tud-pses/ucboard/README.md

# ucboard
Firmware for the µController used in the pses robot.

For a more in depth documentation of the project,
please read the provided ucboard.pdf file in the repository.

You can also browse through the [wiki](https://github.com/tud-pses/ucboard/wiki) of this repository.
