tud-pses/ucboard/doc/latex/inc/kommunikation.tex

\chapter{Kommunikation}

\section{Prinzip}

Die Kommunikation mit dem ucboard ist textbasiert, so dass eine Bedienung über ein einfaches Terminalprogramm möglich ist. Dies ermöglicht ein einfaches Testen und Debuggen. Um dennoch ein einfaches Parsen der Nachrichten zu ermöglichen, besitzen diese ein definiertes Format.

In der Regel sind alle Nachrichten auch einfach lesbar. Um bezüglich der Messdatenerfassung etwas platzeffizienter zu sein, können diese jedoch optional als hex- oder base64-codierte Binärdaten versendet werden.

Ebenso wird in der Regel auf Prüfsummen verzichtet. Lediglich bei Messdaten, die als Binärdaten verschickt werden, kann optional eine CRC16-Prüfsumme angehängt werden. (Bei manchen Befehlen zum ucboard besteht die Möglichkeit, die wesentliche Zahl doppelt zu senden.)

Messdaten und Textnachrichten können vom ucboard ohne Auf"|forderung versendet werden. Ansonsten reagiert das ucboard auf Befehle, die an dieses geschickt werden. Dabei wird jeder Befehl durch eine Antwort quitiert.

\begin{itemize}
	\item Die Nachrichten zum ucboard sollen sich möglichst einfach Parsen lassen. Die Nachrichten bestehen aus einem oder mehreren, durch Leerzeichen getrennte Wörter. Der Typ eines Wortes ergibt sich aus dem ersten Zeichen:
		\begin{itemize}
			\item \texttt{A} - \texttt{Z} und \texttt{\_}: String
			\item \verb+~+: Optionsname
			\item \texttt{0} - \texttt{9} und \texttt{-}: Zahl
		\end{itemize}
	\item Besteht eine Nachricht aus mehreren Wörtern, so spielt die Anzahl der Leerzeichen zwischen den Wörtern keine Rolle. (Mindestens eines!)
\end{itemize}

Prinzipiell wird nicht zwischen Groß- und Kleinschreibung unterschieden.

Eine Nachricht beginnt mit einem Startzeichen und endet mit einem Endezeichen. Das Startzeichen kann variieren. Bei Nachrichten zum ucboard ist dieses \texttt{!} oder \texttt{?}. Nachrichten vom ucboard beginnen mit zwei Startzeichen. Das erste Zeichen ist immer \verb|\02| (STX), danach folgt \texttt{:}, \texttt{'} oder \texttt{\#}. Nach den Startzeichen kann, muss aber kein Leerzeichen folgen. Alle alphanumerischen Startzeichen (also nicht \verb|\02|) dürfen auch innerhalb der Nachrichten verwendet werden. Dort haben sie keine besondere Bedeutung.

Das Endezeichen ist \verb|\n| (newline) bei Nachrichten zum ucboard und \verb|\03| (ETX) bei Nachrichten vom ucboard.

Die Motivation hinter der unterschiedlichen Behandlung von Nachrichten zum und Nachrichten vom ucboard ist die, dass damit bei Nachrichten zum ucboard zu Debug-Zwecken ein einfaches Terminalprogramm verwendet werden kann, bei Nachrichten vom ucboard jedoch auch mehrzeiliger Text sinnvoll dargestellt werden kann und ein einfaches Identifizieren des Nachrichtenbeginns möglich ist.

Einzelne Zeilenumbrüche außerhalb von Nachrichten sind zu ignorieren. (Diese werden optional nach ETX vom ucboard verwendet, um die Darstellung im Terminalprogramm zu verbessern.)

\subsubsection{Zu ucboard}
\begin{itemize}
	\item Befehle beginnen mit \texttt{!}
	\item Abfragen beginnen mit \texttt{?}
	\item Antworten auf Fragen des ucboard (im interaktiven Modus) besitzen keinen speziellen Beginn. (Sie dürfen aber auch mit \texttt{!} oder \texttt{?} beginnen.
	\item Das Ende einer Nachricht wird ausschließlich durch \texttt{\textbackslash n} (newline) markiert
	\item Optionen beginnen mit \verb+~+. Wenn der Option ein Wert zugeordnet wird, dann wird dieser nach einem \texttt{=} angeschlossen. Dabei dürfen um das Gleichheitszeichen herum keine Leerzeichen stehen!
	\item Die Reihenfolge der Argumente spielt eine Rolle. Die Position der Optionen spielt keine Rolle. (Bei Verarbeiten im ucboard wird zunächst eine Liste der Argumente und eine Liste der Optionen erstellt. Die Information, ob eine Option am Anfang, zwischen zwei Argumenten oder am Ende stand geht dabei verloren.)
\end{itemize}

\subsubsection{Von ucboard}
\begin{itemize}
	\item Nachrichten beginnen immer mit \verb|\02| (STX).
	\item Direkte Antworten beginnen (nach STX) mit \texttt{:}
	\item Auch jeder Schreibbefehl sollte eine kurze Antwort zur Quittierung senden, \zB \verb+:ok\n+. Es wäre empfehlenswert, den gesetzten Wert zu wiederholen
	\item Fehler bei der Abarbeitung von Befehlen beginnen mit \texttt{:ERR(code)}, wobei \texttt{code} eine positive Ganzzahl als Fehlercode ist. Optional kann nach einem weiteren Doppelpunkt eine Beschreibung des Fehlers folgen: \texttt{:ERR(code):Beschreibung} 
	\item Textausgaben (Display-Funktion) beginnen (nach STX) mit \texttt{'}
	\item Fehlermeldungen sind Textausgaben. Diese beginnen mit \texttt{'ERR(code)}, wobei \texttt{code} eine positive Ganzzahl als Fehlercode ist. Optional kann nach einem weiteren Doppelpunkt eine Beschreibung des Fehlers folgen: \texttt{'ERR(code):Beschreibung} 
	\item Ohne Auf"|forderung versendete Messdaten beginnen (nach STX) mit \texttt{\#}.
	\item Wenn eine Nutzerinteraktion notwendig ist, dann sollte das letzte Zeichen vor dem Nachrichtendezeichen ein \texttt{?} oder \texttt{:} sein.
	\item Alle Nachrichten vom ucboard haben ETX (0x03) als Endzeichen. (Dadurch ist es möglich, eine mehrzeilige Ausgabe auf dem Terminalprogramm zu erzeugen.)
		\begin{itemize}
			\item Über eine -- aktuell noch fest eingestellte Option -- wird nach jedem ETX automatisch ein Zeilenumbruch geschickt. Dies dient der besseren Lesbarkeit. Es wäre jedoch besser, ein Terminalprogramm zu verwenden (\bzw zu schreiben), welches ETX durch einen Zeilenumbruch ersetzt. Damit wäre sowohl der Text besser lesbar als auch der Sparsamkeit Rechnung getragen.
			%\item Für die bessere Lesbarkeit ist es empfehlenswert, alle Textnachrichten mit einem Zeilenumbruch (vor ETX) abzuschließen. Lediglich bei hex- oder base64-basierten Messdatennachrichten wird dies nicht gemacht, da diese gerade für eine sparsame Kommunikation gedacht sind.
		\end{itemize}
\end{itemize}

\section{Hardware}

Das ucboard verfügt über zwei Schnittstellen für die Kommunikation mit dem PC. Zum einen kann über einen USB-Anschluss eine serielle Kommunikation aufgebaut werden und zum anderen kann eine RS232-Schnittstelle verwendet werden. Die RS232-Schnittstelle wird dabei nicht als Standard-D-SUB-Stecker (9-polig) angeboten, sondern als Wannensteckeranschluss. Dieser ist so belegt, dass eine direkte Verbindung zu den Anschlüssen des Onboard-PC über ein Flachbandkabel erfolgen kann.

Der dritte, "`reine"' UART-Anschluss ist für den Anschluss möglicher Erweiterungen und nicht die Kommunikation mit dem PC vorgesehen.\footnote{Man könnte auch noch darüber nachdenken, die dritte UART auch für die Kommunikation mit einem PC zu verwenden, da an dieser einfach ein Bluetooth-Adapter angeschlossen werden könnte. Damit wäre es möglich, auch ohne den Onboard-PC das Fahrzeug ferngesteuert zu betreiben.}

Die Parameter der Schnittstellen sind in \tabref{tab:Comm:UARTParam} zusammengefasst.

\begin{table}%
	\centering
	\caption{Einstellungen serielle Schnittstellen}
	\label{tab:Comm:UARTParam}
	\begin{tabular}{lcr}
			\mytoprule
			 & USB & RS232 \\
			\mymidrule
			Baudrate & 921\,600 & 115\,200 \\
			Datenbits & 8 & 8 \\
			Stopbits & 1 & 1 \\
			Parity & keine & keine \\
			Hardware-Flowcontrol & Nein & Nein \\
			\mybottomrule
	\end{tabular}\\
	\color[rgb]{1,0,0}{ToDo: Testen, welche Baudrate jeweils maximal möglich ist!} \textcolor[rgb]{0.75,0.75,0.75}{\footnotesize{Man könnte dies auch über einen Befehl einstellbar machen, und ein Rücksetzen darüber erreichen, dass beim Starten des ucboards \zB der Taster A betätigt wird. Aber das erscheint mir für diesen Zweck unnötig.}}
\end{table}

\section{Befehle}

\subsection{Übersicht}

\begin{table}[htbp]%
	\centering
	\caption{Übersicht über Hauptbefehle ucboard}
	\label{tab:Comm:Cmds}
	\begin{tabular}{ll}
		\mytoprule
		\verb|RESET| & Neustart ucboard \\
		\verb|VER| & Abfrage Softwareversion \\
		\verb|ID|	& Abfragen der Fahrzeug-ID \\
		\verb|SID| & Setzen und Abfragen der Session-ID \\
		\verb|TICS| & Abfrage ucboard-Zeit (Millisekunden nach (Neu)start) \\
		\verb|STEER| & Setzen und Abfragen des (Soll-)Lenkwinkels \\
		\verb|DRV| & Setzen und Abfragen der Fahrgeschwindigkeit \\
		\verb|DAQ| & Datenerfassung \\
		\verb|VOUT| & Ein- und Ausschalten \valunit{12}{V}-Ausgang (Kinect) \\
		\texttt{IMU} & Zum Parametrieren der IMU \\
		\texttt{MAG} & Zum Parametrieren des Magnetometers \\
		\texttt{US} & Zum Parametrieren der US-Sensoren \\
		\textcolor[rgb]{0.75,0.75,0.75}{\texttt{EEPROM}} & \textcolor[rgb]{0.75,0.75,0.75}{Zum Auslesen des EEPROM-Inhalts}\\
		\verb|LED| & Ansteuerung der LEDs A und B auf dem Board \\
		\mybottomrule
	\end{tabular}
\end{table}

\textbf{Wichtig:} Momentan werden numerische Eingaben noch nicht an allen Stellen daraufhin überprüft, ob es tatsächlich eine (Ganz)Zahl ist. Dies bedeutet, dass \zB Eingaben wie \verb|1000.|, \verb|1000.0| oder auch \verb|+1000| für Tausend eine unerwartete Zahl ergibt.

\subsection{Beschreibung}

\subsubsection{RESET}

Führt einen Neustart des ucboards durch.

\begin{verbatim}
	!RESET NOW
\end{verbatim}

\subsubsection{VER}

Fragt Versionsstring der ucboard-Software ab.

\begin{verbatim}
	?VER
	:0.1.x
\end{verbatim}

\subsubsection{ID}

Zur Abfrage der Fahrzeug-ID, also der Nummer, die über die Dipschalter auf der Platine eingestellt wird.

\begin{verbatim}
	?ID
	:4
\end{verbatim}

\subsubsection{SID}

Zum Abfragen und Setzen der Session-ID. Dies ist einfach eine Zahl, die nach einem Neustart des ucboards auf 0 gesetzt wird, und der beliebige \verb|uint32|-Werte gegeben werden können.

\begin{verbatim}
	?SID
	:0
\end{verbatim}

\begin{verbatim}
	!SID 25363
	:25363
\end{verbatim}

\begin{verbatim}
	?SID
	:25363
\end{verbatim}

\subsubsection{STEER}

Zum Setzen und Abfragen des Soll-Lenkwinkels (Servo-Vorgabe). Der Wert muss eine Ganzzahl zwischen $-1\,000$ und $1\,000$ sein.

Setzen:
\begin{verbatim}
	!STEER -200
	:-200
\end{verbatim}

Optionale Wiederholung des Arguments, um Fehlübertragungen zu detektieren:
\begin{verbatim}
	!STEER -200 -200
	:-200
\end{verbatim}

\begin{verbatim}
	!STEER -200 -201
	:ERR(269): Message corrupted! (The two values have to be equal!)
\end{verbatim}

Abfragen:
\begin{verbatim}
	?STEER
	:-200
\end{verbatim}

\subsubsection{DRV}

Zum Setzen und Abfragen der Fahrgeschwindigkeit. (\Bzw Motorspannung.)

Es gibt zwei Modi: Die "`gemanagte"' und die "`direkte"' Ansteuerung. Siehe dazu \secref{sec:hw:drivectrl}.

\paragraph{Gemanagte Ansteuerung}

Bei der gemanagten Ansteuerung erfolgt die Umschaltung von Vorwärts- und Rückwärtsfahrt automatisch. Zudem wird der gesetzte Wert in den Arbeitsbereich umgerechnet.

Vorwärtsfahrt:
\begin{verbatim}
	!DRV F 300
	:F 300
\end{verbatim}
Optionale Wiederholung des Arguments, um Fehlübertragungen zu detektieren:
\begin{verbatim}
	!DRV F 300 300
	:F 300
\end{verbatim}

\begin{verbatim}
	!drv f 300 301
	:ERR(269): Message corrupted! (The two values have to be equal!)
\end{verbatim}

Es sind Werte von -500 bis 1000 zulässig. Dabei entsprechen negative Werte Bremsen (aber nicht einer Rückwärtsfahrt!).

Die effektive Auf"|lösung ist geringer als der Stellbereich von 1000 es annehmen lässt. Tatsächlich können etwas weniger als 450 unterscheidbare Impulsbreiten, \dah Sollwerte, vorgegeben werden.

Bremsen
\begin{verbatim}
	!DRV F -500
	:F -500
\end{verbatim}
Gebremst wird vom Fahrtenregler automatisch nur bis zum Stillstand. Es erfolgt keine Rückwärtsfahrt.

Rückwärtsfahrt
\begin{verbatim}
	!DRV B 300
	:B 300
\end{verbatim}
Es sind Werte von 0 bis 500 zulässig. (Der Stellbereich des Fahrtenreglers ist rückwärts nur halb so groß wie vorwärts.)

Ausschalten des Fahrtenreglers:
\begin{verbatim}
	!DRV OFF
	:OFF
\end{verbatim}
Der Unterschied zwischen den Werten 0 und \verb|OFF| liegt darin, dass bei \verb|OFF| der Fahrtenregler vom Fahrakku getrennt wird, also tatsächlich ausgeschaltet ist. Der Fahrtenregler wird bei Übermittlung des nächsten Sollwertes ungleich \verb|OFF| automatisch wieder eingeschaltet, jedoch dauert dies einen Moment. (Das Einschalten wird auch mit einem Piepston des Fahrtenreglers begleitet.)

Abfragen:
\begin{verbatim}
	?DRV
	:F 300
\end{verbatim}

Abfragen der tatsächlichen Impulsbreite (vergleiche "`Direkte Ansteuerung"'):
\begin{verbatim}
	?DRV D
	:D -186
\end{verbatim}

\paragraph{Direkte Ansteuerung}
Bei der direkten Ansteuerung wird direkt die Impulsbreite vorgegeben, die an den Fahrtenregler übertragen wird. Dabei wird die Impulsbreite als die Abweichung in Mikrosekunden vom Neutralwert \valunit{1,5}{ms} angegeben. \Dah ein Wert von $-500$ entspricht der minimalen Impulsbreite (\dah Maximalwert \emph{vorwärts}) von \valunit{1}{ms} und ein Wert von 500 der maximalen Impulsbreite von \valunit{2}{ms}.

\begin{verbatim}
	!DRV D 200
	:D 200
\end{verbatim}

\paragraph{DMS}

Die Totmannschaltung (DMS -- Dead-man switch) soll insbesondere im Entwicklungsstatus der PC-Software und der Algorithmen verhindern, dass das Fahrzeug bei abgestürztem PC oder abgestürzten ROS-Nodes weiterfährt.

Dieser Parameter gibt die Zeit in Millisekunden an, innerhalb derer eine neue DRV-Nachricht erhalten sein muss. Wird diese Zeit ohne DRV-Nachricht überschritten, so wird der Motor gestoppt, \dah der Sollwert auf 0 (aber nicht \texttt{OFF}) gesetzt. Bei der nächsten \texttt{DRV}-Nachricht wird der Motor dann wieder angesteuert.

\begin{verbatim}
	!DRV ~DMS=1000
	:~DMS=1000
\end{verbatim}
Zum Abschalten der Sicherheitsschaltung dient der Wert \texttt{0}.

DRV kann auch ohne Parameter aufgerufen werden. Dann dient er nur dazu, die Zeitzählung der Totmannschaltung neu zu starten.

\begin{verbatim}
	!DRV
	:ok
\end{verbatim}

Abfrage der DMS-Abschaltzeit zusammen mit dem aktuellen DRV-Wert:
\begin{verbatim}
	?DRV ~DMS
	:OFF ~DMS=1000
\end{verbatim}

\subsubsection{DAQ}

Das Datenerfassungsmodul (DAQ -- Data Aquisition) dient als allgemeine Schnittstelle zur Übermittlung aller Sensorsignale. Dabei können Einzelabfragen vorgenommen werden (die angefragten Sensorwerte werden direkt als Antwort auf einen entsprechenden Befehl verschickt) als auch Gruppen von Sensorsignale eingerichtet werden, die dann automatisch vom ucboard an den PC geschickt werden.

Die Sensorsignale werden dabei hier als "`Kanäle"' bezeichnet. Die aktuell definierten Kanäle sind in \tabref{tab:Comm:DAQ:Signals} zusammengefasst.

\begin{table}[htbp]%
	\centering
	\caption{DAQ-Kanäle (Signale)}
	\label{tab:Comm:DAQ:Signals}
	\begin{tabular}{lp{8cm}lll}
		\mytoprule
		Kanal & Beschreibung & Einheit & Datentyp & Länge \\
		\mymidrule
		\verb|AX| & Beschleunigung $x$-Richtung & $\to$ \eqref{eq:hw:IMU:ACCScale} & \verb|int16_t| & 2 \\
		\verb|AY| & Beschleunigung $y$-Richtung & $\to$ \eqref{eq:hw:IMU:ACCScale} & \verb|int16_t| & 2 \\
		\verb|AZ| & Beschleunigung $z$-Richtung & $\to$ \eqref{eq:hw:IMU:ACCScale} & \verb|int16_t| & 2 \\
		\verb|GX| & Drehrate um $x$-Achse & $\to$ \eqref{eq:hw:IMU:GYROScale} & \verb|int16_t| & 2 \\
		\verb|GY| & Drehrate um $y$-Achse & $\to$ \eqref{eq:hw:IMU:GYROScale} & \verb|int16_t| & 2 \\
		\verb|GZ| & Drehrate um $z$-Achse & $\to$ \eqref{eq:hw:IMU:GYROScale} & \verb|int16_t| & 2 \\
		\verb|MX| & Magnetische Flussdichte in $x$-Achse & \valunit{0,15}{\upmu T} & \verb|int16_t| & 2\\
		\verb|MY| & Magnetische Flussdichte in $y$-Achse & \valunit{0,15}{\upmu T}  & \verb|int16_t| & 2\\
		\verb|MZ| & Magnetische Flussdichte in $z$-Achse & \valunit{0,15}{\upmu T}  & \verb|int16_t| & 2\\
		\verb|USF| & Abstand vorne & \valunit{0,1}{mm} & \verb|uint16_t| & 2 \\
		\verb|USL| & Abstand links & \valunit{0,1}{mm} & \verb|uint16_t| & 2 \\
		\verb|USR| & Abstand rechts & \valunit{0,1}{mm} & \verb|uint16_t| & 2 \\
		\verb|VSBAT| & Spannung Systemakku & mV & \verb|uint16_t| & 2\\
		\verb|VDBAT| & Spannung Fahrakku & mV & \verb|uint16_t| & 2\\
		\verb|HALL_DT| & Zeit zwischen den letzten beiden Impulsen des Hallsensors (eine Achtel Radumdrehung) & \valunit{0,1}{ms} & \verb|uint16_t| & 2\\
		\verb|HALL_DT8| & Zeit zwischen den letzten acht Impulsen des Hallsensors (eine Radumdrehung) & \valunit{1}{ms} & \verb|uint16_t| & 2\\
		\verb|HALL_CNT| & Anzahl der Sensorimpulse, Modulo 256 (Ein Sensorwert von "`1"' entspricht dabei immer eine ungeraden Zahl) & -- & \verb|uint8_t| & 1\\
		\verb|PBA| & Zähler Betätigung Taster A, Modulo 256 (Gerade Werte: Unbetätigt, Ungerade Werte: Betätigt)  & -- & \verb|uint8_t| & 1\\
		\verb|PBB| & wie \verb|PBA| für Taster B & -- & \verb|uint8_t| & 1\\
		\verb|PBC| & wie \verb|PBA| für Taster C & -- & \verb|uint8_t| & 1\\
		\mybottomrule
	\end{tabular}
\end{table}

Zur Übermittlung von Fehlerwerten sind bestimmte Zahlenwerte oder Textausgaben vorgesehen, die in \tabref{tab:Comm:DAQ:SpecialValues} aufgeführt sind. Dabei ist "`keine Daten vorhanden"' ein Wert, der vom DAQ-Modul selber gesetzt werden, wenn keine gültigen Daten vorliegen. Die einzelnen Sensormodule geben im Fehlerfall entweder "`Messfehler"' (bei einzelnen Messfehlern oder Messaussetzern) oder "`Sensorfehler"' (ein größeres Sensorproblem, \dah es ist in diesem Fall mit dem Ausfall aller (weiteren) Messwerten zu rechnen) zurück.

\begin{table}[htbp]%
	\centering
	\caption{Fehlerwerte}
	\label{tab:Comm:DAQ:SpecialValues}
	\subfloat[Binärcodierung]{%
		\begin{tabular}{lcccccc}
			\mytoprule
			Datentyp & \texttt{uint32\_t} & \texttt{int32\_t} & \texttt{uint16\_t} & \texttt{int16\_t} & \texttt{uint8\_t} & \texttt{int8\_t} \\
			\mymidrule
			Keine Daten vorhanden & \texttt{0xFFFFFFFF} & \texttt{0x7FFFFFFF} & \texttt{0xFFFF} & \texttt{0x7FFF} & \texttt{0xFF} & \texttt{0x7F} \\
			Messfehler & \texttt{0xFFFFFFFE} & \texttt{0x7FFFFFFE} & \texttt{0xFFFE} & \texttt{0x7FFE} & \texttt{0xFE} & \texttt{0x7E} \\
			Sensorfehler & \texttt{0xFFFFFFFD} & \texttt{0x7FFFFFFD} & \texttt{0xFFFD} & \texttt{0x7FFD} & \texttt{0xFD} & \texttt{0x7D} \\
			Wert zu groß oder zu klein  & \texttt{0xFFFFFFFC} & \texttt{0x7FFFFFFC} & \texttt{0xFFFC} & \texttt{0x7FFC} & \texttt{0xFC} & \texttt{0x7C} \\
			Wert zu groß  & \texttt{0xFFFFFFFC} & \texttt{0x7FFFFFFC} & \texttt{0xFFFC} & \texttt{0x7FFC} & \texttt{0xFC} & \texttt{0x7C} \\
			Wert zu klein & \texttt{0xFFFFFFFB} & \texttt{0x7FFFFFFB} & \texttt{0xFFFB} & \texttt{0x7FFB} & \texttt{0xFB} & \texttt{0x7B} \\
			\mybottomrule
		\end{tabular}}\\
	\subfloat[Textausgabe]{%
		\begin{tabular}{lc}
			\mytoprule
			 & \\
			\mymidrule
			Keine Daten vorhanden & \texttt{[-{}-{}-]}  \\
			Messfehler & \texttt{[mfault]}  \\
			Sensorfehler & \texttt{[fault]} \\
			Wert zu groß oder zu klein & \texttt{[range]} \\
			Wert zu groß  & \texttt{[over]}  \\
			Wert zu klein & \texttt{[under]} \\
			\mybottomrule
		\end{tabular}}
\end{table}

\paragraph{Allgemeines}

Alle aktuell definierten Kanäle können mit \verb|?DAQ CHS| abgefragt werden:
\begin{verbatim}
	?DAQ CHS
	:14
	AX         | acc. ahead                     | opt-dep.!       | 1     | I16 
	AY         | acc. left                      | opt-dep.!       | 1     | I16 
	[...]
	HALL_DT8   | delta time full rev.           | 1 ms            | undef | U16 
\end{verbatim}
Dabei beinhalten die Spalten die folgenden Informationen
\begin{itemize}
	\item Name
	\item Beschreibung
	\item Einheit (\verb|opt-dep.!| bedeutet, dass die Einheit von den jeweiligen Sensoreinstellungen abhängt.)
	\item Abtastzeit in Millisekunden (\verb|undef| bedeutet, dass das entsprechende Sensormodul keine feste Abtastzeit der Messwerte garantiert.)
	\item Datentyp
\end{itemize}

Die Informationen zu einem speziellen Kanal können über
\begin{verbatim}
	?DAQ CH name
\end{verbatim}
abgefragt werden:
\begin{verbatim}
	?DAQ CH USF
	:USF        | ultrasonic front distance      | 0.1 mm          | undef | U16
\end{verbatim}

\paragraph{Einzelabfrage von Werten}

Zur Abfrage von Einzelwerten dient der Subbefehl \verb|GET|:
\begin{verbatim}
	?DAQ GET chname1 [chname2 [chname3 [...]]] [~AGE] [~TICS]
\end{verbatim}
Diesem muss mindestens der Name eines Kanals übergeben werden. Es können aber auch mehrere Kanäle auf einmal abgefragt werden. Die Option \verb|~AGE| gibt zu \emph{jedem} Wert das Alter in Tics (\dah ms) zwischen dem Zeitpunkt der Datenerfassung und der Datenabfrage zurück. Die Option \verb|~TICS| gibt zu \emph{jedem} Wert den Erfassungszeitpunkt in Tics zurück. Sind beide Optionen gewählt, dann wird immer AGE vor TICS zurückgegeben, unabhängig von der Reihenfolge der Optionen.

Beispiele:

\begin{itemize}
	\item Einzelabfrage des Sensorwertes des vorderen Ultraschallsensors
		\begin{verbatim}
			?DAQ GET USF
			:1860
		\end{verbatim}
	\item Ausgabe des Alters des Messwertes
		\begin{verbatim}
			?DAQ GET ~AGE USF
			:1860 68
		\end{verbatim}
	\item Abfrage aller Ultraschallwerte, jeweils mit Alter
		\begin{verbatim}
			?DAQ GET ~AGE USL USF USR
			:487 72 | 1860 75 | 4293 85
		\end{verbatim}
	\item Ausgabe der ucboard-Zeit des Messwerts
		\begin{verbatim}
			?DAQ GET ~TICS USF
			:1860 3059246
		\end{verbatim}
\end{itemize}

\paragraph{Automatische Messgruppen}

Es stehen zwanzig parametrierbare Messgruppen zur Verfügung, die zum automatischen Verschicken von Messdaten verwendet werden. In diesen können bis zu zehn verschiedene Kanäle (Sensorwerte) zusammengefasst werden. Neben den normalen Kanälen stehen noch die in \tabref{tab:Comm:DAQ:SpecialChannels} aufgeführten "`Sonderkanäle"' zur Verfügung, die Metadaten zu den Datensätzen enthalten. (Diese stehen bei der Einzelabfrage über \verb|?DAQ GET chname| nicht zur Verfügung.)

Es wird je Gruppe immer nur ein Messdatensatz gepuffert. Kann dieser nicht verschickt werden, bis die nächste Abtastung der Gruppe erfolgt ist, so wird dieser verworfen. Dabei werden alle Gruppen gleichberechtigt behandelt, \dah es erfolgt keine Bevorzugung von Messgruppen mit kleiner Abtastzeit. Damit ist die Wahrscheinlichkeit gering, dass bei langsam abgetasteten Messgruppen Daten verlorengehen, auch wenn viel Bandbreite für Messgruppen mit kleiner Abtastzeit belegt wird.\footnote{An dieser Stelle muss noch angemerkt werden, dass das Management der zu versendenden Daten im Idle-Task des ucboards erfolgt. \Dah während der Datenerfassung im SysTick-Task werden keine neuen Daten zum Verschicken bereit gemacht, auch wenn der letzte Datensatz abgearbeitet ist. Damit ist der erreichbare Datendurchsatz kleiner als der sich theoretisch aus der Baudrate ergebenden Wert. Dies kann \bzw sollte in Zukunft noch geändert werden. Bisher benötigt der SysTick-Task weniger als \valunit{200}{\upmu s}. Damit würde im ungünstigsten Fall die Datenrate ein Fünftel "`verlieren"'.}

Eine Messgruppe wird über den Subbefehl \verb|GRP| definiert.
\begin{verbatim}
	!DAQ GRP grpnb chname1 [chname2 [chname3 [...]]] [~option1] [~option2] [...]
\end{verbatim}
Die Gruppennummer \verb|grpnb| muss eine Ganzzahl zwischen 0 und 19 sein.

Die Möglichkeiten der Gruppendefinition wird zunächst an Beispielen demonstriert. Danach werden die Optionen genauer beschrieben.
\begin{itemize}
	\item Gruppe 1 enthält die Werte des Ultraschalls. Es wird gesendet, wenn alle Ultraschallwerte vorliegen, wobei maximal \valunit{10}{ms} nach dem Erfassen des ersten Wertes gewartet wird. Die Daten werden base64-codiert und mit einer CRC16-Prüfsumme verschickt.
		\begin{verbatim}
			!DAQ GRP 1 ~ALL=10 ~ENC=B64 ~CRC _TIC USL USF USR 
		\end{verbatim}
		(Die Reihenfolge der Kanalnamen (\verb|_TIC|, \verb|USL|, \verb|USF|, \verb|USR|) spielt eine Rolle, da die Messwerte ohne Namen in dieser Reihenfolge ausgegeben werden. Die Reihenfolge der Optionen und ob diese am Anfang oder Ende oder auch zwischen den Kanalnamen stehen spielt keine Rolle.)
	\item Gruppe 2 enthält die Spannungen der beiden Akkus, wobei immer eine Nachricht verschickt wird, sobald eine neue Spannung gemessen ist.
		\begin{verbatim}
			!DAQ GRP 2 ~ANY VSBAT VDBAT 
		\end{verbatim}
	\item Gruppe 3 enthält die Beschleunigungswerte in der Ebene und die Gierrate. Die Daten werden alle \valunit{10}{ms} verschickt. Dabei werden alle innerhalb der \valunit{10}{ms} erfassten Daten gemittelt.
		\begin{verbatim}
			!DAQ GRP 3 ~TS=10 ~AVG ~ENC=B64 ~CRC AX AY GZ 
		\end{verbatim}
\end{itemize}

Optionen:
\begin{itemize}
	\item Modus Abtastung
		\begin{itemize}
			\item \verb+~ALL[=maxwait]+: Sendet, wenn zu allen Gruppenkanäle neue Daten vorhanden sind. Wenn \verb+maxwait+ gegeben ist, dann wird nach dem ersten neuen Wert maximal diese Zeit in Millisekunden gewartet, bis die Daten verschickt werden.\footnote{Dies ist \zB für die US-Sensoren gedacht, deren Daten meist an nacheinander liegenden Zeitschritten ankommen.}
			\item \verb+~ANY+: Sendet, wenn zu einem der Gruppenkanäle ein neues Datum vorhanden ist.
			\item \verb+~TS=Ts+: Abtastzeit in Millisekunden. (Muss ein ganzes Vielfaches der Abtastzeiten aller Kanäle des Paketes sein.)
			\begin{itemize}
				\item \verb+~AVG[=Ta]+: Mittelung über Zeitraum \verb|Ta|. (Nur im Abtastmodus \verb|TS| verfügbar.) Wenn die Option \verb|AVG| verwendet wird, dann müssen alle Gruppenkanäle die gleiche Abtastzeit besitzen. \verb|Ta| darf dabei maximal \verb|Ts| sein und muss ein ganzes Vielfaches der Abtastzeit der Gruppenkanäle sein. Wenn kein \verb|Ta| angegeben ist, dann wird \verb|Ta| = \verb|Ts| gesetzt.\\
				Diese Mittelung kann damit bezüglich der Sensorabtastzeit $T_\mrm{s,sig}$ über die Übertragungsfunktion
				\begin{align*}
					G_\mrm{avg}(z) = \frac{\frac{1}{n_\mrm{avg}} \cdot ( z^{n_\mrm{avg}-1} + z^{n_\mrm{avg}-2} + \cdots + 1)}{z^{n_\mrm{avg}-1}}
				\end{align*}
				mit $n_\mrm{avg} = \mathtt{Ta}/T_\mrm{s,sig}$ ausgedrückt werden. Über \verb+~TS=Ts+ wird dann eine Unterabtastung mit dem Faktor $\mathtt{Ts}/T_\mrm{s,sig}$ vorgenommen.
			\end{itemize}

		\end{itemize}
	\item \verb+~SKIP=n+: Überspringt \texttt{n} Werte. \Dah bei einem Wert von neun wird jeder zehnte Wert verwendet. Dieses Überspringen wird nach allen anderen Berechnungen und Abfragen durchgeführt. Diese Option dient primär zum Debuggen (um die Menge an ausgegebenem Text zu reduzieren), kann aber auch zur Unterabtastung für Kanäle ohne feste Abtastzeit verwendet werden. (Dabei ist dann aber keine Mittelung möglich.)
	\item \verb+~ENC=B64|HEX|ASCII+: Nachricht wird base64-codiert (ohne Padding), Hex-codiert oder Ascii-codiert. ASCII meint hierbei "`lesbaren Text"'. Standardwert ist ASCII.
	\item \verb+~CRC+: CRC16-Prüfsumme (Nur wenn ENC = B64 oder HEX)\\
		Berechnung mit:
		\begin{lstlisting}[style=C_colored_smallfont]
// from Antonio Pires, http://stackoverflow.com/questions/10564491/function-to-calculate-a-crc16-checksum

// CRC-16-CCITT (polynom 0x1021)

uint16_t crc16(uint8_t* data_p, uint16_t length)
{
	uint8_t x;
	uint16_t crc = 0xFFFF;

    while (length--)
    {
        x = (crc >> 8) ^ (*data_p++);
        x ^= (x >> 4);
        crc = (crc << 8) ^ ((uint16_t)(x << 12)) ^ ((uint16_t)(x <<5)) ^ ((uint16_t)x);
    }

    return crc;
}
		\end{lstlisting}
	\item \verb+~AGE+ und \verb+~TICS+: Wie bei Einzelwertabfrage. Damit wird \emph{jedem} Wert das Alter sowie der Erfassungszeitpunkt hinzugefügt. (Wenn beide Optionen gewählt sind, dann immer in der Reihenfolge "`Age -- Tics"'.) Die Werte werden bei der Ascii-Codierung immer innerhalb der senkrechten Striche des Kanals geschrieben. Bei Binärcodierungen werden diese Werte jeweils als \valunit{32}{bit}-Werte jeweils hinter den betreffenden Messwert eingefügt. Diese Optionen dienen lediglich zum Debuggen. Im "`Normalbetrieb"' sollten diese aufgrund des großen Platzbedarfs nicht verwendet werden!\footnote{Das Alter \texttt{AGE} bezieht sich auf den Abtastzeitpunkt des Datensatzes, nicht auf den Zeitpunkt des Versendens. Der Wert ist damit nur bei der Abtastart \texttt{ALL} relevant, da dort die Daten einer Gruppe zu unterschiedlichen Zeitpunkten abgetastet sein können. Die Zeitdifferenz zwischen Abtastzeitpunkt und Versenden kann durch den Sonderkanal \texttt{\_DLY} abgefragt werden. (Somit ist das tatsächliche Alter \texttt{AGE} + \texttt{\_DLY} plus die Zeit zur Datenübermittlung und Verzögerungen innerhalb des Betriebssystem des PCs.)}
\end{itemize}

\begin{table}[htbp]%
	\centering
	\caption{"`Sonderkanäle"' mit Metadaten}
	\label{tab:Comm:DAQ:SpecialChannels}
	\begin{tabular}{lp{10cm}lll}
		\mytoprule
		Signal & Beschreibung & & Datentyp & Länge \\
		\mymidrule
		\verb|_CNT| & Anzahl der verschickten Datensätze der Gruppe &  & \verb|uint32_t| & 4 \\
		\verb|_CNT16| & die niederwertigen \valunit{16}{bits} von \verb|_CNT| &  & \verb|uint16_t| & 2 \\
		\verb|_CNT8| & die niederwertigen \valunit{8}{bits} von \verb|_CNT| &  & \verb|uint8_t| & 1 \\[2mm]
		\verb|_TICS| & ucboard-Zeit (tics) der Erfassung des ersten Datums & ms & \verb|uint32_t| & 4 \\
		\verb|_TICS16| & die niederwertigen \valunit{16}{bits} von \verb|_TIC| & ms & \verb|uint16_t| & 2 \\
		\verb|_TICS8| & die niederwertigen \valunit{8}{bits} von \verb|_TIC| & ms & \verb|uint8_t| & 1 \\[2mm]
		\verb|_DTICS| & Delta der ucboard-Zeit zwischen ersten und letztem Datum & ms & \verb|uint32_t| & 4 \\
		\verb|_DTICS16| & min\{\verb|_DTICS|, 65\,535\} & ms & \verb|uint16_t| & 2 \\
		\verb|_DTICS8| & min\{\verb|_DTICS|, 255\} & ms & \verb|uint8_t| & 1 \\[2mm]
		\verb|_DLY| & Zeit zwischen Datensatzerstellung und Versenden, bei 255 gesättigt & ms & \verb|uint8_t| & 1 \\
		\mybottomrule
	\end{tabular}
\end{table}

Weitere Funktionen zu Messgruppen:
\begin{itemize}
	\item Anzeige aller Gruppeninformationen
		\begin{verbatim}
			?DAQ GRPS
			:[...]
		\end{verbatim}
	\item Anzeigen Informationen zur Gruppe 1
		\begin{verbatim}
			?DAQ GRP 1
			:[...]
		\end{verbatim}
	\item Löschen von Gruppe 1
		\begin{verbatim}
			!DAQ GRP 1 ~DELETE
			:ok
		\end{verbatim}
	\item Deaktivieren von Gruppe 1
		\begin{verbatim}
			!DAQ GRP 1 ~DEACTIVATE
			:ok
		\end{verbatim}
	\item Aktivieren von Gruppe 1
		\begin{verbatim}
			!DAQ GRP 1 ~ACTIVATE
			:ok
		\end{verbatim}
		(Standardmäßig ist eine Gruppe nach der (Neu-)Definition aktiviert. Dies kann unterbunden werden, indem die Option \verb|~DEACTIVATE| in die Definition mit aufgenommen wird.)
\end{itemize}

Starten und Anhalten der Erfassung und Übermittlung der Messdaten
\begin{itemize}
	\item Starten der Datenerfassung
		\begin{verbatim}
			!DAQ START
			:started
		\end{verbatim}
	\item Anhalten der Datenerfassung
		\begin{verbatim}
			!DAQ STOP
			:stopped
		\end{verbatim}
	\item Abfrage Status der Datenerfassung
		\begin{verbatim}
			?DAQ
			:stopped
		\end{verbatim}
\end{itemize}

Die Neudefinition einer Gruppe erfolgt durch einfaches Überschreiben der Gruppendefinition. Dabei ist zu beachten, dass \emph{aktive} Gruppen nur dann überschrieben werden können, wenn die Datenerfassung angehalten ist (\texttt{!DAQ STOP}).

\paragraph{Binärdaten}
Bei \verb|ENC| = \verb|B64| und \verb|HEX| werden die Daten als Binärdaten verschickt.

Die Kanalnummer und der folgende Doppelpunkt immer in ASCII-Codierung versendet. Darauf folgen ohne Leer- oder Trennzeichen die einzelnen Messdaten mit der jeweils für den Kanal gültigen Breite.

\begin{verbatim}
	!daq grp 1 usl usf usr ~all=20
	:ok
	!daq grp 2 usl usf usr ~all=20 ~enc=hex
	:ok
	!daq grp 3 usl usf usr ~all=20 ~enc=hex ~crc
	:ok
	!daq grp 4 usl usf usr ~all=20 ~enc=b64
	:ok
	!daq grp 5 usl usf usr ~all=20 ~enc=b64 ~crc
	:ok
	!daq start
	:started
\end{verbatim}

\begin{verbatim}
	#1:806 | 4561 | 4075
	#2:2603D111EB0F
	#3:2603D111EB0F68CF
	#4:JgPREesP
	#5:JgPREesPaM8
\end{verbatim}

\paragraph{Sonstiges}

Die Definition einer Messgruppe, die nur aus Sonderkanälen besteht, ist möglich. Dies ist jedoch -- wenn überhaupt -- nur mit der Abtastart \verb|TS| sinnvoll, da bei \verb|ANY| und \verb|ALL| nie ein Datensatz verschickt werden würde.

So kann mit
\begin{verbatim}
	!daq grp 1 _cnt8 _dly ~Ts=10 ~enc=b64
\end{verbatim}
ein "`Taktgeber"' erzeugt werden, der alle \valunit{10}{ms} einen Wert schickt. Über \verb|_CNT8| kann dabei festgestellt werden, ob Werte übersprungen wurden, und mit \verb|_DLY|, ob der aktuelle Wert verzögert wurde.

\subsubsection{VOUT}

Einschalten der Kinect-Spannung
\begin{verbatim}
	!VOUT ON
	:ON
\end{verbatim}

Abschalten der Kinect-Spannung
\begin{verbatim}
	!VOUT OFF
	:OFF
\end{verbatim}

Abfragen Zustand
\begin{verbatim}
	?VOUT
	:OFF
\end{verbatim}

\subsubsection{US}

\paragraph{Aktiveren und Deaktivieren der US-Sensoren}

(Nach einem Neustart des ucboards sind die US-Sensoren aktiv.)

Aktivieren der US-Sensoren
\begin{verbatim}
	!US ON
	:ON
\end{verbatim}

Deaktivieren der US-Sensoren
\begin{verbatim}
	!US OFF
	:OFF
\end{verbatim}

Abfragen Zustand der US-Sensoren
\begin{verbatim}
	?US
	:OFF
\end{verbatim}

\paragraph{Einstellungen US-Sensoren}

Es können die beiden Parameter "`Range"' und "`Gain"' eingestellt werden. (Es wird immer für alle drei US-Sensoren der selbe Wert genommen.) Für die Bedeutung der Parameter und deren Zahlenwerte siehe das Datenblatt des Sensors!

Setzen der Einstellungen:
\begin{verbatim}
	!US OPT ~RANGE=100 ~GAIN=10
	:~RANGE=100 ~GAIN=10   [4343 mm, 25 ms]
\end{verbatim}
(Es kann auch nur \verb|~RANGE| oder \verb|~GAIN| gesetzt werden.)

In eckigen Klammern wird die Entsprechung des Range-Parameters in Millimetern und Millisekunden ausgegeben. Die tatsächliche Abtastzeit wird ein paar Millisekunden über diesem Wert liegen, da ein gewisser Overhead vorhanden ist.

Abfragen der aktuellen Einstellungen:
\begin{verbatim}
	?US OPT
	:~RANGE=100 ~GAIN=10   [4343 mm, 25 ms]
\end{verbatim}

\paragraph{Pingen der US-Sensoren}

Mit 
\begin{verbatim}
	!US PING
	:ok
\end{verbatim}
wird ein Ping für jede der sechzehn möglichen I2C-Adressen des Ultraschallmoduls ausgeführt. Das Pingen funktioniert nur, wenn die US-Sensoren ausgeschaltet sind.

Das Ergebnis wird nicht direkt als Antwort auf den Befehl, sondern als Textausgabe über die Display-Funktion übertragen: 
\begin{verbatim}
	'ping:
	224 = ok
	226 = ok
	228 = ok
	230 = -
	232 = -
	[...]
	254 = -
\end{verbatim}

\paragraph{Änderung der I2C-Bus-Adresse}

Das Programm geht von der in \tabref{tab:usaddresses} aufgeführten Zuordnung der Sensoren (anhand der I2C-Bus-Adresse) zu deren Position aus. Wird ein Sensor ausgetauscht, muss dessen Adresse überprüft (\verb|!US PING|) und gegebenenfalls geändert werden.

\begin{table}[htb]%
	\centering
	\caption{Zuordnung der I2C-Bus-Adressen zur Position der US-Sensoren}
	\label{tab:usaddresses}
	\begin{tabular}{lc}
		\mytoprule
		Position & Adresse \\
		\mymidrule
		links & 224 \\
		vorne & 226 \\
		rechts & 228 \\
		\mybottomrule
	\end{tabular}
\end{table}

Um die Adresse zu ändern, muss der betreffende Sensor nach dem Datenblatt alleine am Bus hängen. (Dies wird im Programm auch überprüft.) Die Adressänderung erfolgt mit
\begin{verbatim}
	!US CHGADDR old new
\end{verbatim}
Dabei ist \verb|old| die aktuelle (alte) Adresse und \verb|new| die neue Adresse, die gesetzt werden soll.

Beispiel:
\begin{verbatim}
	!US CHGADDR 224 226
	:ok
\end{verbatim}

Die Erfolgsmeldung \bzw mögliche Fehlermeldungen werden nicht direkt als Antwort auf den Befehl gesendet, sondern als Textausgabe über die Display-Funktion übertragen.

\subsubsection{IMU}

Setzen der Einstellungen:
\begin{verbatim}
	!IMU OPT ~ARANGE=8 ~AFILT=3 ~GRANGE=1000 ~GFILT=0
	:~ARANGE=8 ~AFILT=3 ~GRANGE=1000 ~GFILT=0   [A: 45 Hz, G: 250 Hz]
\end{verbatim}
(Es brauchen nicht alle Optionen gesetzt zu werden.)

\verb|ARANGE| gibt den Messbereich des Beschleunigungssensors in $g$ an und kann auf 2, 4, 8 oder 16 gesetzt werden. \verb|GRANGE| gibt den Messbereich des Gyrometers in Grad pro Sekunde an und kann auf 250, 500, 1000 oder 2000 gesetzt werden. Die möglichen Werte für die Filter sind auf \pagerefh{tab:hw:imufilters} in \tabref{tab:hw:imufilters:acc} (\verb|AFILT|) \bzw \tabref{tab:hw:imufilters:gyro} (\verb|GFILT|) aufgeführt.

Abfragen der aktuellen Einstellungen:
\begin{verbatim}
	?IMU OPT
	:~ARANGE=8 ~AFILT=3 ~GRANGE=1000 ~GFILT=0   [A: 45 Hz, G: 250 Hz]
\end{verbatim}

\subsubsection{MAG}

Setzen der Einstellungen:
\begin{verbatim}
	!MAG OPT ~USEASA=1
	:~USEASA=1
\end{verbatim}

\verb|USEASA| gibt an, ob die im Magnetometer fest gespeicherten Korrekturwerte für die Sensitivität verwendet werden sollen. Dabei bedeutet der Wert \verb|1|, dass die Werte verwendet werden und der Wert \verb|0|, dass die Werte nicht verwendet werden. Der Wert nach einem Neustart ist \verb|1|.

Abfragen der aktuellen Einstellungen:
\begin{verbatim}
	?MAG OPT
	:~USEASA=1
\end{verbatim}

Abfrage der Korrekturwerte:
\begin{verbatim}
	?MAG ASA
	:176 176 165
\end{verbatim}
Diese Werte entsprechen der Reihenfolge nach den Korrekturwerten der $x$-, $y$- und $z$-Achse, gezählt in Fahrzeugkoordinaten. (Damit entsprechen diese Werte den Registern \verb|ASAY|, \verb|ASAX| und \verb|ASAZ| des Magnetometers.)

Da es sich bei den Korrekturwerten um fest gespeicherte Werte im Magnetometer handelt, können diese nicht verändert werden. {\color[rgb]{0.75,0.75,0.75} Eine Vorgabe von eigenen Kalibrierungswerten ist für die Zukunft vorgesehen. Momentan muss eine Kalibrierung des eingebauten Sensors, wenn gewünscht, aber noch auf dem PC erfolgen.}

\subsubsection{LED}

Setzen der LEDs:
\begin{verbatim}
!LED id seq [id2 seq]
\end{verbatim}
\verb|id| ist \verb|A| oder \verb|B| und bezeichnet die LED. Der gewünschte Modus der gewählten LED wird mit \verb|seq| angegeben. Dies kann entweder einfach \verb|ON|, \verb|OFF| oder \verb|TOG|, oder eine Sequenz von Ein- und Ausschaltdauern sein:
\begin{verbatim}
[0] ton toff [ton2 toff2 [ton3 toff3 [...]]]
\end{verbatim}
Die An- und Ausschaltzeiten sind dabei in \valunit{10}{ms} gegeben. Diese Sequenz muss aus einer geraden Anzahl von positiven Ganzzahlen bestehen. Es sind maximal zehn Paare an Ein- und Ausschaltdauer möglich, also maximal zwanzig Zahlen.\footnote{Es ist dabei zu beachten, dass in der aktuellen Implementierung ein Befehl maximal 22 Parameter/Optionen besitzen kann.} Die optionale führende \verb|0| invertiert An- und Ausschalten.

Anschalten der LED A:
\begin{verbatim}
	!LED A ON
	:ok
\end{verbatim}
Ausschalten der LED A und gleichzeitig Einschalten der LED B:
\begin{verbatim}
	!LED A OFF B ON
	:ok
\end{verbatim}
Toggeln der LED A:
\begin{verbatim}
	!LED TOG
	:ok
\end{verbatim}
(Wenn die LED A vorher im Sequenzmodus ist, wird diese ausgeschaltet.)

Blinken der LED A mit \valunit{0,5}{Hz}, 50\,\%/50\,\%: 
\begin{verbatim}
	!LED A 100 100
	:ok
\end{verbatim}

Verschiedene Befehle werden nicht synchronisiert. \Dah mit
\begin{verbatim}
	!LED A 100 100
	:ok
	
	!LED B 100 100
	:ok
\end{verbatim}
blinken A und B jeweils mit \valunit{0,5}{Hz}, 50\,\%/50\,\%, jedoch aller Wahrscheinlichkeit nach versetzt.

Um ein synchrones Blinken zu erhalten, können die Sequenzen im gleichen Befehl gesetzt werden:
\begin{verbatim}
	!LED A 100 100 B 100 100
	:ok
\end{verbatim}

Soll ein gegenphasiges Blinken erzeugt werden, kann die Sequenz der LED B invertiert werden:
\begin{verbatim}
	!LED A 50 50 B 0 50 50
	:ok
\end{verbatim}

Werden mit einem Befehl für die gleiche LED mehrere Modi angegeben (\zB \verb|!LED A ON A 10 90|), so zählt der zuletzt angegebene Modus.

Ist die Nachricht fehlerhaft, wird diese komplett verworfen. \Dah bei \verb|!LED A ON B 30| wird auch nicht die LED A eingeschaltet, obwohl dieser Teil der Nachricht noch korrekt wäre, da der zu B gehörende Teil fehlerhaft ist.
