tud-pses/ucboard/ucboard.pdf

# Beschreibung Fahrzeug und ucboard

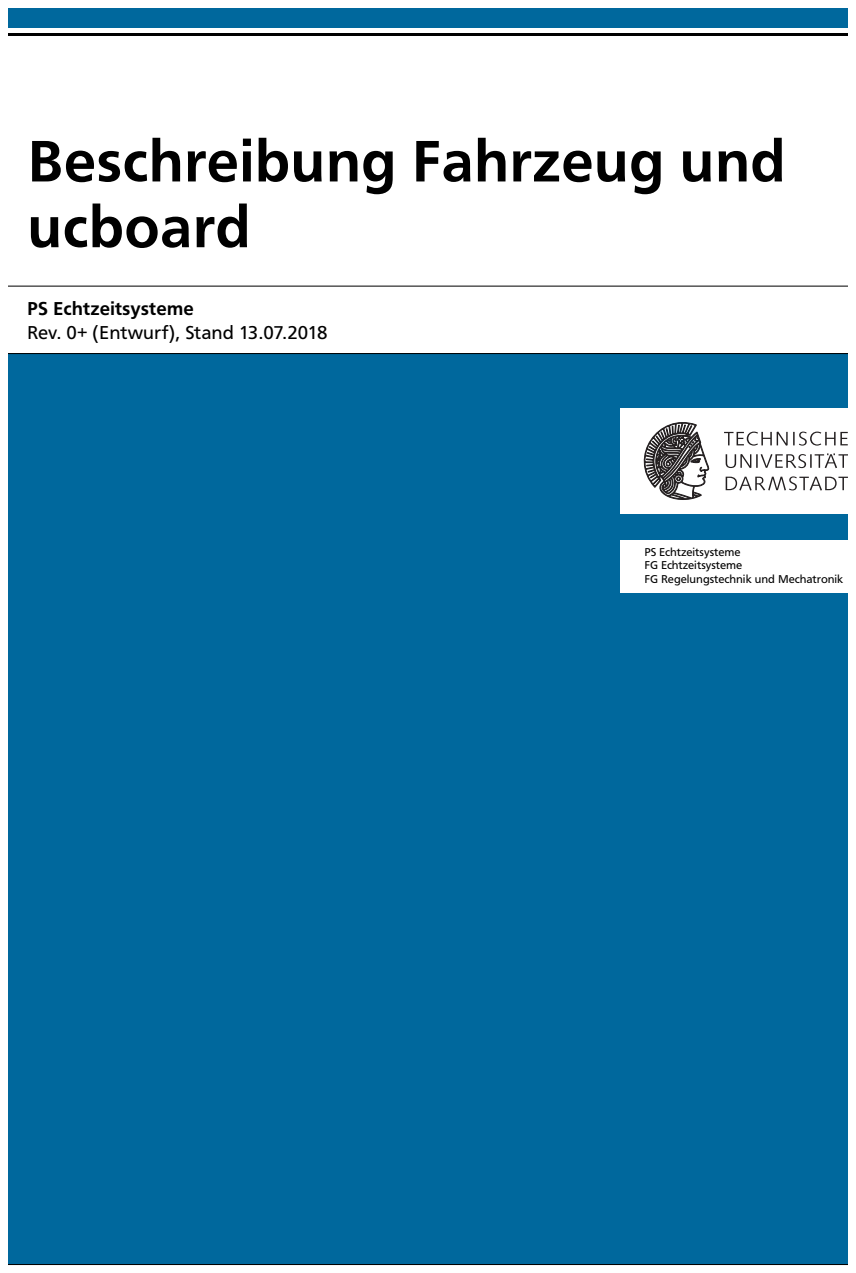
[picture p1: page 1]

PS Echtzeitsysteme
Rev. 0+ (Entwurf), Stand 13.07.2018

FG Echtzeitsysteme
FG Regelungstechnik und Mechatronik

# Inhaltsverzeichnis

I. Anwenden | 3
1. Fahrzeuge | 4
2. Kommunikation | 11
II. Entwickeln und Anpassen | 28
3. Git-Repository | 29
4. Flashen | 32
5. Programmierung | 34

6. Schaltungsentwurf | 37
7. Aufbau Fahrzeug | 38

Teil I.

# Anwenden

# 1 Fahrzeuge

1.1 Fahrgestelle

Tabelle 1.1.: Technische Daten
Radstand | 258mm
Spurweite | 155mm
Masse | kg

1.2 Aktorik

1.2.1 Lenkung

Die Lenkung ist als Achsschenkellenkung ausgeführt und wird über ein normales Modellbauservo angetrieben.

Das Servo stellt (über einen integrierten P-Regler) einen Sollwinkel, welcher sich über eine Mechanik auf einen Lenkwinkel der Räder überträgt.

Die Kennlinie „Servowinkel - Lenkwinkel“ ist nicht dokumentiert.

Die Ansteuerung des Servos, d. h. die Vorgabe eines Soll-Servowinkels, erfolgt über ein PWM-Signal. Dieses hat eine Frequenz von 50 Hz (wobei diese nicht sonderlich wesentlich ist) mit Impulsbreiten Tpuls zwischen 1ms und 2ms (die wesentlich sind).

Dabei bedeutet eine Impulsbreite von 1,5ms die Neutralstellung des Servos, welches (näherungsweise) einer Geradeausstellung der Räder entsprechen sollte. Ein Impulsbreite von 2ms bedeutet eine maximale Auslenkung des Servos gegen den Uhrzeigersinn (bei Blick auf die Servowelle) was hier einer Lenkbewegung nach rechts entspricht. Eine Impulsbreite von 1ms entspricht damit einer maximalen Lenkbewegung nach links.

In Abbildung 1.1 ist das Ansteuersignal für den Servo dargestellt.

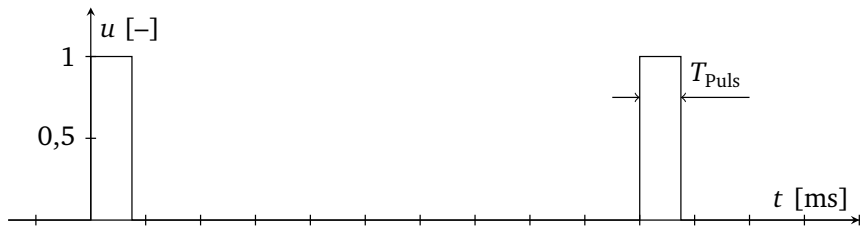
[picture p2: figure]
TPuls

−2 | 2 | 4 | 6 | 8 10 12 14 16 18 20 22 24 26 28

Abbildung 1.1.: Ansteuerung Servo

Das ucboard übernimmt die Ansteuerung des Servos. Dabei wird von außen ein Sollwert zwischen −1 000 und 1 000 vorgeben. Dieser Bereich wird auf eine Impulsbreite von 1 bis 2ms umgerechnet.

Die Auflösung der gestellten Impulsbreite beträgt dabei 1µs. (Damit ist die effektive Auflösung der Stellgröße 2.)

Es ist Folgendes zu beachten:

- Die Servos können aufgrund der Lenkmechanik nicht ihren vollen Stellbereich ausnutzen. Dies hört man, wenn ein Sollwert von 1 000 oder −1 000 vorgegeben wird. Es sollte auf Dauer vermieden werden, Servowinkel zu steuern, die nicht erreichbar sind.
- Lenken im Stillstand ist wie bei einem normalen Auto schwerer als in der Fahrt. Es kann je nach Achslast sein, dass das Servo einen gewünschten Lenkwinkel im Stillstand nicht erreicht.
- Die Lenkung besitzt ein gewisses Spiel. (Mit der IMU kann aber die Gierrate bestimmt werden, und damit kann bei bekannter Fahrgeschwindigkeit wiederum auf den Lenkwinkel geschlossen werden. Somit könnte der Lenkwinkel unterlagert geregelt werden.)

1.2.2 Fahrmotor (Fahrtenregler)

Die Fahrzeuge verfügen über Gleichstrommotoren, die über einen Tamiya Fahrtenregler angesteuert werden. Dabei ist bei den Chassis 1 bis 5 ein Tamiya TEU-101BK und bei den Chassis 6 und 7 ein Tamiya TEU-104BK verbaut. (Im Wesentlichen unterscheiden diese sich dadurch, dass bei den TEU-104BK ein Batterieschutz implementiert ist, der jedoch hier deaktiviert ist.)

Die Fahrtenregler werden wie die Lenkung durch ein „Servo-PWM-Signal“ angesteuert. D. h. eine Pulsbreite von 1,5ms entspricht „aus“, kürzere Pulsbreiten einer Vorwärtsfahrt und negative Impulsbreiten einer Rückwärtsfahrt bzw. Bremsen.

Die „Endanschläge“ (sowie die Neutralstellung) sind dabei kalibrierbar. Hier ist es so kalibiriert, dass die Impulsbreiten 1ms und 2ms die Grenzwerte und 1,5ms die Neutralstellung darstellen.

Da der Fahrtenregler intern gewisse Toleranzzonen berücksichtigt sowie in der Rückwärtsfahrt nur die halbe Stellgröße verwendet, ergibt sich die in Abbildung 1.2 gezeigte Kennlinie, wobei ∆tPuls die Abweichung der Pulsbreite von 1,5ms ist,

TPuls = 1,5ms + ∆TPuls .

−500 −250 | 250 | 500

−100

−50

50

100

∆TPuls [µs]

u [%]

Abbildung 1.2.: Kennlinie Fahrtenregler

Aufgrund des eigentlichen Einsatzzweckes der Fahrtenregler weisen diese folgendes Verhalten auf:

- Negative ∆TPuls, d. h. kleinere Pulsbreiten als die Neutralstellung (außerhalb der Toleranzzone), führen immer zur Vorwärtsfahrt.
- Wenn von aus einer Vorwärtsbewegung zu positiven ∆TPuls gewechselt wird, dann erfolgt eine Bremsung. Diese wird aber nicht über den Stillstand hinaus ausgeführt, d. h. der Fahrtenregler stellt sicher, dass keine Rückwärtsbewegung eintritt.

- Um ausgehend von einer Vorwärtsfahrt Rückwärts zu fahren, muss der Fahrtenregler einmal mit positivem ∆TPuls angesteuert werden (Bremsen), dann muss der Fahrtenregler mit einer Pulsbreite von 1,5ms angesteuert werden. Damit ist die Rückwärtsfahrt „freigeschaltet“. Wenn jetzt wieder ein positives ∆TPuls aufgebracht wird, dann erfolgt eine Rückwärtsfahrt. (Die Einzelschritte dieser Sequenz sind mindestens für 100ms zu halten. Damit hat sich bisher immer eine sichere Umschaltung ergeben.)

Das ucboard bietet zur Ansteuerung zwei Möglichkeiten. Zum einen kann der Fahrtenregler „direkt“ betrieben werden, d. h. man dann den Wert für ∆TPuls in Mikrosekunden direkt vorgeben. Die zweite Möglichkeit ist die der „gemanagten“ Ansteuerung. Hierbei wird dem ucboard mitgeteilt, welche Fahrtrichtung gewählt werden soll und welche Stellgröße dabei verwendet werden soll. Dabei meint ein positiver Wert immer die gewählte Bewegungsrichtung, bei Vorwärtsfahrt bedeutet ein negativer Wert eine Bremsung. Dabei bildet bei Vorwärtsfahrt der Wertebereich von 1 bis 1 000 den Stellgrößenbereich von 0 bis 100 % ab, bei Rückwärtsfahrt wird der Wertebereich von 1 bis 500 auf 0 bis −50% abgebildet. Ein Wert von 0 bedeutet Neutralstellung. Es ergeben sich damit die Kennlinien aus Abbildung 1.3.

−1 000 −500 | 500 | 1 000

−100

−50

50

100

u

∗
[–]

u [%]

(a) Vorwärts/Bremsen
−1 000 −500 | 500 | 1 000

−100

−50

50

100

u

∗
[–]

u [%]

(b) Rückwärts

Abbildung 1.3.: Kennlinien zur „gemanagten“ Ansteuerung über ucboard

Die für die Umschaltung von Vorwärts- auf Rückwärtsfahrt notwendige Bestimmung des Ist-Zustandes des Fahrtenreglers erfolgt dabei über einen Zustandsautomaten, der die Zustandswechsel des Fahrtenreglers nachbildet. Für den normalen Betrieb sollte dies sicher funktionieren. Fehler können nur dann auftreten, wenn

- sehr schnell zwischen Vor- und Rückwärtsfahrt gewechselt wird (weniger als 200ms zwischen aufeinanderfolgenden Wechsel) oder
- im Direktmodus Werte gestellt werden, die an den Rändern des Toleranzbereichs für die Neutralstellung liegen.

Erfolgt eine Vorwärtsfahrt (länger als 100ms) stimmen die Zustände wieder überein.

Die Fahrtenregler sind hier so angeschlossen, dass keine der 5 V-Spannungsversorgungsleitungen angeschlossen ist, sondern die Spannung direkt aus dem Fahrakku nimmt. Die Verbindung zum Fahrakku kann über das ucboard und den drvbatswitch geschaltet werden.

Die notwendige Massenverbindung als Bezug für das PWM-Signal wird über die Verbindung des ucboards mit dem drvbatswitch hergestellt. Dieses muss daher immer angeschlossen sein. (Ansonsten muss (nur!) die Masseleitung des nicht angeschlossenen Spannungsversorgungskabel des Fahrtenreglers an einen Massepin des ucboards angeschlossen werden.)

Problemlösung

- Schalter des Fahrtenreglers am Chassis auf „ON“?

1.3 Sensorik

1.3.1 Ultraschall

Es sind drei Ultraschallsensoren des Typs SRF08 verbaut, jeweils einer nach vorne, nach links und nach rechts.

Es wird die Zeit Techo vom Aussenden des Ultraschallimpulses bis zum Empfang des ersten Echos gemessen.¹

Der gemessene Abstand d entspricht der halben Signallaufstrecke c· Techo, wobei für die Schallgeschwindigkeit c = 343,2m/s angenommmen wird. Es ergibt sich damit

d =

1
2
- c · Techo = 171,6 m
s
- Techo .

Der Sensor gibt die Zeiten Techo in Mikrosekunden zurück, wobei die Auflösung 4µs ist. Damit ergibt sich eine Distanzauflösung von ca. 0,7mm. Die Messwerte werden vom ucboard in 0,1mm zurückgegeben.

Optionen: Messbereich und Verstärkung

Siehe Datenblatt des Sensors.

1.3.2 Hall-Sensor

Mit dem Hall-Sensor (Typ HAL 503) kann die Drehzahl des hinteren linken Rades gemessen werden. Dazu sind auf der Felge des Rades über den Umfang acht Magnete verteilt, die von der Polarität her immer wechselweise angeordnet sind.

Der genannte Sensor besitzt zwei stabile Zustände. Wird ein positiver magnetischer Pol in die Nähe gebracht, so wechselt er in den Zustand 1, bei einem negativen magnetischen Pol in den Zustand 0. Liegt kein Feld vor, dann wird der alte Zustand gehalten.

Somit kann durch Messen der Zeit zwischen zwei Zustandswechseln die Zeitdauer für eine achtel Umdrehung bestimmt werden.

Auf dem ucboard wird die Zeit zwischen den Impulsen auf eine Mikrosekunde genau bestimmt. Die Ausgabe der Messwerte erfolgt dann in 0,1ms. Daneben wird auch die Summe dieser Zeiten über acht Zustandswechsel, also einer Radumdrehung, bestimmt und in einer Genauigkeit von 1ms ausgegeben. Zuletzt erfolgt auch die Ausgabe der Anzahl an gezählten Zustandswechseln in Modulo 256, wenn extern selber mitgezählt werden soll. (Letzteres erlaubt auch die Überprüfung, ob ggf. Messdaten verloren gegangen sind.)

Im Gegensatz zu einem „klassischen“ Encoder kann die Drehrichtung nicht festgestellt werden!

- Der Abstand zwischen Rad und Aufbau darf nicht zu groß sein. Ist das Fahrzeug beispielsweise aufgebockt, so werden in der Regel keine Impulse mehr gezählt.²
1 | Genau genommen werden auch noch möglicherweise auftretende weitere Echos gemessen. Die dazugehörigen Zeiten
| stellt der Sensor in weiteren Registern zur Verfügung. Aktuell werden diese jedoch nicht ausgelesen. Möglicherweise
| könnte man mit einer Auswertung dieser Daten Fehlmessungen reduzieren.
2 | Vom Hersteller gibt es noch einen Hall-Sensor aus der gleichen Baureihe (HAL 502), der jedoch etwas empfindlicher (die
| notwendige Flussdichte beträgt ca. ein Drittel im Vergleich zum HAL 503) ist. Sollten häufig Probleme mit übersprunge-
| nen Impulsen auftreten, wäre dies eine mögliche Lösung.

1.3.3 IMU

Auf der hinteren rechten Ecke des ucboards befindet sich ein Beschleunigungs- und Drehratensensor (IMU – Inertial Measurement Unit) des Typs MPU-9250A.

Die x-Achse zeigt nach vorne, die y-Achse nach links und die z-Achse nach oben.

Der Sensor gibt die Messwerte als int16_t-Werte aus. Die Umrechnung eines Sensorwertes val in eine physikalische Einheit hängt von dem gewählten Messbereich ab. Für Beschleunigungswerte gilt

## a(val) =

val
16 384 g wenn Messbereich ± 2 g

val
8 192 g wenn Messbereich ± 4 g

val
4 096 g wenn Messbereich ± 8 g

val
2 048 g wenn Messbereich ± 16 g

(1.1)

und für Drehratenwerte gilt

## ω(val) =

val
131

◦

/s wenn Messbereich ± 250 ◦ /s

val
65,5

◦

/s wenn Messbereich ± 500 ◦ /s

val
32,8

◦

/s wenn Messbereich ± 1000 ◦ /s

val
16,4

◦

/s wenn Messbereich ± 2000 ◦ /s .

(1.2)

Standardmäßig sind die Messbereiche ±4 g und ±500 ◦ /s eingestellt. Diese können jedoch über entsprechende Befehle geändert werden.

Filterung

Die IMU verfügt über digitale Filter, die vor der sensorinternen Unterabtastung angewendet werden. (Der genaue Aufbau der Filter ist nicht dokumentiert. Die Angabe über Bandbreite und Verzögerung („delay“) lassen aber darauf schließen, dass es sich im Wesentlichen um eine Mittelwertbildung handelt.) Die möglichen Einstellungen, die über die ucboard-Befehle vorgenommen werden können, sind in Tabelle 1.2 aufgeführt. Diese Werte sind den Einträgen in der „Register Map“-Dokumentation des MPU-9250 entnommen.

Hinweis: Es ist zu beachten, dass die Abtastung (das Abfragen des Sensorwerte) seitens des ucboard unabhängig von der in Tabelle 1.2 bzw. im Sensordatenblatt genannten Abtastszeit immer mit 1 kHz erfolgt! Auch deshalb sollten die in Tabelle 1.2 grau geschriebenen Einstellungen nur zu Informationszwecken verwendet und nicht für den Normalbetrieb vorgesehen werden.

Die Standardeinstellung der Filter ist jeweils 0.

1.3.4 Magnetometer

Das Magnetometer vom Typ AK8963C ist im Gehäuse der IMU integriert. (Prinzipiell empfiehlt es sich, direkt das Datenblatt des AK8963 zu verwenden, und nicht in die entsprechenden Passagen des Datenblattes der IMU zu schauen.)

Die Achsenanordnung des Magnetometers unterscheidet sich von der der IMU bzw. damit auch der Achsenanordnung des Fahrzeugs. So zeigt die x-Achse zeigt nach links, die y-Achse nach vorne und die z-Achse nach unten. Alle ausgegebenen Werte werden jedoch in Fahrzeug- oder IMU-Koordinaten angegeben!

Es liegt ca. alle 10ms neue Messwerte vor. (Ungefähr, da die Taktrate des Mikrocontrollers und die des Sensors leicht abweichen können.)

Tabelle 1.2.: Filtereinstellungen IMU

(a) Gyroskop
GFILT | Bandbreite [Hz] Verzögerung [ms] | Interne Sensor-
abtastzeit [kHz]
-2 | 8 800 | 0,064 | 32
-1 | 3 600 | 0,11 | 32
0 | 250 | 0,97 | 8
1 | 184 | 2,9 | 1
2 | 92 | 3,9 | 1
3 | 41 | 5,9 | 1
4 | 20 | 9,9 | 1
5 | 10 | 17,85 | 1
6 | 5 | 33,38 | 1
7 | 3 600 | 0,17 | 8
(b) Beschleunigungssensor
AFILT | Bandbreite [Hz] | Verzögerung [ms] | Interne Sensor-
| | | abtastzeit [kHz]
-1 | 1 046 | 0,503 | 4
0 | 218,1 | 1,88 | 1
1 | 218,1 | 1,88 | 1
2 | 99 | 2,88 | 1
3 | 44,8 | 4,88 | 1
4 | 21,2 | 8,87 | 1
5 | 10,2 | 16,83 | 1
6 | 5,05 | 32,48 | 1
7 | 420 | 1,38 | 1

Die Einstellungen 0 und 1 sind in der Dokumentation tatsächlich identisch angegeben. Das könnte man mal überprüfen.

Korrektur der Sensorempfindlichkeit

Im Magnetometer ist intern für jede Achse ein Korrekturwert für die Sensitivität gespeichert (ASAX, ASAY und ASAZ). Dieser wird beim Starten ausgelesen und zur Korrektur der Messwerte verwendet. Diese Korrektur kann auch abgeschaltet werden (!MAG OPT ~USEASA=0).

Der korrigierte Wert H

0
{x,y,z}

ergibt sich aus dem Sensorwert H{x,y,z} und dem jeweiligen Korrekturfaktor ASA{X,Y,Z} über

H

0
{x,y,z} = H{x,y,z}

·

(ASA{X,Y,Z} − 128)· 0,5
128

+ 1

Kalibrierung des eingebauten Sensors

Eine weitere Kalibrierung des Magnetometers ist für die Zukunft vorgesehen. Aktuell muss dies aber, wenn gewünscht bzw. notwendig, selber auf dem PC realisiert werden.

Berechnung des Kurswinkels

Unter der Annahme, dass das Fahrzeug eben steht, kann aus dem Messwert der magnetischen Feldstärke in x- und y-Richtung der im(!) Uhrzeigersinn gezählte Kurswinkel ψh über

ψh = atan2(MY, MX)

in Radiant bestimmt werden. Die Funktion atan2 gibt einen Wert zwischen −π und π zurück. Einen typischen „Kompasswert“ in Grad erhält man daher nach dem Pseudocode

heading = atan2(MY, MX) * 180 / pi

if heading < 0
heading = 360 + heading
end

1.4 Taster und LEDs

Auf dem Board sind drei Taster (A, B und C) und zwei LEDs (A und B) vorhanden, die über die serielle Schnittstelle abgefragt bzw. gesetzt werden können. Für die LEDs SYS, DRVBAT und 12V ON ist keine externe Steuerung vorgesehen.

Abfrage Taster

Die Abfrage der Tasterzustände erfolgt über die DAQ-Kanäle PBA, PBB und PBC. Jeder dieser Kanäle gibt einen Zählerwert der Tasterbetätigungen zurück. Dieser Zähler wird für jedes Herunterdrücken und jedes Loslassen des Tasters inkrementiert. Ein betätigter Taster ist dabei durch eine gerade, und ein unbetätigter Taster durch eine ungerade Zahl repräsentiert. Auf diese Weise lassen sich auch sehr kurze Betätigungen erfassen, ohne dass die Abtastzeit des Kanals sehr klein eingestellt werden muss. Die Zähler sind Modulo 256.

LEDs

Die LEDs können über einen entsprechenden Befehl ein- und ausgeschaltet werden. Auch können Blinksequenzen vorgegeben werden. Siehe dazu die Befehlsbeschreibung des Befehls LED.

# 2 Kommunikation

2.1 Prinzip

Die Kommunikation mit dem ucboard ist textbasiert, so dass eine Bedienung über ein einfaches Terminalprogramm möglich ist. Dies ermöglicht ein einfaches Testen und Debuggen. Um dennoch ein einfaches Parsen der Nachrichten zu ermöglichen, besitzen diese ein definiertes Format.

In der Regel sind alle Nachrichten auch einfach lesbar. Um bezüglich der Messdatenerfassung etwas platzeffizienter zu sein, können diese jedoch optional als hex- oder base64-codierte Binärdaten versendet werden.

Ebenso wird in der Regel auf Prüfsummen verzichtet. Lediglich bei Messdaten, die als Binärdaten verschickt werden, kann optional eine CRC16-Prüfsumme angehängt werden. (Bei manchen Befehlen zum ucboard besteht die Möglichkeit, die wesentliche Zahl doppelt zu senden.)

Messdaten und Textnachrichten können vom ucboard ohne Aufforderung versendet werden. Ansonsten reagiert das ucboard auf Befehle, die an dieses geschickt werden. Dabei wird jeder Befehl durch eine Antwort quitiert.

- Die Nachrichten zum ucboard sollen sich möglichst einfach Parsen lassen. Die Nachrichten bestehen aus einem oder mehreren, durch Leerzeichen getrennte Wörter. Der Typ eines Wortes ergibt sich aus dem ersten Zeichen:

– A - Z und _: String

– ~: Optionsname

– 0 - 9 und -: Zahl

- Besteht eine Nachricht aus mehreren Wörtern, so spielt die Anzahl der Leerzeichen zwischen den Wörtern keine Rolle. (Mindestens eines!)

Prinzipiell wird nicht zwischen Groß- und Kleinschreibung unterschieden.

Eine Nachricht beginnt mit einem Startzeichen und endet mit einem Endezeichen. Das Startzeichen kann variieren. Bei Nachrichten zum ucboard ist dieses ! oder ?. Nachrichten vom ucboard beginnen mit zwei Startzeichen. Das erste Zeichen ist immer \02 (STX), danach folgt :, ’ oder #. Nach den Startzeichen kann, muss aber kein Leerzeichen folgen. Alle alphanumerischen Startzeichen (also nicht \02) dürfen auch innerhalb der Nachrichten verwendet werden. Dort haben sie keine besondere Bedeutung.

Das Endezeichen ist \n (newline) bei Nachrichten zum ucboard und \03 (ETX) bei Nachrichten vom ucboard.

Die Motivation hinter der unterschiedlichen Behandlung von Nachrichten zum und Nachrichten vom ucboard ist die, dass damit bei Nachrichten zum ucboard zu Debug-Zwecken ein einfaches Terminalprogramm verwendet werden kann, bei Nachrichten vom ucboard jedoch auch mehrzeiliger Text sinnvoll dargestellt werden kann und ein einfaches Identifizieren des Nachrichtenbeginns möglich ist.

Einzelne Zeilenumbrüche außerhalb von Nachrichten sind zu ignorieren. (Diese werden optional nach ETX vom ucboard verwendet, um die Darstellung im Terminalprogramm zu verbessern.)

Zu ucboard

- Befehle beginnen mit !
- Abfragen beginnen mit ?
- Antworten auf Fragen des ucboard (im interaktiven Modus) besitzen keinen speziellen Beginn. (Sie dürfen aber auch mit ! oder ? beginnen.
- Das Ende einer Nachricht wird ausschließlich durch \n (newline) markiert
- Optionen beginnen mit ~. Wenn der Option ein Wert zugeordnet wird, dann wird dieser nach einem = angeschlossen. Dabei dürfen um das Gleichheitszeichen herum keine Leerzeichen stehen!
- Die Reihenfolge der Argumente spielt eine Rolle. Die Position der Optionen spielt keine Rolle. (Bei Verarbeiten im ucboard wird zunächst eine Liste der Argumente und eine Liste der Optionen erstellt. Die Information, ob eine Option am Anfang, zwischen zwei Argumenten oder am Ende stand geht dabei verloren.)

Von ucboard

- Nachrichten beginnen immer mit \02 (STX).
- Direkte Antworten beginnen (nach STX) mit :
- Auch jeder Schreibbefehl sollte eine kurze Antwort zur Quittierung senden, z. B. :ok\n. Es wäre empfehlenswert, den gesetzten Wert zu wiederholen
- Fehler bei der Abarbeitung von Befehlen beginnen mit :ERR(code), wobei code eine positive Ganzzahl als Fehlercode ist. Optional kann nach einem weiteren Doppelpunkt eine Beschreibung des
Fehlers folgen: :ERR(code):Beschreibung
- Textausgaben (Display-Funktion) beginnen (nach STX) mit ’
- Fehlermeldungen sind Textausgaben. Diese beginnen mit ’ERR(code), wobei code eine positive Ganzzahl als Fehlercode ist. Optional kann nach einem weiteren Doppelpunkt eine Beschreibung
des Fehlers folgen: ’ERR(code):Beschreibung
- Ohne Aufforderung versendete Messdaten beginnen (nach STX) mit #.
- Wenn eine Nutzerinteraktion notwendig ist, dann sollte das letzte Zeichen vor dem Nachrichtendezeichen ein ? oder : sein.
- Alle Nachrichten vom ucboard haben ETX (0x03) als Endzeichen. (Dadurch ist es möglich, eine mehrzeilige Ausgabe auf dem Terminalprogramm zu erzeugen.)
– Über eine – aktuell noch fest eingestellte Option – wird nach jedem ETX automatisch ein Zeilenumbruch geschickt. Dies dient der besseren Lesbarkeit. Es wäre jedoch besser, ein Terminalprogramm zu verwenden (bzw. zu schreiben), welches ETX durch einen Zeilenumbruch ersetzt. Damit wäre sowohl der Text besser lesbar als auch der Sparsamkeit Rechnung getragen.

2.2 Hardware

Das ucboard verfügt über zwei Schnittstellen für die Kommunikation mit dem PC. Zum einen kann über einen USB-Anschluss eine serielle Kommunikation aufgebaut werden und zum anderen kann eine RS232-Schnittstelle verwendet werden. Die RS232-Schnittstelle wird dabei nicht als Standard-D-SUB-

Tabelle 2.1.: Einstellungen serielle Schnittstellen
| USB | RS232
Baudrate | 921 600 115 200
Datenbits | 8 | 8
Stopbits | 1 | 1
Parity | keine | keine
Hardware-Flowcontrol | Nein | Nein
ToDo: Testen, welche Baudrate jeweils maximal möglich ist! Man könnte dies auch über einen Befehl einstellbar
machen, und ein Rücksetzen darüber erreichen, dass beim Starten des ucboards z. B. der Taster A betätigt wird. Aber das erscheint mir für diesen Zweck unnötig.

Stecker (9-polig) angeboten, sondern als Wannensteckeranschluss. Dieser ist so belegt, dass eine direkte Verbindung zu den Anschlüssen des Onboard-PC über ein Flachbandkabel erfolgen kann.

Der dritte, „reine“ UART-Anschluss ist für den Anschluss möglicher Erweiterungen und nicht die Kommunikation mit dem PC vorgesehen.¹

Die Parameter der Schnittstellen sind in Tabelle 2.1 zusammengefasst.

2.3 Befehle

2.3.1 Übersicht

Tabelle 2.2.: Übersicht über Hauptbefehle ucboard

RESET | Neustart ucboard
VER | Abfrage Softwareversion
ID | Abfragen der Fahrzeug-ID
SID | Setzen und Abfragen der Session-ID
TICS | Abfrage ucboard-Zeit (Millisekunden nach (Neu)start)
STEER | Setzen und Abfragen des (Soll-)Lenkwinkels
DRV | Setzen und Abfragen der Fahrgeschwindigkeit
DAQ | Datenerfassung
VOUT | Ein- und Ausschalten 12 V-Ausgang (Kinect)
IMU | Zum Parametrieren der IMU
MAG | Zum Parametrieren des Magnetometers
US | Zum Parametrieren der US-Sensoren
EEPROM | Zum Auslesen des EEPROM-Inhalts
LED | Ansteuerung der LEDs A und B auf dem Board

Wichtig: Momentan werden numerische Eingaben noch nicht an allen Stellen daraufhin überprüft, ob es tatsächlich eine (Ganz)Zahl ist. Dies bedeutet, dass z. B. Eingaben wie 1000., 1000.0 oder auch +1000 für Tausend eine unerwartete Zahl ergibt.

1 Man könnte auch noch darüber nachdenken, die dritte UART auch für die Kommunikation mit einem PC zu verwenden, da an dieser einfach ein Bluetooth-Adapter angeschlossen werden könnte. Damit wäre es möglich, auch ohne den Onboard-PC das Fahrzeug ferngesteuert zu betreiben.

2.3.2 Beschreibung

RESET

Führt einen Neustart des ucboards durch.

!RESET NOW

VER

Fragt Versionsstring der ucboard-Software ab.

?VER
:0.1.x

ID

Zur Abfrage der Fahrzeug-ID, also der Nummer, die über die Dipschalter auf der Platine eingestellt wird.

?ID
:4

SID

Zum Abfragen und Setzen der Session-ID. Dies ist einfach eine Zahl, die nach einem Neustart des ucboards auf 0 gesetzt wird, und der beliebige uint32-Werte gegeben werden können.

?SID
:0

!SID 25363
:25363

?SID
:25363

STEER

Zum Setzen und Abfragen des Soll-Lenkwinkels (Servo-Vorgabe). Der Wert muss eine Ganzzahl zwischen −1 000 und 1 000 sein.

Setzen:

!STEER -200
:-200

Optionale Wiederholung des Arguments, um Fehlübertragungen zu detektieren:

!STEER -200 -200
:-200

!STEER -200 -201
:ERR(269): Message corrupted! (The two values have to be equal!)

Abfragen:

?STEER
:-200

DRV

Zum Setzen und Abfragen der Fahrgeschwindigkeit. (Bzw. Motorspannung.)

Es gibt zwei Modi: Die „gemanagte“ und die „direkte“ Ansteuerung. Siehe dazu Abschnitt 1.2.2.

Gemanagte Ansteuerung

Bei der gemanagten Ansteuerung erfolgt die Umschaltung von Vorwärts- und Rückwärtsfahrt automatisch. Zudem wird der gesetzte Wert in den Arbeitsbereich umgerechnet.

Vorwärtsfahrt:

!DRV F 300
:F 300

Optionale Wiederholung des Arguments, um Fehlübertragungen zu detektieren:

!DRV F 300 300
:F 300

!drv f 300 301
:ERR(269): Message corrupted! (The two values have to be equal!)

Es sind Werte von -500 bis 1000 zulässig. Dabei entsprechen negative Werte Bremsen (aber nicht einer Rückwärtsfahrt!).

Die effektive Auflösung ist geringer als der Stellbereich von 1000 es annehmen lässt. Tatsächlich können etwas weniger als 450 unterscheidbare Impulsbreiten, d. h. Sollwerte, vorgegeben werden.

Bremsen

!DRV F -500
:F -500

Gebremst wird vom Fahrtenregler automatisch nur bis zum Stillstand. Es erfolgt keine Rückwärtsfahrt.

Rückwärtsfahrt

!DRV B 300
:B 300

Es sind Werte von 0 bis 500 zulässig. (Der Stellbereich des Fahrtenreglers ist rückwärts nur halb so groß wie vorwärts.)

Ausschalten des Fahrtenreglers:

!DRV OFF
:OFF

Der Unterschied zwischen den Werten 0 und OFF liegt darin, dass bei OFF der Fahrtenregler vom Fahrakku getrennt wird, also tatsächlich ausgeschaltet ist. Der Fahrtenregler wird bei Übermittlung des nächsten Sollwertes ungleich OFF automatisch wieder eingeschaltet, jedoch dauert dies einen Moment. (Das Einschalten wird auch mit einem Piepston des Fahrtenreglers begleitet.)

Abfragen:

?DRV
:F 300

Abfragen der tatsächlichen Impulsbreite (vergleiche „Direkte Ansteuerung“):

?DRV D
:D -186

Direkte Ansteuerung

Bei der direkten Ansteuerung wird direkt die Impulsbreite vorgegeben, die an den Fahrtenregler übertragen wird. Dabei wird die Impulsbreite als die Abweichung in Mikrosekunden vom Neutralwert 1,5ms angegeben. D. h. ein Wert von −500 entspricht der minimalen Impulsbreite (d. h. Maximalwert vorwärts) von 1ms und ein Wert von 500 der maximalen Impulsbreite von 2ms.

!DRV D 200
:D 200

DMS

Die Totmannschaltung (DMS – Dead-man switch) soll insbesondere im Entwicklungsstatus der PC-Software und der Algorithmen verhindern, dass das Fahrzeug bei abgestürztem PC oder abgestürzten ROS-Nodes weiterfährt.

Dieser Parameter gibt die Zeit in Millisekunden an, innerhalb derer eine neue DRV-Nachricht erhalten sein muss. Wird diese Zeit ohne DRV-Nachricht überschritten, so wird der Motor gestoppt, d. h. der Sollwert auf 0 (aber nicht OFF) gesetzt. Bei der nächsten DRV-Nachricht wird der Motor dann wieder angesteuert.

!DRV ~DMS=1000
:~DMS=1000

Zum Abschalten der Sicherheitsschaltung dient der Wert 0.

DRV kann auch ohne Parameter aufgerufen werden. Dann dient er nur dazu, die Zeitzählung der Totmannschaltung neu zu starten.

!DRV
:ok

Abfrage der DMS-Abschaltzeit zusammen mit dem aktuellen DRV-Wert:

?DRV ~DMS
:OFF ~DMS=1000

DAQ

Das Datenerfassungsmodul (DAQ – Data Aquisition) dient als allgemeine Schnittstelle zur Übermittlung aller Sensorsignale. Dabei können Einzelabfragen vorgenommen werden (die angefragten Sensorwerte werden direkt als Antwort auf einen entsprechenden Befehl verschickt) als auch Gruppen von Sensorsignale eingerichtet werden, die dann automatisch vom ucboard an den PC geschickt werden.

Die Sensorsignale werden dabei hier als „Kanäle“ bezeichnet. Die aktuell definierten Kanäle sind in Tabelle 2.3 zusammengefasst.

Tabelle 2.3.: DAQ-Kanäle (Signale)
Kanal | Beschreibung | Einheit | Datentyp | Länge
AX | Beschleunigung x-Richtung | → (1.1) int16_t | 2
AY | Beschleunigung y-Richtung | → (1.1) int16_t | 2
AZ | Beschleunigung z-Richtung | → (1.1) int16_t | 2
GX | Drehrate um x-Achse | → (1.2) int16_t | 2
GY | Drehrate um y-Achse | → (1.2) int16_t | 2
GZ | Drehrate um z-Achse | → (1.2) int16_t | 2
MX | Magnetische Flussdichte in x-Achse | 0,15µT | int16_t | 2
MY | Magnetische Flussdichte in y-Achse | 0,15µT | int16_t | 2
MZ | Magnetische Flussdichte in z-Achse | 0,15µT | int16_t | 2
USF | Abstand vorne | 0,1mm | uint16_t | 2
USL | Abstand links | 0,1mm | uint16_t | 2
USR | Abstand rechts | 0,1mm | uint16_t | 2
VSBAT | Spannung Systemakku | mV | uint16_t | 2
VDBAT | Spannung Fahrakku | mV | uint16_t | 2
HALL_DT | Zeit zwischen den letzten beiden Impulsen des
| Hallsensors (eine Achtel Radumdrehung) | 0,1ms | uint16_t | 2
HALL_DT8 | Zeit zwischen den letzten acht Impulsen des
| Hallsensors (eine Radumdrehung) | 1ms | uint16_t | 2
HALL_CNT | Anzahl der Sensorimpulse, Modulo 256 (Ein
| Sensorwert von „1“ entspricht dabei immer eine
| ungeraden Zahl) | – | uint8_t | 1
PBA | Zähler Betätigung Taster A, Modulo 256 (Ge-
rade Werte: Unbetätigt, Ungerade Werte: Betätigt)
– | uint8_t | 1
PBB | wie PBA für Taster B | – | uint8_t | 1
PBC | wie PBA für Taster C | – | uint8_t | 1

Zur Übermittlung von Fehlerwerten sind bestimmte Zahlenwerte oder Textausgaben vorgesehen, die in Tabelle 2.4 aufgeführt sind. Dabei ist „keine Daten vorhanden“ ein Wert, der vom DAQ-Modul selber gesetzt werden, wenn keine gültigen Daten vorliegen. Die einzelnen Sensormodule geben im Fehlerfall entweder „Messfehler“ (bei einzelnen Messfehlern oder Messaussetzern) oder „Sensorfehler“ (ein größeres Sensorproblem, d. h. es ist in diesem Fall mit dem Ausfall aller (weiteren) Messwerten zu rechnen) zurück.

Tabelle 2.4.: Fehlerwerte

(a) Binärcodierung
Datentyp | uint32_t | int32_t | uint16_t | int16_t | uint8_t | int8_t
Keine Daten vorhanden | 0xFFFFFFFF | 0x7FFFFFFF | 0xFFFF | 0x7FFF | 0xFF | 0x7F
Messfehler | 0xFFFFFFFE | 0x7FFFFFFE | 0xFFFE | 0x7FFE | 0xFE | 0x7E
Sensorfehler | 0xFFFFFFFD | 0x7FFFFFFD | 0xFFFD | 0x7FFD | 0xFD | 0x7D
Wert zu groß oder zu klein 0xFFFFFFFC | 0x7FFFFFFC | 0xFFFC | 0x7FFC | 0xFC | 0x7C
Wert zu groß | 0xFFFFFFFC | 0x7FFFFFFC | 0xFFFC | 0x7FFC | 0xFC | 0x7C
Wert zu klein | 0xFFFFFFFB | 0x7FFFFFFB | 0xFFFB | 0x7FFB | 0xFB | 0x7B
(b) Textausgabe
Keine Daten vorhanden | [---]
Messfehler | [mfault]
Sensorfehler | [fault]
Wert zu groß oder zu klein | [range]
Wert zu groß | [over]
Wert zu klein | [under]

Allgemeines

Alle aktuell definierten Kanäle können mit ?DAQ CHS abgefragt werden:

?DAQ CHS
:14
AX | | acc. ahead | | opt-dep.! | | 1 | | I16
AY | | acc. left | | opt-dep.! | | 1 | | I16
[...]
HALL_DT8 | | delta time full rev. | | 1 ms | | undef | U16

Dabei beinhalten die Spalten die folgenden Informationen

- Name
- Beschreibung
- Einheit (opt-dep.! bedeutet, dass die Einheit von den jeweiligen Sensoreinstellungen abhängt.)
- Abtastzeit in Millisekunden (undef bedeutet, dass das entsprechende Sensormodul keine feste Abtastzeit der Messwerte garantiert.)
- Datentyp

Die Informationen zu einem speziellen Kanal können über

?DAQ CH name

abgefragt werden:

?DAQ CH USF
:USF | | ultrasonic front distance | | 0.1 mm | | undef | U16

Einzelabfrage von Werten

Zur Abfrage von Einzelwerten dient der Subbefehl GET:

?DAQ GET chname1 [chname2 [chname3 [...]]] [~AGE] [~TICS]

Diesem muss mindestens der Name eines Kanals übergeben werden. Es können aber auch mehrere Kanäle auf einmal abgefragt werden. Die Option ~AGE gibt zu jedem Wert das Alter in Tics (d. h. ms) zwischen dem Zeitpunkt der Datenerfassung und der Datenabfrage zurück. Die Option ~TICS gibt zu jedem Wert den Erfassungszeitpunkt in Tics zurück. Sind beide Optionen gewählt, dann wird immer AGE vor TICS zurückgegeben, unabhängig von der Reihenfolge der Optionen.

Beispiele:

- Einzelabfrage des Sensorwertes des vorderen Ultraschallsensors

?DAQ GET USF
:1860
- Ausgabe des Alters des Messwertes

?DAQ GET ~AGE USF
:1860 68
- Abfrage aller Ultraschallwerte, jeweils mit Alter

?DAQ GET ~AGE USL USF USR
:487 72 | 1860 75 | 4293 85
- Ausgabe der ucboard-Zeit des Messwerts

?DAQ GET ~TICS USF
:1860 3059246

Automatische Messgruppen

Es stehen zwanzig parametrierbare Messgruppen zur Verfügung, die zum automatischen Verschicken von Messdaten verwendet werden. In diesen können bis zu zehn verschiedene Kanäle (Sensorwerte) zusammengefasst werden. Neben den normalen Kanälen stehen noch die in Tabelle 2.5 aufgeführten „Sonderkanäle“ zur Verfügung, die Metadaten zu den Datensätzen enthalten. (Diese stehen bei der Einzelabfrage über ?DAQ GET chname nicht zur Verfügung.)

Es wird je Gruppe immer nur ein Messdatensatz gepuffert. Kann dieser nicht verschickt werden, bis die nächste Abtastung der Gruppe erfolgt ist, so wird dieser verworfen. Dabei werden alle Gruppen gleichberechtigt behandelt, d. h. es erfolgt keine Bevorzugung von Messgruppen mit kleiner Abtastzeit. Damit ist die Wahrscheinlichkeit gering, dass bei langsam abgetasteten Messgruppen Daten verlorengehen, auch wenn viel Bandbreite für Messgruppen mit kleiner Abtastzeit belegt wird.²

Eine Messgruppe wird über den Subbefehl GRP definiert.

!DAQ GRP grpnb chname1 [chname2 [chname3 [...]]] [~option1] [~option2] [...]

Die Gruppennummer grpnb muss eine Ganzzahl zwischen 0 und 19 sein.

2 An dieser Stelle muss noch angemerkt werden, dass das Management der zu versendenden Daten im Idle-Task des ucboards erfolgt. D. h. während der Datenerfassung im SysTick-Task werden keine neuen Daten zum Verschicken bereit gemacht, auch wenn der letzte Datensatz abgearbeitet ist. Damit ist der erreichbare Datendurchsatz kleiner als der sich theoretisch aus der Baudrate ergebenden Wert. Dies kann bzw. sollte in Zukunft noch geändert werden. Bisher benötigt der SysTick-Task weniger als 200µs. Damit würde im ungünstigsten Fall die Datenrate ein Fünftel „verlieren“.

Die Möglichkeiten der Gruppendefinition wird zunächst an Beispielen demonstriert. Danach werden die Optionen genauer beschrieben.

- Gruppe 1 enthält die Werte des Ultraschalls. Es wird gesendet, wenn alle Ultraschallwerte vorliegen, wobei maximal 10ms nach dem Erfassen des ersten Wertes gewartet wird. Die Daten werden base64-codiert und mit einer CRC16-Prüfsumme verschickt.

!DAQ GRP 1 ~ALL=10 ~ENC=B64 ~CRC _TIC USL USF USR
(Die Reihenfolge der Kanalnamen (_TIC, USL, USF, USR) spielt eine Rolle, da die Messwerte ohne Namen in dieser Reihenfolge ausgegeben werden. Die Reihenfolge der Optionen und ob diese am Anfang oder Ende oder auch zwischen den Kanalnamen stehen spielt keine Rolle.)
- Gruppe 2 enthält die Spannungen der beiden Akkus, wobei immer eine Nachricht verschickt wird, sobald eine neue Spannung gemessen ist.

!DAQ GRP 2 ~ANY VSBAT VDBAT
- Gruppe 3 enthält die Beschleunigungswerte in der Ebene und die Gierrate. Die Daten werden alle 10ms verschickt. Dabei werden alle innerhalb der 10ms erfassten Daten gemittelt.

!DAQ GRP 3 ~TS=10 ~AVG ~ENC=B64 ~CRC AX AY GZ
Optionen:
- Modus Abtastung

– ~ALL[=maxwait]: Sendet, wenn zu allen Gruppenkanäle neue Daten vorhanden sind. Wenn maxwait gegeben ist, dann wird nach dem ersten neuen Wert maximal diese Zeit in Millisekunden gewartet, bis die Daten verschickt werden.³

– ~ANY: Sendet, wenn zu einem der Gruppenkanäle ein neues Datum vorhanden ist.

– ~TS=Ts: Abtastzeit in Millisekunden. (Muss ein ganzes Vielfaches der Abtastzeiten aller Kanäle des Paketes sein.)

* ~AVG[=Ta]: Mittelung über Zeitraum Ta. (Nur im Abtastmodus TS verfügbar.) Wenn die Option AVG verwendet wird, dann müssen alle Gruppenkanäle die gleiche Abtastzeit besitzen. Ta darf dabei maximal Ts sein und muss ein ganzes Vielfaches der Abtastzeit der Gruppenkanäle sein. Wenn kein Ta angegeben ist, dann wird Ta = Ts gesetzt.
Diese Mittelung kann damit bezüglich der Sensorabtastzeit Ts,sig über die Übertragungsfunktion

Gavg(z) =

1
navg

·(z

navg−1 + z

navg−2 + ··· + 1)

z

navg−1

mit navg = Ta/Ts,sig ausgedrückt werden. Über ~TS=Ts wird dann eine Unterabtastung mit dem Faktor Ts/Ts,sig vorgenommen.

- ~SKIP=n: Überspringt n Werte. D. h. bei einem Wert von neun wird jeder zehnte Wert verwendet. Dieses Überspringen wird nach allen anderen Berechnungen und Abfragen durchgeführt. Diese Option dient primär zum Debuggen (um die Menge an ausgegebenem Text zu reduzieren), kann aber auch zur Unterabtastung für Kanäle ohne feste Abtastzeit verwendet werden. (Dabei ist dann aber keine Mittelung möglich.)
- ~ENC=B64|HEX|ASCII: Nachricht wird base64-codiert (ohne Padding), Hex-codiert oder Asciicodiert. ASCII meint hierbei „lesbaren Text“. Standardwert ist ASCII.
- ~CRC: CRC16-Prüfsumme (Nur wenn ENC = B64 oder HEX)
Berechnung mit:

3 Dies ist z. B. für die US-Sensoren gedacht, deren Daten meist an nacheinander liegenden Zeitschritten ankommen.

1 | // from Antonio Pires , http://stackoverflow.com/questions /10564491/function -to-→ ←calculate -a-crc16 -checksum
| // CRC -16-CCITT (polynom 0x1021)
6 | uint16_t crc16(uint8_t* data_p , uint16_t length) { uint8_t x; uint16_t crc = 0xFFFF;
11 | while (length --) { x = (crc >> 8) ^ (* data_p ++); x ^= (x >> 4); crc = (crc << 8) ^ (( uint16_t)(x << 12)) ^ (( uint16_t )(x <<5)) ^ (( uint16_t)→ ←x);
16 | }
| return crc; }
- ~AGE und ~TICS: Wie bei Einzelwertabfrage. Damit wird jedem Wert das Alter sowie der Erfassungszeitpunkt hinzugefügt. (Wenn beide Optionen gewählt sind, dann immer in der Reihenfolge „Age – Tics“.) Die Werte werden bei der Ascii-Codierung immer innerhalb der senkrechten Striche des Kanals geschrieben. Bei Binärcodierungen werden diese Werte jeweils als 32 bit-Werte jeweils hinter den betreffenden Messwert eingefügt. Diese Optionen dienen lediglich zum Debuggen. Im „Normalbetrieb“ sollten diese aufgrund des großen Platzbedarfs nicht verwendet werden!⁴

Tabelle 2.5.: „Sonderkanäle“ mit Metadaten
Signal | Beschreibung | Datentyp | Länge
_CNT | Anzahl der verschickten Datensätze der Gruppe | uint32_t | 4
_CNT16 | die niederwertigen 16 bits von _CNT | uint16_t | 2
_CNT8 | die niederwertigen 8 bits von _CNT | uint8_t | 1
_TICS | ucboard-Zeit (tics) der Erfassung des ersten Datums | ms uint32_t | 4
_TICS16 | die niederwertigen 16 bits von _TIC | ms uint16_t | 2
_TICS8 | die niederwertigen 8 bits von _TIC | ms uint8_t | 1
_DTICS | Delta der ucboard-Zeit zwischen ersten und letztem Datum ms uint32_t | 4
_DTICS16 | min{_DTICS, 65 535} | ms uint16_t | 2
_DTICS8 | min{_DTICS, 255} | ms uint8_t | 1
_DLY | Zeit zwischen Datensatzerstellung und Versenden, bei 255
| gesättigt | ms uint8_t | 1

Weitere Funktionen zu Messgruppen:

- Anzeige aller Gruppeninformationen

4 Das Alter AGE bezieht sich auf den Abtastzeitpunkt des Datensatzes, nicht auf den Zeitpunkt des Versendens. Der Wert ist damit nur bei der Abtastart ALL relevant, da dort die Daten einer Gruppe zu unterschiedlichen Zeitpunkten abgetastet sein können. Die Zeitdifferenz zwischen Abtastzeitpunkt und Versenden kann durch den Sonderkanal _DLY abgefragt werden. (Somit ist das tatsächliche Alter AGE + _DLY plus die Zeit zur Datenübermittlung und Verzögerungen innerhalb des Betriebssystem des PCs.)

?DAQ GRPS
:[...]
- Anzeigen Informationen zur Gruppe 1

?DAQ GRP 1
:[...]
- Löschen von Gruppe 1

!DAQ GRP 1 ~DELETE
:ok
- Deaktivieren von Gruppe 1

!DAQ GRP 1 ~DEACTIVATE
:ok
- Aktivieren von Gruppe 1

!DAQ GRP 1 ~ACTIVATE
:ok
(Standardmäßig ist eine Gruppe nach der (Neu-)Definition aktiviert. Dies kann unterbunden werden, indem die Option ~DEACTIVATE in die Definition mit aufgenommen wird.)
Starten und Anhalten der Erfassung und Übermittlung der Messdaten
- Starten der Datenerfassung

!DAQ START
:started
- Anhalten der Datenerfassung

!DAQ STOP
:stopped
- Abfrage Status der Datenerfassung

?DAQ
:stopped
Die Neudefinition einer Gruppe erfolgt durch einfaches Überschreiben der Gruppendefinition. Dabei ist zu beachten, dass aktive Gruppen nur dann überschrieben werden können, wenn die Datenerfassung angehalten ist (!DAQ STOP).

Binärdaten

Bei ENC = B64 und HEX werden die Daten als Binärdaten verschickt.

Die Kanalnummer und der folgende Doppelpunkt immer in ASCII-Codierung versendet. Darauf folgen ohne Leer- oder Trennzeichen die einzelnen Messdaten mit der jeweils für den Kanal gültigen Breite.

!daq grp 1 usl usf usr ~all=20
:ok
!daq grp 2 usl usf usr ~all=20 ~enc=hex :ok
!daq grp 3 usl usf usr ~all=20 ~enc=hex ~crc :ok
!daq grp 4 usl usf usr ~all=20 ~enc=b64 :ok

!daq grp 5 usl usf usr ~all=20 ~enc=b64 ~crc :ok
!daq start
:started
#1:806 | 4561 | 4075

#2:2603D111EB0F

#3:2603D111EB0F68CF

#4:JgPREesP

#5:JgPREesPaM8

Sonstiges

Die Definition einer Messgruppe, die nur aus Sonderkanälen besteht, ist möglich. Dies ist jedoch – wenn überhaupt – nur mit der Abtastart TS sinnvoll, da bei ANY und ALL nie ein Datensatz verschickt werden würde.

So kann mit

!daq grp 1 _cnt8 _dly ~Ts=10 ~enc=b64

ein „Taktgeber“ erzeugt werden, der alle 10ms einen Wert schickt. Über _CNT8 kann dabei festgestellt werden, ob Werte übersprungen wurden, und mit _DLY, ob der aktuelle Wert verzögert wurde.

VOUT

Einschalten der Kinect-Spannung

!VOUT ON
:ON

Abschalten der Kinect-Spannung

!VOUT OFF
:OFF

Abfragen Zustand

?VOUT
:OFF

US

Aktiveren und Deaktivieren der US-Sensoren

(Nach einem Neustart des ucboards sind die US-Sensoren aktiv.)

Aktivieren der US-Sensoren

!US ON
:ON

Deaktivieren der US-Sensoren

!US OFF
:OFF

Abfragen Zustand der US-Sensoren

?US
:OFF

Einstellungen US-Sensoren

Es können die beiden Parameter „Range“ und „Gain“ eingestellt werden. (Es wird immer für alle drei US-Sensoren der selbe Wert genommen.) Für die Bedeutung der Parameter und deren Zahlenwerte siehe das Datenblatt des Sensors!

Setzen der Einstellungen:

!US OPT ~RANGE=100 ~GAIN=10
:~RANGE=100 ~GAIN=10 [4343 mm, 25 ms]

(Es kann auch nur ~RANGE oder ~GAIN gesetzt werden.)

In eckigen Klammern wird die Entsprechung des Range-Parameters in Millimetern und Millisekunden ausgegeben. Die tatsächliche Abtastzeit wird ein paar Millisekunden über diesem Wert liegen, da ein gewisser Overhead vorhanden ist.

Abfragen der aktuellen Einstellungen:

?US OPT
:~RANGE=100 ~GAIN=10 [4343 mm, 25 ms]

Pingen der US-Sensoren

Mit

!US PING
:ok

wird ein Ping für jede der sechzehn möglichen I2C-Adressen des Ultraschallmoduls ausgeführt. Das Pingen funktioniert nur, wenn die US-Sensoren ausgeschaltet sind.

Das Ergebnis wird nicht direkt als Antwort auf den Befehl, sondern als Textausgabe über die Display-Funktion übertragen:

’ping:
224 = ok
226 = ok
228 = ok
230 = -
232 = -
[...]
254 = -

Änderung der I2C-Bus-Adresse

Das Programm geht von der in Tabelle 2.6 aufgeführten Zuordnung der Sensoren (anhand der I2C-Bus-Adresse) zu deren Position aus. Wird ein Sensor ausgetauscht, muss dessen Adresse überprüft (!US PING) und gegebenenfalls geändert werden.

Tabelle 2.6.: Zuordnung der I2C-Bus-Adressen zur Position der US-Sensoren Position Adresse

links | 224
vorne | 226
rechts | 228

Um die Adresse zu ändern, muss der betreffende Sensor nach dem Datenblatt alleine am Bus hängen. (Dies wird im Programm auch überprüft.) Die Adressänderung erfolgt mit

!US CHGADDR old new

Dabei ist old die aktuelle (alte) Adresse und new die neue Adresse, die gesetzt werden soll.

Beispiel:

!US CHGADDR 224 226
:ok

Die Erfolgsmeldung bzw. mögliche Fehlermeldungen werden nicht direkt als Antwort auf den Befehl gesendet, sondern als Textausgabe über die Display-Funktion übertragen.

IMU

Setzen der Einstellungen:

!IMU OPT ~ARANGE=8 ~AFILT=3 ~GRANGE=1000 ~GFILT=0
:~ARANGE=8 ~AFILT=3 ~GRANGE=1000 ~GFILT=0 [A: 45 Hz, G: 250 Hz]

(Es brauchen nicht alle Optionen gesetzt zu werden.)

ARANGE gibt den Messbereich des Beschleunigungssensors in g an und kann auf 2, 4, 8 oder 16 gesetzt werden. GRANGE gibt den Messbereich des Gyrometers in Grad pro Sekunde an und kann auf 250, 500, 1000 oder 2000 gesetzt werden. Die möglichen Werte für die Filter sind auf Seite 9 in Tabelle 1.3b (AFILT) bzw. Tabelle 1.3a (GFILT) aufgeführt.

Abfragen der aktuellen Einstellungen:

?IMU OPT
:~ARANGE=8 ~AFILT=3 ~GRANGE=1000 ~GFILT=0 [A: 45 Hz, G: 250 Hz]

MAG

Setzen der Einstellungen:

!MAG OPT ~USEASA=1
:~USEASA=1

USEASA gibt an, ob die im Magnetometer fest gespeicherten Korrekturwerte für die Sensitivität verwendet werden sollen. Dabei bedeutet der Wert 1, dass die Werte verwendet werden und der Wert 0, dass die Werte nicht verwendet werden. Der Wert nach einem Neustart ist 1.

Abfragen der aktuellen Einstellungen:

?MAG OPT
:~USEASA=1

Abfrage der Korrekturwerte:

?MAG ASA
:176 176 165

Diese Werte entsprechen der Reihenfolge nach den Korrekturwerten der x-, y- und z-Achse, gezählt in Fahrzeugkoordinaten. (Damit entsprechen diese Werte den Registern ASAY, ASAX und ASAZ des Magnetometers.)

Da es sich bei den Korrekturwerten um fest gespeicherte Werte im Magnetometer handelt, können diese nicht verändert werden. Eine Vorgabe von eigenen Kalibrierungswerten ist für die Zukunft vorgesehen. Momentan muss eine Kalibrierung des eingebauten Sensors, wenn gewünscht, aber noch auf dem PC erfolgen.

LED

Setzen der LEDs:

!LED id seq [id2 seq]

id ist A oder B und bezeichnet die LED. Der gewünschte Modus der gewählten LED wird mit seq angegeben. Dies kann entweder einfach ON, OFF oder TOG, oder eine Sequenz von Ein- und Ausschaltdauern sein:

[0] ton toff [ton2 toff2 [ton3 toff3 [...]]]

Die An- und Ausschaltzeiten sind dabei in 10ms gegeben. Diese Sequenz muss aus einer geraden Anzahl von positiven Ganzzahlen bestehen. Es sind maximal zehn Paare an Ein- und Ausschaltdauer möglich, also maximal zwanzig Zahlen.⁵ Die optionale führende 0 invertiert An- und Ausschalten.

Anschalten der LED A:

!LED A ON
:ok

Ausschalten der LED A und gleichzeitig Einschalten der LED B:

5 Es ist dabei zu beachten, dass in der aktuellen Implementierung ein Befehl maximal 22 Parameter/Optionen besitzen kann.

!LED A OFF B ON
:ok

Toggeln der LED A:

!LED TOG
:ok

(Wenn die LED A vorher im Sequenzmodus ist, wird diese ausgeschaltet.)

Blinken der LED A mit 0,5 Hz, 50 %/50 %:

!LED A 100 100
:ok

Verschiedene Befehle werden nicht synchronisiert. D. h. mit

!LED A 100 100
:ok

!LED B 100 100
:ok

blinken A und B jeweils mit 0,5 Hz, 50 %/50 %, jedoch aller Wahrscheinlichkeit nach versetzt.

Um ein synchrones Blinken zu erhalten, können die Sequenzen im gleichen Befehl gesetzt werden:

!LED A 100 100 B 100 100
:ok

Soll ein gegenphasiges Blinken erzeugt werden, kann die Sequenz der LED B invertiert werden:

!LED A 50 50 B 0 50 50
:ok

Werden mit einem Befehl für die gleiche LED mehrere Modi angegeben (z. B. !LED A ON A 10 90), so zählt der zuletzt angegebene Modus.

Ist die Nachricht fehlerhaft, wird diese komplett verworfen. D. h. bei !LED A ON B 30 wird auch nicht die LED A eingeschaltet, obwohl dieser Teil der Nachricht noch korrekt wäre, da der zu B gehörende Teil fehlerhaft ist.

Teil II.

# Entwickeln und Anpassen

# 3 Git-Repository

3.1 Ort

https://github.com/tud-pses/ucboard

3.2 Inhalt

datasheets\ | Datenblätter der Sensoren sowie Datenblätter der Bauteile der Schal-
| tungen
doc\ | Latex-Dateien um dieses Dokument zu erstellen
fw_releases\ | (firmware_releases) bin-Dateien der wesentlichen Firmwareversionen
fw_workspace\ | (firmware_workspace) Workspace der Entwicklungsumgebung, Source-
| code des auf dem Mikrocontroller laufenden Programms
kicad_drvbatswitch\ | KiCad-Dateien (Schaltplan und Layout) der kleinen Schaltplatine für
| den den Fahrakku
kicad_ucboard\ | KiCad-Dateien (Schaltplan und Layout) der ucboard-Platine
kicadlibs\ | KiCad-Bibliotheken mit Bauteilen für drvbatswitch und ucboard
matlab\ | Matlab-Klasse zur direkten Kommunikation mit ucboard, Skripte zur Be-
| trachtung von Sensorwerten
mfg\ | Fertigungsdaten (Gerber-Format) für Platinen
stm32cubemx\ | Projekt für STM32CubeMX (Programm zur Konfiguration des Mikrocon-
| tollers)
ucterm\ | Einfaches in C# geschriebenes Terminalprogramm für Entwicklung am
| ucboard

3.3 Firmware-Releases

Im Verzeichnis fw_releases\ befinden sich die Firmware-Versionen (Programme für den Mikrocontroller) zu bestimmten Versionständen. Die bin-Dateien sind dabei nach dem Schema

| pses_ucboard_verVERSIONSNUMMER_BUILDCONF.bin

benannt, so z. B.

| pses_ucboard_ver0.9.0_Debug.bin

Zu jeder Version, die in diesem Verzeichnis liegt, sollte im Git-Repository ein Tag der Form

| fwver_VERSIONSNUMMER

vorhanden sein. Zu dem Beispiel oben gehört also der Tag

| fwver_0.9.0

Während der Weiterentwicklung bis zu einem Stand, der eine neue Versionsnummer erhält, sollte der Versionsnummer in version.h ein „+“ angehängt werden, also z. B. 0.9.0+. (Idealerweise wird das + direkt nach dem Erzeugen der Release-Version angehängt, um zu vermeiden dies zu vergessen.)

Für Weiterentwicklungen innerhalb der Gruppen sollte dem Versionsstring noch der Gruppenname oder eine ähnliche Kennzeichnung hinzugefügt werden.
Tabelle 3.1 gibt eine Übersicht über die Firmware-Versionen.

Tabelle 3.1.: Übersicht über Firmware-Versionen

Version Datum | Kommentar
0.12.0 | 13.07.2018 Version nicht vollständig abwärtskompatibel!
– Alle Nachrichten vom ucboard beginnen mit STX (\02) – Alle DAQ-Daten-Nachrichten starten unabhängig vom Encoding mit #ch:
– Ansteuerung der LEDs (!LED)
– Abfrage Taster A, B und C über DAQ-Kanäle PBx
0.11.4 16.02.2018 – Ping-Funktion für Ultraschallsensoren (!US PING)
– Änderung der Bus-Adresse für Ultraschallsensoren
(!US CHGADDR)
0.11.3 14.02.2018 – Beseitigung von Bugs bei Peripherieansteuerung (i2cmgr) – Deaktivieren der UART3-Schnittstelle (RS232)
0.11.2 | 13.12.2017 – Beseitigung von Bugs bei Peripherieansteuerung (i2cmgr)
0.11.1 | 09.11.2017 – Beseitigung von Bugs bei Peripherieansteuerung
0.11.0 | 26.11.2016 – Magnetometer in Betrieb genommen
0.10.1 | 07.11.2016 – Standardeinstellungen geändert: US ist nach Neustart aus,
Kinect ist nach Neustart ein
0.10.0 03.11.2016 – Befehl IMU hinzugefügt (Parametrierung IMU)
– Interne Änderung im Kommunikationsstack 0.9.1 01.11.2016 – Befehl US hinzugefügt (Ein- und Ausschalten und Parametrierung US-Sensoren)
– Beseitigung von Bugs im Kommunikationsstack
0.9.0 25.10.2016 Grundfunktionalität weitgehend vorhanden. (Es fehlen noch die Befehle zum Parametrieren und Kalibrieren der Sensoren und der Treiber für das Magnetometer.)

Roadmap

Tabelle 3.2.: Roadmap Firmware Version Kommentar

0.13.0 | Verwenden der in IMU abgelegten Offsetwerte für Drehra-
| tensensor
x | – [intern] Aufteilen Kommunikationsstack in Befehlsbear-
| beitung und UART-Treiber
x | – [intern] Umstellen der UART-Kommunikation auf DMA
1.0.0 | – Befehlsbasierte (= textbasierte) benutzerdefinierte Initia-
| lisierung über EEPROM
1.1.0 | – Kalibrierungsroutinen
x | – [intern] Code-Review, Gleiche/Ähnliche Funktionen zu-
| sammenfassen, . . .

# 4 Flashen

4.1 Linux

4.1.1 Vorbereitung

STM stellt für den ST-Link/V2-Programmer keine Software für Linux zur Verfügung. Dieser Adapter kann aber dennoch zum Flashen über Linux benutzt werden, wenn das auf GitHub verfügbare Programm stlink verwendet wird. Dieses kann wie folgt installiert werden.¹

1. Für Installation benötigte Pakete installieren

sudo apt-get install libusb-1.0-0-dev git unzip libgtk-3-dev
2. stlink herunterladen (hier Version 1.2.0, ggf. neuere Version nehmen)

wget https://github.com/texane/stlink/archive/1.2.0.zip
3. Datei entpacken und in das Verzeichnis wechseln

# Unzip the file

unzip 1.2.0.zip
cd stlink-1.2.0
4. Programm kompilieren

mkdir build && cd build
cmake -DCMAKE_BUILD_TYPE=Debug .. make
5. stlink installieren

sudo make install
6. udev-Regeln so einstellen, dass st-flash ohne „sudo“ verwendet werden kann

cd ..
sudo cp *.rules /etc/udev/rules.d
sudo restart udev
7. Prorgamm sollte sich jetzt öffnen lassen

stlink-gui

4.1.2 Flashen

1. ST-Link/V2 an Platine anschließen. Fahrzeug einschalten.
2. Öffnen der grafischen Oberfläche von stlink

stlink-gui

1 Vorgehen nach Nicolas Acero.

3. Auf „Connect“-Icon klicken. Es sollten die Daten des Mikrocontrollers angezeigt werden.
4. Auf „Open File“-Icon klicken und bin-Datei auswählen.
- Im Repository unter fw_releases\ liegen die „offiziellen“ Versionen.
5. Auf „Program“-Icon klicken.
- Start-Adresse ist ist 0x08000000. (Sollte voreingestellt sein.)

4.2 Windows

4.2.1 Vorbereitung

„STM32 ST-Link Utility“ von der STM-Homepage herunterladen und installieren (beinhaltet auch die Treiber).

Hinweis: Die könnte schon problematisch sein, wenn man den ST-Link/V2 zum Debuggen verwendet will, da damit auch ein spezieller Treiber installiert wird, für gbd aber ein generischer Treiber benötigt wird. (Quelle: Forum, quergelesen. Müsste noch geklärt werden.)

4.2.2 Flashen

1. ST-Link/V2 an Platine anschließen. Fahrzeug einschalten.
2. „STM32 ST-Link/V2 Utility“ öffnen.
3. Auf „Connect“-Icon (drittes von links) klicken. Es sollten die Daten des Mikrocontrollers angezeigt werden.
4. Auf „Open File“-Icon (erstes von links) klicken und bin-Datei auswählen.
- Im Repository unter fw_releases\ liegen die „offiziellen“ Versionen.
5. Auf „Program Verify“-Icon (sechstes von links) klicken.
- Start-Adresse ist ist 0x08000000. (Sollte voreingestellt sein.)

# 5 Programmierung

5.1 Einrichtung Entwicklungsumgebung

System Workbench for STM32

Die verwendete Entwicklungsumgebung „System Workbench for STM32“ basiert auf Eclipse. Die Entwicklungsumgebung kann über www.openstm32.org geladen werden. Die Entwicklungsumgebung beinhaltet einen Compiler.

Projekt importieren

Wenn das git-Repostory lokal geclont wurde, muss das Projekt einmalig in die Entwicklungsumgebung importiert werden. Dazu wird wie folgt vorgegangen:

1. Starten von „System Workbench for STM32“
2. „File“ → „Switch Workspace“ → „Other. . . “: Verzeichnis fw_workspace\ des Repositories auswählen
3. „File“ → „Import“. . . :
- „General“ → „Existing Projects into Workspace“
- „Select root directory“: Verzeichnis fw_workspace\ des Repositories über „Browse. . . “ auswählen
- „Projects“: pses_ucboard auswählen
- „Options“: „Copy projects into workspace“ darf NICHT ausgewählt sein. (Die Daten sind ja schon da, wo sie hingehören.)
- „Finish“
4. STRG+B sollte Projekt erstellen
5. Falls im „Problems“-Reiter ein Fehler angezeigt wird, dass ein Symbol nicht aufgelöst werden kann:
- Rechte Maustaste auf Projekt (ersten Eintrag) im „Project Explorer“, → „Properties“
- „C/C++ General“ → „Indexer“
(Falls es den Punkt „C/C++ General“ nicht gibt, dann hat man vorher nicht auf das Projekt geklickt.)
- „Enable project specific settings“ auswählen
- „Index source files not included in the build“ abwählen

(Die Ursache liegt darin, dass die Headerdateien für viele Mikrocontrollervarianten vorhanden sind, die alle die gleichen Symbole definieren. Letztlich wird nur ein Header eingebunden, aber mit der genannten Option schaut sich Eclipse dennoch alles an und weiß dann nicht, welches Symbol das richtige ist.)

Einrichten des Programmieradapters ST-Link/V2

Hinweis: Es müsste möglich sein, den ST-Link/V2 auch zum Debuggen einzurichten. Dies wurde bisher jedoch noch nicht gemacht, sondern er wird lediglich zum Flashen verwendet.

Hinweis: Hier wird die Einrichtung unter Windows beschrieben.

1. „STM32 ST-Link Utility“ von der STM-Homepage herunterladen und installieren (beinhaltet auch die Treiber).
Hinweis: Dieser Schritt könnte schon problematisch sein, wenn man den ST-Link/V2 zum Debuggen verwendet will, da damit auch ein spezieller Treiber installiert wird, für gbd aber ein generischer Treiber benötigt wird. (Quelle: Forum, quergelesen. Müsste noch geklärt werden.)
2. Im Verzeichnis fw_workspace\pses_ucboard die Datei stlinkflash_template.bat in stlinkflash.bat kopieren. (Letztere sollte von Git ignoriert werden.)
3. In der Datei stlinkflash.bat die Pfade zum ST-Link-Utility anpassen.
4. In der Entwicklungsumgebung:
a) „Run“ → „External Tools“ → „External Tools Configurations. . . “
b) Links auf „Program“ klicken, dann oben auf das linke Icon zum Erstellen einer neuen Konfiguration
- „Name“: „STM flashen“
- „Location“: Über „Browse Workspace. . . “ die Datei stlinkflash.bat auswählen
- „Arguments“:

"${workspace_loc}\${project_name}\${config_name:${project_name}}\${project_name}.bin"
Die doppelten Anführungszeichen müssen miteingegeben werden!
c) „Apply“
d) „Close“
5. Beim ersten Klicken auf das „External-Tools“-Icon (Play-Symbol mit Werkzeugkoffer) kann dann die Konfiguration „STM flashen“ ausgewählt werden. Danach ist diese automatisch voreingestellt. (Die Batch-Datei verwendet das Kommandozeilenprogramm des „ST-Link-Utilities, um den Chip zu flashen, zu überprüfen und danach zu reseten.)
6. Sollte sich bei Klick auf das Icon eine Message-Box mit dem Fehler „Variable references empty selection: ${project_name}“ erscheinen, dann muss einfach „in“ eine Datei im Editor-Fenster geklickt werden, so dass der Eingabefokus auf dieser Datei liegt. Wenn dann wieder auf das Icon geklickt wird, sollte es funktionieren.

Weitere Einstellungen

Standardmäßig speichert die IDE die geänderten Dateien vor einem neuen Build nicht. Um dies zu verändern kann wie folgt vorgegangen werden:

1. „Window“ → „Preferences“
2. In der linken Spalte „General“ → „Workspace“ auswählen.
3. Die Option „Save automatically before build“ auswählen.

5.2 Übersicht über Sourcecode

5.3 Belegung der Ressourcen

In Tabelle 5.1 sind die aktuell verwendeten Ressourcen (ohne einzelne GPIOs) aufgeführt. In Tabelle 5.2 sind die noch freien Ressourcen gelistet, wobei sich die Aufzählung nur auf die Ressourcen beschränkt, die direkt mit Pins des ucboards verknüpft sind.

Tabelle 5.1.: Verwendete Ressourcen Ressource Verwendung

TIM2 | PWM-Erzeugung für Fahrtenregler und Lenkservo
SPI1 | Kommunikation mit IMU und Eeprom
I2C1 | Kommunikation mit Ultraschallsensoren
USART2 | Kommunikation mit PC über USB
USART3 | Kommunikation mit PC über RS232
EXTI15 | Externer Interrupt zur Auswertung Hal-Sensor
TIM6 | Timer für i2cmgr
TIM15 | Timer für stopwatch
TIM20 | Timer für stopwatch

Tabelle 5.2.: Freie Ressourcen (über Pins „zugreifbar“)
Ressource | Anmerkung

ADC1, ADC3, ADC4
TIM1, TIM8
I2C2, I2C3
SPI2, SPI4
UART4

# 6 Schaltungsentwurf

6.1 Beschreibung

6.2 Auslegung

Spannungsteiler mit RC-Glied

R1 | R3
Uin | R2 | C | Uout

Abbildung 6.1.: Spannungsteiler mit RC-Glied

Die Schaltung aus Abbildung 6.1 (ideale Spannungsquelle am Eingang, offene Klemmen am Ausgang) stellt ein PT1

-Glied mit der stationären Verstärkung

R2
R1 + R2

und der Zeitkonstante

T = C ·

R1R2
R1 + R2

+ R3

dar.

6.3 Verbesserungen für weitere Versionen

- Hall-Sensor muss nicht über OpAmp geleitet werden. Dafür wäre ein 5 V-toleranter Eingang empfehlenswert.

# 7 Aufbau Fahrzeug

7.1 Erstinbetriebnahme

- Bevor der Fahrzeugaufbau auf das Chassis gesetzt wird, muss der Fahrtenregler kalibriert werden.
