tud-pses/ucboard/kicad_ucboard/ucboard_Teileliste.xlsx

Reference | Value | Spec | Package | Supply | Part No. | URL | Datasheet | Price | Footprint
C1 | 4u7 | 25V | 1206 | Farnell | 1828835 | http://de.farnell.com/murata/grm31cr71e475ka88l/kondensator-mlcc-x7r-4-7uf-25v/dp/1828835 |  | 0.154 | Capacitors_SMD:C_1206_HandSoldering
C10 | 100n |  |  |  |  |  |  |  | Capacitors_SMD:C_0603_HandSoldering
C11 | 27p |  | 805 | Farnell | 7568584 | http://de.farnell.com/avx/08052u270gat2a/hf-kondensator-c0g-np0-27pf-200v/dp/7568584 |  | 0.227 | Capacitors_SMD:C_0805_HandSoldering
C12 | 27p |  | 805 | Farnell | 7568584 | http://de.farnell.com/avx/08052u270gat2a/hf-kondensator-c0g-np0-27pf-200v/dp/7568584 |  | 0.227 | Capacitors_SMD:C_0805_HandSoldering
C13 | 100n |  |  |  |  |  |  |  | Capacitors_SMD:C_0603_HandSoldering
C14 | 1m | Elko 25V |  | Farnell | 2469429 | http://de.farnell.com/rubycon/25zls1000mefc10x20/alu-elko-1000uf-25v-radial/dp/2469429 |  | 0.661 | Capacitors_ThroughHole:C_Radial_D10_L20_P5-7.5
C15 | 100n |  |  |  |  |  |  |  | Capacitors_SMD:C_0603_HandSoldering
C16 | 4u7 | 25V | 1206 | Farnell | 1828835 | http://de.farnell.com/murata/grm31cr71e475ka88l/kondensator-mlcc-x7r-4-7uf-25v/dp/1828835 |  | 0.154 | Capacitors_SMD:C_1206_HandSoldering
C17 | 4u7 | 25V | 1206 | Farnell | 1828835 | http://de.farnell.com/murata/grm31cr71e475ka88l/kondensator-mlcc-x7r-4-7uf-25v/dp/1828835 |  | 0.154 | Capacitors_SMD:C_1206_HandSoldering
C18 | n.B. |  |  |  |  |  |  |  | Capacitors_SMD:C_0603_HandSoldering
C19 | 100n |  |  |  |  |  |  |  | Capacitors_SMD:C_0603_HandSoldering
C2 | 1u | 6V3 | 603 | Farnell | 2346901 | http://de.farnell.com/tdk/c1608x7r1e105k080ab/kondensator-mlcc-x7r-1uf-25v-0603/dp/2346901 |  | 0.0858 | Capacitors_SMD:C_0603_HandSoldering
C20 | 1u | 6V3 | 603 | Farnell | 2346901 | http://de.farnell.com/tdk/c1608x7r1e105k080ab/kondensator-mlcc-x7r-1uf-25v-0603/dp/2346901 |  | 0.0858 | Capacitors_SMD:C_0603_HandSoldering
C21 | 470n |  |  |  |  |  |  |  | Capacitors_SMD:C_0603_HandSoldering
C22 | 1m | Elko 6V3 |  | Farnell | 2469429 | http://de.farnell.com/rubycon/25zls1000mefc10x20/alu-elko-1000uf-25v-radial/dp/2469429 |  | 0.661 | Capacitors_ThroughHole:C_Radial_D10_L20_P5-7.5
C23 | 1u | 6V3 | 603 | Farnell | 2346901 | http://de.farnell.com/tdk/c1608x7r1e105k080ab/kondensator-mlcc-x7r-1uf-25v-0603/dp/2346901 |  | 0.0858 | Capacitors_SMD:C_0603_HandSoldering
C24 | 470n |  |  |  |  |  |  |  | Capacitors_SMD:C_0603_HandSoldering
C25 | n.B. |  |  |  |  |  |  |  | Capacitors_SMD:C_0603_HandSoldering
C26 | 100n | 6V3 |  |  |  |  |  |  | Capacitors_SMD:C_0603_HandSoldering
C27 | 100n |  |  |  |  |  |  |  | Capacitors_SMD:C_0603_HandSoldering
C28 | 100n |  |  |  |  |  |  |  | Capacitors_SMD:C_0603_HandSoldering
C29 | 10n | X7R 4V |  |  |  |  |  |  | Capacitors_SMD:C_0603_HandSoldering
C3 | 100n |  |  |  |  |  |  |  | Capacitors_SMD:C_0603_HandSoldering
C30 | 100n | X7R 4V |  |  |  |  |  |  | Capacitors_SMD:C_0603_HandSoldering
C31 | 100n | 6V3 |  |  |  |  |  |  | Capacitors_SMD:C_0603_HandSoldering
C32 | 100n |  |  |  |  |  |  |  | Capacitors_SMD:C_0603_HandSoldering
C33 | 100n |  |  |  |  |  |  |  | Capacitors_SMD:C_0603_HandSoldering
C34 | 100n | X7R 2V |  |  |  |  |  |  | Capacitors_SMD:C_0603_HandSoldering
C35 | 100n |  |  |  |  |  |  |  | Capacitors_SMD:C_0603_HandSoldering
C36 | 100n | 6V3 |  |  |  |  |  |  | Capacitors_SMD:C_0603_HandSoldering
C37 | 4u7 | 25V | 1206 | Farnell | 1828835 | http://de.farnell.com/murata/grm31cr71e475ka88l/kondensator-mlcc-x7r-4-7uf-25v/dp/1828835 |  | 0.154 | Capacitors_SMD:C_1206_HandSoldering
C38 | 100n | 6V3 |  |  |  |  |  |  | Capacitors_SMD:C_0603_HandSoldering
C39 | 100n |  |  |  |  |  |  |  | Capacitors_SMD:C_0603_HandSoldering
C4 | 10n |  |  |  |  |  |  |  | Capacitors_SMD:C_0603_HandSoldering
C40 | n.B. |  |  |  |  |  |  |  | Capacitors_SMD:C_0603_HandSoldering
C41 | n.B. |  |  |  |  |  |  |  | Capacitors_SMD:C_0603_HandSoldering
C43 | n.B. |  |  |  |  |  |  |  | Capacitors_SMD:C_0603_HandSoldering
C44 | n.B. |  |  |  |  |  |  |  | Capacitors_SMD:C_0603_HandSoldering
C45 | n.B. |  |  |  |  |  |  |  | Capacitors_SMD:C_0603_HandSoldering
C46 | n.B. |  |  |  |  |  |  |  | Capacitors_SMD:C_0603_HandSoldering
C47 | n.B. |  |  |  |  |  |  |  | Capacitors_SMD:C_0603_HandSoldering
C48 | n.B. |  |  |  |  |  |  |  | Capacitors_SMD:C_0603_HandSoldering
C49 | n.B. |  |  |  |  |  |  |  | Capacitors_SMD:C_0603_HandSoldering
C5 | 100n |  |  |  |  |  |  |  | Capacitors_SMD:C_0603_HandSoldering
C50 | n.B. |  |  |  |  |  |  |  | Capacitors_SMD:C_0603_HandSoldering
C6 | 1u | 6V3 | 603 | Farnell | 2346901 | http://de.farnell.com/tdk/c1608x7r1e105k080ab/kondensator-mlcc-x7r-1uf-25v-0603/dp/2346901 |  | 0.0858 | Capacitors_SMD:C_0603_HandSoldering
C7 | 100n |  |  |  |  |  |  |  | Capacitors_SMD:C_0603_HandSoldering
C8 | 10n |  |  |  |  |  |  |  | Capacitors_SMD:C_0603_HandSoldering
C9 | 100n |  |  |  |  |  |  |  | Capacitors_SMD:C_0603_HandSoldering
D1 | LED |  |  |  |  |  |  |  | Custom:LED_0603_HandSoldering
D2 | LED |  |  |  |  |  |  |  | Custom:LED_0603_HandSoldering
D3 | LED |  |  |  |  |  |  |  | Custom:LED_0603_HandSoldering
D4 | LED |  |  |  |  |  |  |  | Custom:LED_0603_HandSoldering
D5 | LED |  |  |  |  |  |  |  | Custom:LED_0603_HandSoldering
D6 | LED |  |  |  |  |  |  |  | Custom:LED_0603_HandSoldering
IC1 | FT232RL |  | SSOP-28 | Farnell | 1146032 | http://de.farnell.com/ftdi/ft232rl-reel/usb-uart-smd-ssop28-232/dp/1146032 | http://www.farnell.com/datasheets/2007793.pdf | 4.25 | Housings_SSOP:SSOP-28_5.3x10.2mm_Pitch0.65mm
L1 | 8u2 |  |  | Farnell | 2061651 | http://de.farnell.com/bourns/srn6045-8r2y/leistungsinduktivit-t-8-2uh-halb/dp/2061651?ost=2061651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 | http://www.farnell.com/datasheets/1875285.pdf | 0.512 | Custom:SRN6045
L2 | L_Small | Spule oder Ferritperle |  |  |  |  |  |  | Resistors_SMD:R_0805_HandSoldering
L3 | Ferrit | Spule oder Ferritperle |  |  |  |  |  |  | Resistors_SMD:R_0805_HandSoldering
P1 | Powerpath In |  | 1x5 | Reichelt | PS25_5G | http://www.reichelt.de/index.html?ACTION=3;ARTICLE=40400;SEARCH=PS%2025/5G%20BR |  | 0.63 | Custom:PS25_5G
P10 | BATTERY 2 |  | 1x3 Header | Reichelt | PS25 3G | http://www.reichelt.de/index.html?ACTION=3;ARTICLE=40274;SEARCH=PS%2025/3G%20BR |  | 0.48 | Custom:PS25_3G
P11 | Timer8 |  | 1x5 Header |  |  |  |  |  | Pin_Headers:Pin_Header_Straight_1x05
P12 | Timer20 |  | 1x5 Header |  |  |  |  |  | Pin_Headers:Pin_Header_Straight_1x05
P13 | USB_B |  |  | Reichelt | USB BW | http://www.reichelt.de/USB-Einbauverbinder/USB-BW/3/index.html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 | http://cdn-reichelt.de/documents/datenblatt/C120/USBBW.pdf | 0.26 | Custom:USB_B
P14 | CAR-ID |  | 2x4 DIP SW | Reichelt | NT 04 | http://www.reichelt.de/Dip-Kodierschalter/NT-04/3/index.html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 | http://cdn-reichelt.de/documents/datenblatt/C200/NT06%24_NT02%24_NT04%24_NT06%24_NT08%24_NT10%24%23IMP.pdf | 0.24 | Buttons_Switches_ThroughHole:SW_DIP_x4_Slide
P15 | JTAG |  | 2x10 | Reichelt | WSL 20G | http://www.reichelt.de/WSL-20G/3/index.html?ACTION=3&LA=446&ARTICLE=22825&artnr=WSL+20G&SEARCH=wannenstecker |  | 0.12 | Connect:IDC_Header_Straight_20pins
P16 | DIO |  | 2x6 Header |  |  |  |  |  | Pin_Headers:Pin_Header_Straight_2x06
P17 | ADC |  | 2x5 Header |  |  |  |  |  | Pin_Headers:Pin_Header_Straight_2x05
P18 | MPU-9250_EXT |  | 1x7 Header |  |  |  |  |  | Pin_Headers:Pin_Header_Straight_1x07
P19 | SFR08_I2C |  | 1x5 Header |  |  |  |  |  | Pin_Headers:Pin_Header_Straight_1x05
P2 | PWM_SERVO |  | 1x3 Header |  |  |  |  |  | Pin_Headers:Pin_Header_Straight_1x03
P20 | I2C2 |  | 2x4 Wannenstecker |  |  |  |  |  | Custom:IDC_Header_Straight_8pins
P21 | I2C3 |  | 2x4 Wannenstecker |  |  |  |  |  | Custom:IDC_Header_Straight_8pins
P22 | Serial Port |  | 2x5 Header | Reichelt | WSL 10G | http://www.reichelt.de/WSL-10G/3/index.html?ACTION=3&LA=446&ARTICLE=22816&artnr=WSL+10G&SEARCH=wannenstecker |  | 0.09 | Connect:IDC_Header_Straight_10pins
P23 | 5V |  | 2x2 Header |  |  |  |  |  | Pin_Headers:Pin_Header_Straight_2x02
P24 | 5V |  | 2x2 Header |  |  |  |  |  | Pin_Headers:Pin_Header_Straight_2x02
P25 | 3.3V |  | 2x2 Header |  |  |  |  |  | Pin_Headers:Pin_Header_Straight_2x02
P26 | UART4 |  | 2x3 Header |  |  |  |  |  | Pin_Headers:Pin_Header_Straight_2x03
P27 | SPI2 |  | 2x7 | Reichelt | WSL 14G | http://www.reichelt.de/WSL-14G/3/index.html?ACTION=3&LA=446&ARTICLE=22819&artnr=WSL+14G&SEARCH=wannenstecker |  | 0.12 | Connect:IDC_Header_Straight_14pins
P28 | SPI4 |  | 2x7 | Reichelt | WSL 14G | http://www.reichelt.de/WSL-14G/3/index.html?ACTION=3&LA=446&ARTICLE=22819&artnr=WSL+14G&SEARCH=wannenstecker |  | 0.12 | Connect:IDC_Header_Straight_14pins
P29 | 5V_Servo |  | 2x2 Header |  |  |  |  |  | Pin_Headers:Pin_Header_Straight_2x02
P3 | PWM_DRIVE |  | 1x2 Header |  |  |  |  |  | Pin_Headers:Pin_Header_Straight_1x02
P4 | BATT2_IN |  | 2x3 | Reichelt | WAGO 713-1423 | http://www.reichelt.de/WAGO-713-1403/3/index.html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 | http://cdn-reichelt.de/documents/datenblatt/C151/WAGO713-14X.pdf | 1.2 | Custom:WAGO_713-1423
P5 | ADC12 |  | 2x3 | Reichelt | WSL 6G | http://www.reichelt.de/Pfosten-Wannenstecker/WSL-6G/3/index.html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 |  | 0.16 | Custom:IDC_Header_Straight_6pins
P6 | BATT2_REG_OUT |  | 2x3 | Reichelt | WAGO 713-1423 | https://www.reichelt.de/WAGO-713-1423/3/index.html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 | http://cdn-reichelt.de/documents/datenblatt/C151/WAGO713-14X.pdf | 1.2 | Custom:WAGO_713-1423
P7 | Timer1 |  | 1x3 Header |  |  |  |  |  | Pin_Headers:Pin_Header_Straight_1x03
P8 | Timer3 |  | 1x3 Header |  |  |  |  |  | Pin_Headers:Pin_Header_Straight_1x03
P9 | Hal5 |  | 1x4 Header |  |  |  |  |  | Pin_Headers:Pin_Header_Straight_1x04
PD2 | Hole |  |  |  |  |  |  |  | Custom:MountingHole_3.3mm_M3
PD3 | Hole |  |  |  |  |  |  |  | Custom:MountingHole_3.3mm_M3
PD4 | Hole |  |  |  |  |  |  |  | Custom:MountingHole_3.3mm_M3
PD5 | Hole |  |  |  |  |  |  |  | Custom:MountingHole_3.3mm_M3
PD6 | Hole |  |  |  |  |  |  |  | Custom:MountingHole_3.3mm_M3
Q1 | IRLML9301 |  | SOT-23 | farnell | 1831089 | http://de.farnell.com/infineon/irlml9301trpbf/mosfet-diode-p-kanal-30v-3-6a/dp/1831089 | http://www.farnell.com/datasheets/1749827.pdf | 0.224 | TO_SOT_Packages_SMD:SOT-23_Handsoldering
Q2 | IRLML6344 |  | SOT-23 | Farnell | 1857299 | http://de.farnell.com/international-rectifier/irlml6344trpbf/mosfet-n-kanal-30v-5a-sot23/dp/1857299 | http://www.farnell.com/datasheets/1911844.pdf | 0.168 | TO_SOT_Packages_SMD:SOT-23_Handsoldering
Q3 | IRLML6344 |  | SOT-23 | Farnell | 1857299 | http://de.farnell.com/international-rectifier/irlml6344trpbf/mosfet-n-kanal-30v-5a-sot23/dp/1857299 | http://www.farnell.com/datasheets/1911844.pdf | 0.168 | TO_SOT_Packages_SMD:SOT-23_Handsoldering
Q4 | IRLML9301 |  | SOT-23 | farnell | 1831089 | http://de.farnell.com/infineon/irlml9301trpbf/mosfet-diode-p-kanal-30v-3-6a/dp/1831089 | http://www.farnell.com/datasheets/1749827.pdf | 0.224 | TO_SOT_Packages_SMD:SOT-23_Handsoldering
Q5 | IRLML9301 |  | SOT-23 | farnell | 1831089 | http://de.farnell.com/infineon/irlml9301trpbf/mosfet-diode-p-kanal-30v-3-6a/dp/1831089 | http://www.farnell.com/datasheets/1749827.pdf | 0.224 | TO_SOT_Packages_SMD:SOT-23_Handsoldering
Q6 | IRLML6344 |  | SOT-23 | Farnell | 1857299 | http://de.farnell.com/international-rectifier/irlml6344trpbf/mosfet-n-kanal-30v-5a-sot23/dp/1857299 | http://www.farnell.com/datasheets/1911844.pdf | 0.168 | TO_SOT_Packages_SMD:SOT-23_Handsoldering
R1 | 0R |  |  |  |  |  |  |  | Resistors_SMD:R_0603_HandSoldering
R10 | 100R |  |  |  |  |  |  |  | Resistors_SMD:R_0603_HandSoldering
R11 | 10k |  |  |  |  |  |  |  | Resistors_SMD:R_0603_HandSoldering
R12 | 10k |  |  |  |  |  |  |  | Resistors_SMD:R_0603_HandSoldering
R13 | 10k |  |  |  |  |  |  |  | Resistors_SMD:R_0603_HandSoldering
R14 | 10k |  |  |  |  |  |  |  | Resistors_SMD:R_0603_HandSoldering
R15 | n.B. |  |  |  |  |  |  |  | Resistors_SMD:R_0603_HandSoldering
R16 | n.B. |  |  |  |  |  |  |  | Resistors_SMD:R_0603_HandSoldering
R17 | 10k |  |  |  |  |  |  |  | Resistors_SMD:R_0603_HandSoldering
R18 | 0R |  |  |  |  |  |  |  | Resistors_SMD:R_0603_HandSoldering
R19 | n.B. |  |  |  |  |  |  |  | Resistors_SMD:R_0603_HandSoldering
R2 | 470R |  |  |  |  |  |  |  | Resistors_SMD:R_0603_HandSoldering
R20 | 0R |  |  |  |  |  |  |  | Resistors_SMD:R_0603_HandSoldering
R21 | n.B. |  |  |  |  |  |  |  | Resistors_SMD:R_0603_HandSoldering
R22 | 14k | 0.10% |  |  |  |  |  |  | Resistors_SMD:R_0603_HandSoldering
R23 | 11k | 0.10% |  |  |  |  |  |  | Resistors_SMD:R_0603_HandSoldering
R24 | n.B. |  |  |  |  |  |  |  | Resistors_SMD:R_0603_HandSoldering
R25 | 10k |  |  |  |  |  |  |  | Resistors_SMD:R_0603_HandSoldering
R26 | n.B. |  |  |  |  |  |  |  | Resistors_SMD:R_0603_HandSoldering
R27 | 10k |  |  |  |  |  |  |  | Resistors_SMD:R_0603_HandSoldering
R28 | n.B. |  |  |  |  |  |  |  | Resistors_SMD:R_0603_HandSoldering
R29 | 27k |  |  |  |  |  |  |  | Resistors_SMD:R_0603_HandSoldering
R3 | n.B. |  |  |  |  |  |  |  | Resistors_SMD:R_0603_HandSoldering
R30 | n.B. |  |  |  |  |  |  |  | Resistors_SMD:R_0603_HandSoldering
R31 | 10k |  |  |  |  |  |  |  | Resistors_SMD:R_0603_HandSoldering
R32 | 2k7 |  |  |  |  |  |  |  | Resistors_SMD:R_0603_HandSoldering
R33 | n.B. |  |  |  |  |  |  |  | Resistors_SMD:R_0603_HandSoldering
R34 | n.B. |  |  |  |  |  |  |  | Resistors_SMD:R_0603_HandSoldering
R35 | n.B. |  |  |  |  |  |  |  | Resistors_SMD:R_0603_HandSoldering
R36 | n.B. |  |  |  |  |  |  |  | Resistors_SMD:R_0603_HandSoldering
R37 | n.B. |  |  |  |  |  |  |  | Resistors_SMD:R_0603_HandSoldering
R38 | 10k |  |  |  |  |  |  |  | Resistors_SMD:R_0603_HandSoldering
R39 | 10k |  |  |  |  |  |  |  | Resistors_SMD:R_0603_HandSoldering
R4 | 10k |  |  |  |  |  |  |  | Resistors_SMD:R_0603_HandSoldering
R40 | 10k |  |  |  |  |  |  |  | Resistors_SMD:R_0603_HandSoldering
R41 | 4k7 |  |  |  |  |  |  |  | Resistors_SMD:R_0603_HandSoldering
R42 | 10k |  |  |  |  |  |  |  | Resistors_SMD:R_0603_HandSoldering
R43 | 680R |  |  |  |  |  |  |  | Resistors_SMD:R_0603_HandSoldering
R44 | 680R |  |  |  |  |  |  |  | Resistors_SMD:R_0603_HandSoldering
R45 | 680R |  |  |  |  |  |  |  | Resistors_SMD:R_0603_HandSoldering
R46 | 0R |  |  |  |  |  |  |  | Resistors_SMD:R_0603_HandSoldering
R47 | 1k |  |  |  |  |  |  |  | Resistors_SMD:R_0603_HandSoldering
R48 | 1k |  |  |  |  |  |  |  | Resistors_SMD:R_0603_HandSoldering
R49 | 680R |  |  |  |  |  |  |  | Resistors_SMD:R_0603_HandSoldering
R5 | 0R |  |  |  |  |  |  |  | Resistors_SMD:R_0603_HandSoldering
R50 | 0R |  |  |  |  |  |  |  | Resistors_SMD:R_0603_HandSoldering
R51 | 0R |  |  |  |  |  |  |  | Resistors_SMD:R_0603_HandSoldering
R52 | 0R |  |  |  |  |  |  |  | Resistors_SMD:R_0603_HandSoldering
R53 | 0R |  |  |  |  |  |  |  | Resistors_SMD:R_0603_HandSoldering
R54 | 0R |  |  |  |  |  |  |  | Resistors_SMD:R_0603_HandSoldering
R55 | 0R |  |  |  |  |  |  |  | Resistors_SMD:R_0603_HandSoldering
R56 | 0R |  |  |  |  |  |  |  | Resistors_SMD:R_0603_HandSoldering
R57 | 0R |  |  |  |  |  |  |  | Resistors_SMD:R_0603_HandSoldering
R58 | 0R |  |  |  |  |  |  |  | Resistors_SMD:R_0603_HandSoldering
R59 | 0R |  |  |  |  |  |  |  | Resistors_SMD:R_0603_HandSoldering
R6 | 56k | 0.10% |  |  |  |  |  |  | Resistors_SMD:R_0603_HandSoldering
R60 | 680R |  |  |  |  |  |  |  | Resistors_SMD:R_0603_HandSoldering
R61 | n.B. |  |  |  |  |  |  |  | Resistors_SMD:R_0603_HandSoldering
R62 | 0R |  |  |  |  |  |  |  | Resistors_SMD:R_0603_HandSoldering
R63 | 100R |  |  |  |  |  |  |  | Resistors_SMD:R_0603_HandSoldering
R64 | 100R |  |  |  |  |  |  |  | Resistors_SMD:R_0603_HandSoldering
R65 | n.B. |  |  |  |  |  |  |  | Resistors_SMD:R_0603_HandSoldering
R66 | n.B. |  |  |  |  |  |  |  | Resistors_SMD:R_0603_HandSoldering
R67 | 10k |  |  |  |  |  |  |  | Resistors_SMD:R_0603_HandSoldering
R7 | 680R |  |  |  |  |  |  |  | Resistors_SMD:R_0603_HandSoldering
R8 | 0R |  |  |  |  |  |  |  | Resistors_SMD:R_0603_HandSoldering
R9 | 100R |  |  |  |  |  |  |  | Resistors_SMD:R_0603_HandSoldering
SW1 | RESET |  |  | Reichelt | TASTER 9314 | http://www.reichelt.de/Kurzhubtaster/TASTER-9314/3/index.html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 | http://cdn-reichelt.de/documents/datenblatt/C200/JTP_1138_02.pdf | 0.22 | Custom:BUTTON
SW2 | Button1 |  |  | Reichelt | TASTER 9314 | http://www.reichelt.de/Kurzhubtaster/TASTER-9314/3/index.html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 | http://cdn-reichelt.de/documents/datenblatt/C200/JTP_1138_02.pdf | 0.22 | Custom:BUTTON
SW3 | Button2 |  |  | Reichelt | TASTER 9314 | http://www.reichelt.de/Kurzhubtaster/TASTER-9314/3/index.html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 | http://cdn-reichelt.de/documents/datenblatt/C200/JTP_1138_02.pdf | 0.22 | Custom:BUTTON
SW4 | Button3 |  |  | Reichelt | TASTER 9314 | http://www.reichelt.de/Kurzhubtaster/TASTER-9314/3/index.html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 | http://cdn-reichelt.de/documents/datenblatt/C200/JTP_1138_02.pdf | 0.22 | Custom:BUTTON
U1 | STM32F303VE |  |  | Digikey | 497-15164-ND | http://www.digikey.de/product-search/de/integrated-circuits-ics/embedded-microcontrollers/2556109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 | http://www.st.com/content/ccc/resource/technical/document/datasheet/2c/6f/d7/64/1f/a3/4f/c9/DM00118585.pdf/files/DM00118585.pdf/jcr:content/translations/en.DM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 | 7.39 | Custom:LQFP100_14x14mm
U2 | TEN_30-1212 |  |  | Farnell | 1772204 | http://de.farnell.com/tracopower/ten-30-1212/wandler-dc-dc-30w-12v-2-5a/dp/1772204?selectedCategoryId=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 | http://www.farnell.com/datasheets/1763557.pdf | 56.5 | Custom:TEN30
U3 | MCP6054 | MCP6054-E/SL | SOIC 14 | Farnell | 1715855 | http://de.farnell.com/microchip/mcp6054-e-sl/op-amp-quad-1-8v-300khz-14soic/dp/1715855 | http://www.farnell.com/datasheets/1062686.pdf | 1.74 | Housings_SOIC:SOIC-14_3.9x8.7mm_Pitch1.27mm
U4 | TSR_1-2450 |  |  | Farnell | 1696320 | http://de.farnell.com/tracopower/tsr-1-2450/wandler-dc-dc-5v-1a-sip/dp/1696320?selectedCategoryId=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 | http://www.tracopower.com/products/tsr1.pdf | 4.4 | Custom:TSR1
U5 | TSR_1-2450 |  |  | Farnell | 1696320 | http://de.farnell.com/tracopower/tsr-1-2450/wandler-dc-dc-5v-1a-sip/dp/1696320?selectedCategoryId=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 | http://www.tracopower.com/products/tsr1.pdf | 4.4 | Custom:TSR1
U6 | LD1117_S33TR |  | SOT-223 | Farnell | 1202826 | http://de.farnell.com/stmicroelectronics/ld1117s33tr/ldo-spann-regler-3-3v-smd-1117/dp/1202826 | http://www.farnell.com/datasheets/1776449.pdf | 0.297 | TO_SOT_Packages_SMD:SOT-223
U7 | MPU-9250 |  | QFN-24 3x3 | Digikey | 1428-1019-1-ND | http://www.digikey.de/product-detail/de/invensense/MPU-9250/1428-1019-1-ND/4626450 | https://store.invensense.com/datasheets/invensense/MPU9250REV1.0.pdf | 9.58 | Custom:MPU-9250
U8 | MAX3232 | MAX3232CDR | SOIC16 | Farnell | 1564957 | http://de.farnell.com/texas-instruments/max3232cdr/driver-receiver-rs232-3-5-5v/dp/1564957 | http://www.farnell.com/datasheets/2020372.pdf | 1.33 | Housings_SOIC:SOIC-16_3.9x9.9mm_Pitch1.27mm
U9 | 25LC160A-I/SN |  | SOIC 8 | Farnell | 1084340 | http://de.farnell.com/microchip/25lc160a-i-sn/eeprom-seriell-16kbit-10mhz-soic/dp/1084340 | http://www.farnell.com/datasheets/129934.pdf | 0.565 | Housings_SOIC:SOIC-8_3.9x4.9mm_Pitch1.27mm
Y1 | 8MHz |  |  | Farnell | 1842347 | http://de.farnell.com/txc/9c-8-000meej-t/xtal-8-000mhz-18pf-smd-hc-49s/dp/1842347?ost=1842347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 | http://www.farnell.com/datasheets/1497895.pdf | 0.581 | Custom:HC-49S_Crystal
