tud-pses/ucboard/kicad_drvbatswitch/drvbatswitch_Teileliste.xlsx

Reference | Value | Spec | Package | Supply | Part No. | URL | Datasheet | Price | Footprint
Q1 | IRLML6344 |  | SOT-23 | Farnell | 1857299 | http://de.farnell.com/international-rectifier/irlml6344trpbf/mosfet-n-kanal-30v-5a-sot23/dp/1857299 | http://www.farnell.com/datasheets/1911844.pdf | 0.168 | TO_SOT_Packages_SMD:SOT-23
Q2 | IPD90P03 |  | TO252 | Farnell | 2480839 | http://de.farnell.com/infineon/ipd90p03p4-04/mosfet-p-kanal-30v-90a-to-252/dp/2480839 | http://www.farnell.com/datasheets/1932578.pdf | 1.39 | TO_SOT_Packages_SMD:TO-252-2Lead
P3 | uC_IN |  | 1x3 Angled | Reichelt | PS 25/3W BR | http://www.reichelt.de/PS-25-3W-BR/3/index.html?ACTION=3&LA=446&ARTICLE=14828&artnr=PS+25%2F3W+BR&SEARCH=PS+25 | http://cdn-reichelt.de/documents/datenblatt/C151/PS25_xxWBR.pdf | 0.42 | Custom:PS25_3W
C1 | 100n | 4V |  |  |  |  |  |  | Capacitors_SMD:C_0603_HandSoldering
R1 | 10k |  |  |  |  |  |  |  | Resistors_SMD:R_0603_HandSoldering
R2 | 10k |  |  |  |  |  |  |  | Resistors_SMD:R_0603_HandSoldering
C2 | 470n | 10V |  |  |  |  |  |  | Capacitors_SMD:C_0603_HandSoldering
PD1 | Hole |  |  |  |  |  |  |  | Custom:MountingHole_3.3mm_M3
PD2 | Hole |  |  |  |  |  |  |  | Custom:MountingHole_3.3mm_M3
R3 | 3k6 |  |  |  |  |  |  |  | Resistors_SMD:R_0603_HandSoldering
P1 | V_IN+ |  |  |  |  |  |  |  | Custom:Pad_SMD_3.5x10
P2 | V_IN- |  |  |  |  |  |  |  | Custom:Pad_SMD_3.5x10
P4 | V_OUT+ |  |  |  |  |  |  |  | Custom:Pad_SMD_3.5x10
P5 | V_OUT- |  |  |  |  |  |  |  | Custom:Pad_SMD_3.5x10
D1 | LED |  |  |  |  |  |  |  | Custom:LED_0603_HandSoldering
PD6 | Hole |  |  |  |  |  |  |  | Custom:Hole_3mm
PD10 | Hole |  |  |  |  |  |  |  | Custom:Hole_3mm
PD14 | Hole |  |  |  |  |  |  |  | Custom:Hole_3mm
PD18 | Hole |  |  |  |  |  |  |  | Custom:Hole_3mm
PD5 | Hole |  |  |  |  |  |  |  | Custom:Hole_3mm
PD9 | Hole |  |  |  |  |  |  |  | Custom:Hole_3mm
PD13 | Hole |  |  |  |  |  |  |  | Custom:Hole_3mm
PD17 | Hole |  |  |  |  |  |  |  | Custom:Hole_3mm
PD4 | Hole |  |  |  |  |  |  |  | Custom:Hole_3mm
PD8 | Hole |  |  |  |  |  |  |  | Custom:Hole_3mm
PD12 | Hole |  |  |  |  |  |  |  | Custom:Hole_3mm
PD16 | Hole |  |  |  |  |  |  |  | Custom:Hole_3mm
PD3 | Hole |  |  |  |  |  |  |  | Custom:Hole_3mm
PD7 | Hole |  |  |  |  |  |  |  | Custom:Hole_3mm
PD11 | Hole |  |  |  |  |  |  |  | Custom:Hole_3mm
PD15 | Hole |  |  |  |  |  |  |  | Custom:Hole_3mm
