tud-pses/ucboard/doc/latex/inc/aufbau.tex

\chapter{Aufbau Fahrzeug}

\section{Erstinbetriebnahme}

\begin{itemize}
	\item Bevor der Fahrzeugaufbau auf das Chassis gesetzt wird, muss der Fahrtenregler kalibriert werden.
\end{itemize}
