tud-pses/ucboard/ucboard_schematic.pdf

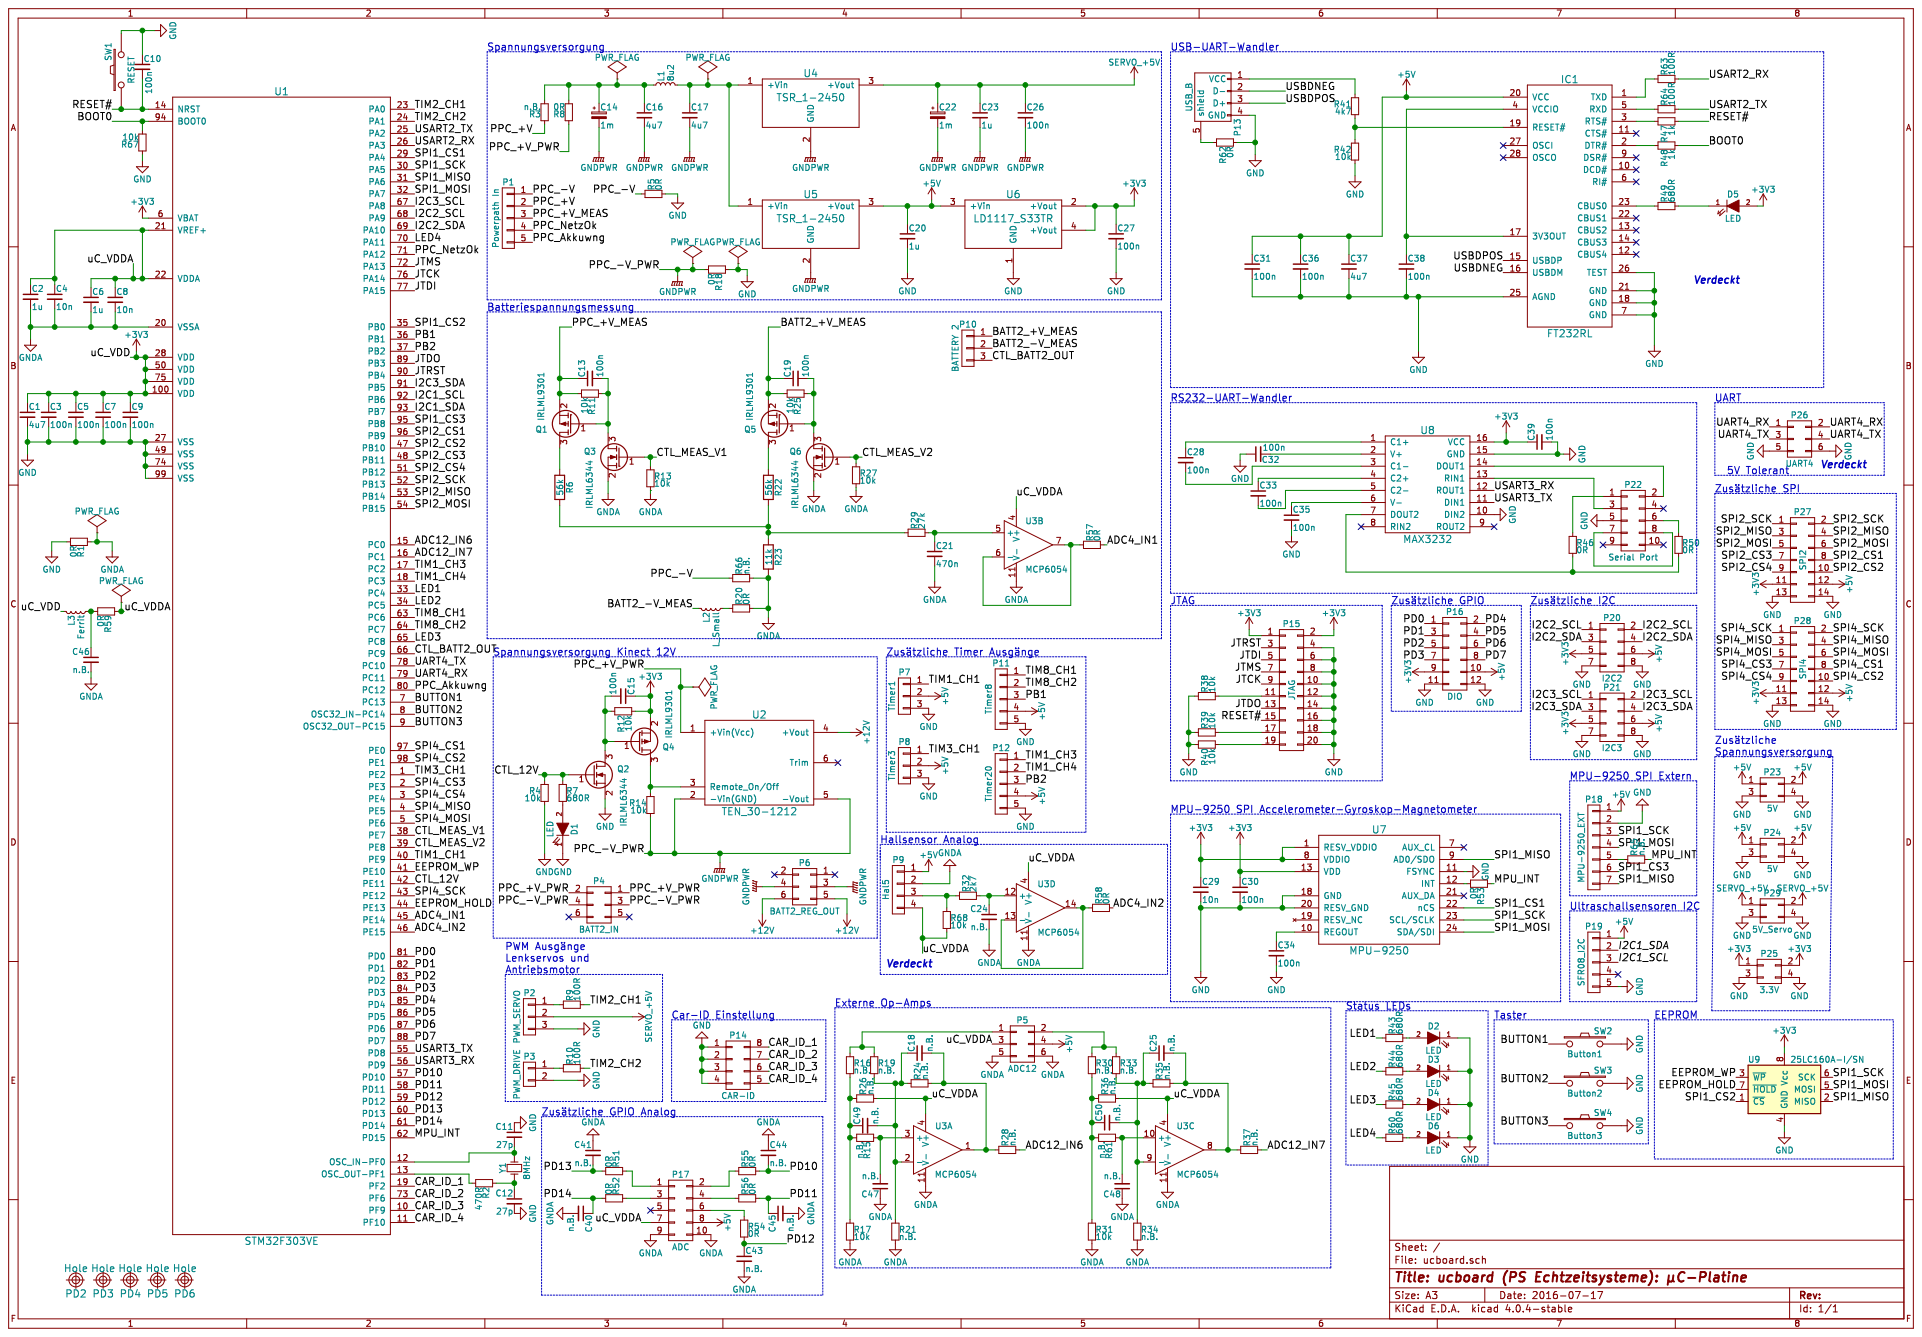
[picture p3: page 1]
