tud-pses/ucboard/fw_workspace/pses_ucboard/pses_ucboard.ioc

Mcu.UserName=STM32F303VETx
PA0.Signal=S_TIM2_CH1_ETR
PA1.Signal=S_TIM2_CH2
PA10.Signal=I2C2_SDA
PA11.Signal=GPIO_Output
PA12.Signal=GPIO_Input
PA13.Signal=SYS_JTMS-SWDIO
PA14.Signal=SYS_JTCK-SWCLK
PA15.Signal=SYS_JTDI
PA2.Signal=USART2_TX
PA3.Signal=USART2_RX
PA4.Signal=GPIO_Output
PA5.Signal=SPI1_SCK
PA6.Signal=SPI1_MISO
PA7.Signal=SPI1_MOSI
PA8.Signal=I2C3_SCL
PA9.Signal=I2C2_SCL
PB0.Signal=GPIO_Output
PB1.Signal=GPXTI1
PB10.Signal=GPIO_Output
PB11.Signal=GPIO_Output
PB12.Signal=GPIO_Output
PB13.Signal=SPI2_SCK
PB14.Signal=SPI2_MISO
PB15.Signal=SPI2_MOSI
PB2.Signal=GPXTI2
PB3.Signal=SYS_JTDO-TRACESWO
PB4.Signal=SYS_NJTRST
PB5.Signal=I2C3_SDA
PB6.Signal=I2C1_SCL
PB7.Signal=I2C1_SDA
PB8.Signal=GPIO_Output
PB9.Signal=GPIO_Output
PC0.Signal=ADCx_IN6
PC1.Signal=ADCx_IN7
PC10.Signal=UART4_TX
PC11.Signal=UART4_RX
PC12.Signal=GPIO_Input
PC13.Signal=GPIO_Input
PC14-OSC32_IN.Signal=GPIO_Input
PC15-OSC32_OUT.Signal=GPIO_Input
PC2.Signal=S_TIM1_CH3
PC3.Signal=S_TIM1_CH4
PC4.Signal=GPIO_Output
PC5.Signal=GPIO_Output
PC6.Signal=S_TIM8_CH1
PC7.Signal=S_TIM8_CH2
PC8.Signal=GPIO_Output
PC9.Signal=GPIO_Output
PD0.Signal=GPIO_Input
PD1.Signal=GPIO_Input
PD10.Signal=ADCx_IN7P
PD11.Signal=ADCx_IN8P
PD12.Signal=ADCx_IN9P
PD13.Signal=ADCx_IN10P
PD14.Signal=ADCx_IN11
PD15.Signal=GPXTI15
PD2.Signal=GPIO_Input
PD3.Signal=GPIO_Input
PD4.Signal=GPIO_Input
PD5.Signal=GPIO_Input
PD6.Signal=GPIO_Input
PD7.Signal=GPIO_Input
PD8.Signal=USART3_TX
PD9.Signal=USART3_RX
PE0.Signal=GPIO_Output
PE1.Signal=GPIO_Output
PE10.Signal=GPIO_Output
PE11.Signal=GPIO_Output
PE12.Signal=SPI4_SCK
PE13.Signal=GPIO_Output
PE14.Signal=ADC4_IN1
PE15.Signal=ADC4_IN2
PE2.Signal=S_TIM3_CH1
PE3.Signal=GPIO_Output
PE4.Signal=GPIO_Output
PE5.Signal=SPI4_MISO
PE6.Signal=SPI4_MOSI
PE7.Signal=GPIO_Output
PE8.Signal=GPIO_Output
PE9.Signal=S_TIM1_CH1
PF0-OSC_IN.Signal=RCC_OSC_IN
PF1-OSC_OUT.Signal=RCC_OSC_OUT
PF10.Signal=GPIO_Input
PF2.Signal=GPIO_Input
PF6.Signal=GPIO_Input
PF9.Signal=GPIO_Input
