tud-pses/ucboard/fw_workspace/pses_ucboard/devices/us_srf08.h

/*
 * us_srf08.h
 *
 *  Created on: 16.09.2016
 *      Author: elenz
 */

#ifndef US_SRF08_H_
#define US_SRF08_H_



#include "stdtypes.h"
#include "i2cmgr.h"


typedef struct USParam_ {
    uint8_t range;
    uint8_t gain;
} USParam_t;

typedef enum EnUSonicDataState_ {
    USONICDATA_IDLE,
    USONICDATA_INITMEASUREMENT,
    USONICDATA_CHECKIFCOMPLETED,
    USONICDATA_QUERYDATA
} EnUSonicDataState_t;


typedef enum EnUSDataQueryResult_ {
    USDATAQUERYRES_INPROGRESS,
    USDATAQUERYRES_OK,
    USDATAQUERYRES_ERROR
} EnUSDataQueryResult_t;

typedef enum EnUSDataAvailableQueryResult_ {
    USDATAAVAILABLEQUERYRES_INPROGRESS,
    USDATAAVAILABLEQUERYRES_DATAAVAILABLE,
    USDATAAVAILABLEQUERYRES_DATANOTAVAILABLE,
    USDATAAVAILABLEQUERYRES_ERROR
} EnUSDataAvailableQueryResult_t;

typedef enum EnUSConfigResult_ {
    USCONFIGRES_INPROGRESS,
    USCONFIGRES_OK,
    USCONFIGRES_ERROR
} EnUSConfigResult_t;


typedef struct USdevice_
{
    uint8_t uI2CDeviceID;
    EnI2C_PORT_t eI2CPort;
    uint8_t uI2CAddress;
    uint8_t acRxBuffer[10];
    uint8_t acTxBuffer[10];
    I2CMGR_Msg_t aMsgs[4];

    USParam_t param;

    bool bNewData;
    bool bStartNewMeasurement;

    uint16_t uCurData;
    uint16_t uCommErrorCount;
    EnUSonicDataState_t eDataState;
} USdevice_t;


typedef struct USbroadcaster_
{
    uint8_t uI2CDeviceID;
    EnI2C_PORT_t eI2CPort;
    uint8_t uI2CAddress;
    uint8_t acRxBuffer[10];
    uint8_t acTxBuffer[10];
    I2CMGR_Msg_t aMsgs[4];
} USbroadcaster_t;

typedef enum EnUSAddrChgState_
{
    USONIC_ADDRCHG_IDLE,
    USONIC_ADDRCHG_RUNNING,
    USONIC_ADDRCHG_SUCCESS,
    USONIC_ADDRCHG_ERR_INVALIDPARAM,
    USONIC_ADDRCHG_ERR_I2CERR,
    USONIC_ADDRCHG_ERR_DEVICENOTFOUND,
    USONIC_ADDRCHG_ERR_TOOMANYDEVICES,
    USONIC_ADDRCHG_ERR_NOTFOUNDAFTER,
} EnUSAddrChgState_t;


bool usonicbc_init(USbroadcaster_t* this, EnI2C_PORT_t ePort);
bool usonicbc_trigger(USbroadcaster_t* this);

bool usonic_init(USdevice_t* this, EnI2C_PORT_t ePort, uint8_t address, USParam_t param);
bool usonic_ping(USdevice_t* this);

bool usonic_guestping_start(EnI2C_PORT_t ePort, uint8_t address);
bool usonic_guestping_query(bool* pPingRes);

bool usonic_changeDeviceI2CAddress_init(EnI2C_PORT_t ePort, uint8_t oldaddress, uint8_t newaddress);
EnUSAddrChgState_t usonic_changeDeviceI2CAddress_do();

void usonic_setConfig(USdevice_t* this, const USParam_t* const param);

bool usonic_startConfig(USdevice_t* this);
EnUSConfigResult_t usonic_getConfigResult(USdevice_t* this);

bool usonic_startDataAvailableQuery(USdevice_t* this);
EnUSDataAvailableQueryResult_t usonic_getDataAvailableQueryResult(USdevice_t* this);

bool usonic_startDataQuery(USdevice_t* this);
EnUSDataQueryResult_t usonic_getDataQueryResult(USdevice_t* this, uint16_t* pVal);

static inline bool usonic_hasNewData(USdevice_t* this);
static inline bool usonic_getData(USdevice_t* this, uint16_t* pDistance);
void usonic_copyData(USdevice_t* this, uint16_t* pData);
void usonic_do(USdevice_t* this);
void usonic_trigger(USdevice_t* this);

static inline bool usonic_hasNewData(USdevice_t* this)
{
    return this->bNewData;
}

static inline bool usonic_getData(USdevice_t* this, uint16_t* pDistance)
{
    if (!this->bNewData)
    {
        return false;
    }
    else
    {
        usonic_copyData(this, pDistance);
        this->bNewData = false;
    }

    return true;
}


#define US_SLAVE_ADDR_OLD    0xE0
#define US_SLAVE_ADDR_NEW    0xE2    //!!!!!!!!

#define US_SLAVE_ADDR        US_SLAVE_ADDR_OLD
#define US_SLAVE_ADDR_READ    (US_SLAVE_ADDR+1)

#define US_ADDR_FIRMWARE    0
#define US_ADDR_DISTANCE_H    2
#define US_ADDR_DISTANCE_L    3

#define US_ADDR_CMD            0
#define US_ADDR_GAIN        1
#define US_ADDR_RANGE        2

#define    US_CMD_MEASURE_INCH        80
#define US_CMD_MEASURE_CM        81
#define US_CMD_MEASURE_US        82
#define US_CMD_MEASUREMENT        US_CMD_MEASURE_US


#define US_CMD_SET_SLAVEID_1BYTE    160
#define US_CMD_SET_SLAVEID_3BYTE    165
#define US_CMD_SET_SLAVEID_2BYTE    170




#define GET_RANGE_MM(rangeval) (((rangeval) + 1) * 43)
#define GET_MEASDURATION_MS(rangeval) ((((rangeval) + 1) * 250) / 1000)



//Werte für US_ADDR_GAIN
#define US_GAIN_94        0
#define US_GAIN_97        1
#define US_GAIN_100        2
#define US_GAIN_103        3
#define US_GAIN_107        4
#define US_GAIN_110        5
#define US_GAIN_114        6
#define US_GAIN_118        7
#define US_GAIN_123        8
#define US_GAIN_128        9
#define US_GAIN_133        10
#define US_GAIN_139        11
#define US_GAIN_145        12
#define US_GAIN_152        13
#define US_GAIN_159        14
#define US_GAIN_168        15
#define US_GAIN_177        16
#define US_GAIN_187        17
#define US_GAIN_199        18
#define US_GAIN_212        19
#define US_GAIN_227        20
#define US_GAIN_245        21
#define US_GAIN_265        22
#define US_GAIN_288        23
#define US_GAIN_317        24
#define US_GAIN_352        25
#define US_GAIN_395        26
#define US_GAIN_450        27
#define US_GAIN_524        28
#define US_GAIN_626        29
#define US_GAIN_777        30
#define US_GAIN_1025    31

#define US_GAIN_INIT    US_GAIN_177




#define US_RANGE_43MM            0
#define US_RANGE_86MM            1
#define US_RANGE_129MM            2
#define US_RANGE_172MM            3
#define US_RANGE_215MM            4
#define US_RANGE_258MM            5
#define US_RANGE_301MM            6
#define US_RANGE_344MM            7
#define US_RANGE_387MM            8
#define US_RANGE_430MM            9
#define US_RANGE_473MM            10
#define US_RANGE_516MM            11
#define US_RANGE_559MM            12
#define US_RANGE_602MM            13
#define US_RANGE_645MM            14
#define US_RANGE_688MM            15
#define US_RANGE_731MM            16
#define US_RANGE_774MM            17
#define US_RANGE_817MM            18
#define US_RANGE_860MM            19
#define US_RANGE_903MM            20
#define US_RANGE_946MM            21
#define US_RANGE_989MM            22
#define US_RANGE_1032MM            23
#define US_RANGE_1075MM            24
#define US_RANGE_1118MM            25
#define US_RANGE_1161MM            26
#define US_RANGE_1204MM            27
#define US_RANGE_1247MM            28
#define US_RANGE_1290MM            29
#define US_RANGE_1333MM            30
#define US_RANGE_1376MM            31
#define US_RANGE_1419MM            32
#define US_RANGE_1462MM            33
#define US_RANGE_1505MM            34
#define US_RANGE_1548MM            35
#define US_RANGE_1591MM            36
#define US_RANGE_1634MM            37
#define US_RANGE_1677MM            38
#define US_RANGE_1720MM            39
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
#define US_RANGE_9718MM            225
#define US_RANGE_9761MM            226
#define US_RANGE_9804MM            227
#define US_RANGE_9847MM            228
#define US_RANGE_9890MM            229
#define US_RANGE_9933MM            230
#define US_RANGE_9976MM            231
#define US_RANGE_10019MM            232
#define US_RANGE_10062MM            233
#define US_RANGE_10105MM            234
#define US_RANGE_10148MM            235
#define US_RANGE_10191MM            236
#define US_RANGE_10234MM            237
#define US_RANGE_10277MM            238
#define US_RANGE_10320MM            239
#define US_RANGE_10363MM            240
#define US_RANGE_10406MM            241
#define US_RANGE_10449MM            242
#define US_RANGE_10492MM            243
#define US_RANGE_10535MM            244
#define US_RANGE_10578MM            245
#define US_RANGE_10621MM            246
#define US_RANGE_10664MM            247
#define US_RANGE_10707MM            248
#define US_RANGE_10750MM            249
#define US_RANGE_10793MM            250
#define US_RANGE_10836MM            251
#define US_RANGE_10879MM            252
#define US_RANGE_10922MM            253
#define US_RANGE_10965MM            254
#define US_RANGE_11008MM            255

#define US_RANGE_INIT                US_RANGE_6020MM


#define US_NO_RESPONSE        0xFF


#endif /* US_SRF08_H_ */
