tud-pses/ucboard/fw_workspace/pses_ucboard/stmcommon/spimgr.c

#include "stm32f3xx.h"

#include "stm32f3xx_hal_spi.h"
#include "stm32f3xx_hal_gpio.h"

#include "spimgr.h"
#include "stdtypes.h"

#include "stm32_llm.h"


#define SPIMGR_NSPI 4

typedef struct SPIMGR_SPI
{
    SPI_TypeDef* pSPI;
    uint8_t uCurConfig;
} SPIMGR_SPI_t;

static SPIMGR_SPI_t f_aSPI[SPIMGR_NSPI] = {{SPI1, 0}, {SPI2, 0}, {NULL, 0}, {SPI4, 0}};

typedef struct SPIMGR_SPI_Pins
{
    GPIO_TypeDef* portSCK;
    uint16_t pinSCK;
    GPIO_TypeDef* portMISO;
    uint16_t pinMISO;
    GPIO_TypeDef* portMOSI;
    uint16_t pinMOSI;
} SPIMGR_SPI_Pins_t;

//static const SPIMGR_SPI_Pins_t f_aSPIPINS[SPIMGR_NSPI] = {
//                    {GPIOA, GPIO_PIN_5, GPIOA, GPIO_PIN_6, GPIOA, GPIO_PIN_7},
//                    {GPIOB, GPIO_PIN_13, GPIOB, GPIO_PIN_14, GPIOB, GPIO_PIN_15},
//                    {NULL, 0, NULL, 0, NULL, 0},
//                    {GPIOE, GPIO_PIN_12, GPIOE, GPIO_PIN_5, GPIOE, GPIO_PIN_6} };


typedef struct SPIMGR_Device
{
    bool bInit;
    EnSPI_PORT_t eSPIPort;
    uint8_t uSPIConfig;
    GPIO_TypeDef* pCSPort;
    uint16_t uCSPin;
    EnSPI_CS_IdlePol_t eIdlePol;
} SPIMGR_Device_t;

#define SPIMGR_MAXDEVICES 10

static SPIMGR_Device_t f_aDevices[SPIMGR_MAXDEVICES];


#define SPIMGR_MAXCONFIGS 11
static SPI_InitTypeDef f_aSPIConfigs[SPIMGR_MAXCONFIGS];
static uint8_t f_nConfigs;

static bool addSPIConfig(const SPI_InitTypeDef* pstConfig, uint8_t* pConfigID);
static void changeConfig(EnSPI_PORT_t eSPIPort, uint8_t uConfigID);


// Konfiguration der GPIOs
// Konfiguration der SPIs
void spimgr_init()
{
    //GPIO_InitTypeDef GPIO_InitStructure;
    SPI_InitTypeDef  SPI_InitStructure;
    uint8_t u;
    uint8_t uConfigID;

    f_nConfigs = 0;

    // Standardkonfiguration
    // Prescaler von 256 -> Taktlänge 7µs   (143 kHz)
    // Prescaler von 128 -> Taktlänge 3,5µs (280 kHz)
    // Prescaler von  64 -> Taktlänge 1,7µs (570 kHz)
    // Prescaler von  32 -> Taktlänge 0,8µs (1,2 MHz)
    // Prescaler von  16 -> Taktlänge 0,8µs (2,4 MHz)
    // Prescaler von  8 -> Taktlänge 0,8µs (4,8 MHz)
    // Prescaler von  4 -> Taktlänge 0,8µs (9,6 MHz)
      SPI_InitStructure.BaudRatePrescaler = SPI_BAUDRATEPRESCALER_64;
    SPI_InitStructure.CLKPhase = SPI_PHASE_2EDGE;
    SPI_InitStructure.CLKPolarity = SPI_POLARITY_HIGH;
    SPI_InitStructure.DataSize = SPI_DATASIZE_8BIT;
    SPI_InitStructure.Direction = SPI_DIRECTION_2LINES;
    SPI_InitStructure.FirstBit = SPI_FIRSTBIT_MSB;
    SPI_InitStructure.Mode = SPI_MODE_MASTER;
    SPI_InitStructure.NSS = SPI_NSS_SOFT;
    SPI_InitStructure.NSSPMode = SPI_NSS_PULSE_DISABLE;
    SPI_InitStructure.CRCCalculation = SPI_CRCCALCULATION_DISABLE;
    SPI_InitStructure.CRCPolynomial = 7;
    SPI_InitStructure.CRCLength = SPI_CRC_LENGTH_DATASIZE;
    SPI_InitStructure.TIMode = SPI_TIMODE_DISABLE;

    addSPIConfig(&SPI_InitStructure, &uConfigID);

    for (u = 0; u < SPIMGR_MAXDEVICES; u++)
    {
        f_aDevices[u].bInit = false;
    }

    for (u = 0; u < SPIMGR_NSPI; u++)
    {
        if (f_aSPI[u].pSPI == NULL)
        {
            continue;
        }

//        // PINS
//        // SCK
//        GPIO_InitStructure.Pin = f_aSPIPINS[u].pinSCK;
//        GPIO_InitStructure.Speed = GPIO_SPEED_FREQ_HIGH;
//        GPIO_InitStructure.Mode = GPIO_MODE_AF_PP;
//        HAL_GPIO_Init( f_aSPIPINS[u].portSCK, &GPIO_InitStructure );
//
//        // MISO
//        GPIO_InitStructure.Pin = f_aSPIPINS[u].pinMISO;
//        GPIO_InitStructure.Speed = GPIO_SPEED_FREQ_HIGH;
//        GPIO_InitStructure.Mode = GPIO_MODE_INPUT;
//        HAL_GPIO_Init( f_aSPIPINS[u].portMISO, &GPIO_InitStructure );
//
//        // MOSI
//        GPIO_InitStructure.Pin = f_aSPIPINS[u].pinMOSI;
//        GPIO_InitStructure.Speed = GPIO_SPEED_FREQ_HIGH;
//        GPIO_InitStructure.Mode = GPIO_MODE_AF_PP;
//        HAL_GPIO_Init( f_aSPIPINS[u].portMOSI, &GPIO_InitStructure );


        __SPI_Init( f_aSPI[u].pSPI, &f_aSPIConfigs[uConfigID] );
        __SPI_ENABLE( f_aSPI[u].pSPI );
    }

    return;
}


EnSPIMgrRes_t spimgr_addDevice(EnSPI_PORT_t eSPIPort, SPI_InitTypeDef* pstConfig,
                                    char cCSPort, uint8_t uCSPin,
                                    EnSPI_CS_IdlePol_t eIdlePol,
                                    uint8_t* puDeviceID)
{
    GPIO_InitTypeDef GPIO_InitStructure;
    GPIO_TypeDef* pCSPort;
    SPIMGR_Device_t* pDevice;
    uint8_t uConfigID;
    uint8_t d;

    if (eSPIPort >= SPIMGR_NSPI)
    {
        return SPIMGRRES_INVALIDPORT;
    }

    if (f_aSPI[eSPIPort].pSPI == NULL)
    {
        return SPIMGRRES_UNMANAGEDPORT;
    }


    // Freien Platz für Gerät suchen
    for (d = 0; d < SPIMGR_MAXDEVICES; d++)
    {
        if (!f_aDevices[d].bInit)
        {
            break;
        }
    }

    if (d == SPIMGR_MAXDEVICES)
    {
        return SPIMGRRES_MAXDEVICESREACHED;
    }

    if (!addSPIConfig(pstConfig, &uConfigID))
    {
        return SPIMGRRES_MAXCONFIGSREACHED;
    }


    switch (cCSPort)
    {
        case 'A':    pCSPort = GPIOA; break;
        case 'B':    pCSPort = GPIOB; break;
        case 'C':    pCSPort = GPIOC; break;
        case 'D':    pCSPort = GPIOD; break;
        case 'E':    pCSPort = GPIOE; break;
        case 'F':    pCSPort = GPIOF; break;
        case 'G':    pCSPort = GPIOG; break;
        default:    return SPIMGRRES_INVALIDPARAMS;
    }

    pDevice = &f_aDevices[d];

    pDevice->bInit = true;
    pDevice->eSPIPort = eSPIPort;
    pDevice->uSPIConfig = uConfigID;
    pDevice->pCSPort = pCSPort;
    pDevice->uCSPin = (1 << uCSPin);
    pDevice->eIdlePol = eIdlePol;

    *puDeviceID = d;


    // CS-Pin konfigurieren
    GPIO_InitStructure.Pin = pDevice->uCSPin;
    GPIO_InitStructure.Speed = GPIO_SPEED_FREQ_HIGH;
    GPIO_InitStructure.Mode = GPIO_MODE_OUTPUT_PP;
    HAL_GPIO_Init( pDevice->pCSPort, &GPIO_InitStructure );


    if (pDevice->eIdlePol == SPICSIDLEPOL_HIGH)
    {
        __GPIO_SET_BITS(pDevice->pCSPort, pDevice->uCSPin);
    }
    else
    {
        __GPIO_RESET_BITS(pDevice->pCSPort, pDevice->uCSPin);
    }


    return SPIMGRRES_OK;
}


static bool addSPIConfig(const SPI_InitTypeDef* pstConfig, uint8_t* pConfigID)
{
    uint8_t u;
    bool bFound;
    SPI_InitTypeDef* pCurConfig;

    bFound = false;

    for (u = 0; u < f_nConfigs; u++)
    {
        pCurConfig = &f_aSPIConfigs[u];

        if ( (pstConfig->BaudRatePrescaler == pCurConfig->BaudRatePrescaler)
                && (pstConfig->CLKPhase == pCurConfig->CLKPhase)
                && (pstConfig->CLKPolarity == pCurConfig->CLKPolarity)
                && (pstConfig->CRCCalculation == pCurConfig->CRCCalculation)
                && (pstConfig->CRCLength == pCurConfig->CRCLength)
                && (pstConfig->CRCPolynomial == pCurConfig->CRCPolynomial)
                && (pstConfig->DataSize == pCurConfig->DataSize)
                && (pstConfig->Direction == pCurConfig->Direction)
                && (pstConfig->FirstBit == pCurConfig->FirstBit)
                && (pstConfig->Mode == pCurConfig->Mode)
                && (pstConfig->NSS == pCurConfig->NSS)
                && (pstConfig->NSSPMode == pCurConfig->NSSPMode)
                && (pstConfig->TIMode == pCurConfig->TIMode))
        {
            *pConfigID = u;
            bFound = true;
            break;
        }
    }

    if (bFound)
    {
        return true;
    }
    else if (f_nConfigs > SPIMGR_MAXCONFIGS)
    {
        return false;
    }
    else
    {
        pCurConfig = &f_aSPIConfigs[f_nConfigs];

        pCurConfig->BaudRatePrescaler = pstConfig->BaudRatePrescaler;
        pCurConfig->CLKPhase = pstConfig->CLKPhase;
        pCurConfig->CLKPolarity = pstConfig->CLKPolarity;
        pCurConfig->CRCCalculation = pstConfig->CRCCalculation;
        pCurConfig->CRCLength = pstConfig->CRCLength;
        pCurConfig->CRCPolynomial = pstConfig->CRCPolynomial;
        pCurConfig->DataSize = pstConfig->DataSize;
        pCurConfig->Direction = pstConfig->Direction;
        pCurConfig->FirstBit = pstConfig->FirstBit;
        pCurConfig->Mode = pstConfig->Mode;
        pCurConfig->NSS = pstConfig->NSS;
        pCurConfig->NSSPMode = pstConfig->NSSPMode;
        pCurConfig->TIMode = pstConfig->TIMode;

        *pConfigID = f_nConfigs;
        f_nConfigs++;

        return true;
    }
}

EnSPIMgrRes_t spimgr_send16(uint8_t device, uint16_t txdata, uint16_t* pRxdata)
{
    SPI_TypeDef* pSPI;
    SPIMGR_Device_t* pDevice;

    pDevice = &f_aDevices[device];

    if ( (device >= SPIMGR_MAXDEVICES) || (!pDevice->bInit) )
    {
        return SPIMGRRES_INVALIDDEVICE;
    }


    pSPI = f_aSPI[pDevice->eSPIPort].pSPI;

    if ( f_aSPI[pDevice->eSPIPort].uCurConfig != pDevice->uSPIConfig )
    {
        changeConfig(pDevice->eSPIPort, pDevice->uSPIConfig);
    }

    if (pDevice->eIdlePol == SPICSIDLEPOL_HIGH)
    {
        __GPIO_RESET_BITS(pDevice->pCSPort, pDevice->uCSPin);
    }
    else
    {
        __GPIO_SET_BITS(pDevice->pCSPort, pDevice->uCSPin);
    }

    __SPI_SEND_DATA( pSPI, txdata );

    // auf Daten warten
    while ( __SPI_GET_FLAG(pSPI, SPI_FLAG_RXNE) == RESET )
    {
        // * do nothing *
    }

    if (pRxdata)
    {
        *pRxdata = __SPI_RECEIVE_DATA( pSPI );
    }
    else
    {
        //pSPI->SR
        __SPI_RECEIVE_DATA( pSPI );
    }

    if (pDevice->eIdlePol == SPICSIDLEPOL_HIGH)
    {
        __GPIO_SET_BITS(pDevice->pCSPort, pDevice->uCSPin);
    }
    else
    {
        __GPIO_RESET_BITS(pDevice->pCSPort, pDevice->uCSPin);
    }

    return SPIMGRRES_OK;
}


EnSPIMgrRes_t spimgr_send16Mult(uint8_t uDeviceID,
                                            uint16_t nWords,
                                            const uint16_t* paTxdata,
                                            uint16_t* paRxdata)
{
    uint16_t u;
    SPI_TypeDef* pSPI;
    SPIMGR_Device_t* pDevice;

    pDevice = &f_aDevices[uDeviceID];

    if ( (uDeviceID >= SPIMGR_MAXDEVICES) || (!pDevice->bInit) )
    {
        return SPIMGRRES_INVALIDDEVICE;
    }


    pSPI = f_aSPI[pDevice->eSPIPort].pSPI;

    if ( f_aSPI[pDevice->eSPIPort].uCurConfig != pDevice->uSPIConfig )
    {
        changeConfig(pDevice->eSPIPort, pDevice->uSPIConfig);
    }


    if (pDevice->eIdlePol == SPICSIDLEPOL_HIGH)
    {
        __GPIO_RESET_BITS(pDevice->pCSPort, pDevice->uCSPin);
    }
    else
    {
        __GPIO_SET_BITS(pDevice->pCSPort, pDevice->uCSPin);
    }

    for (u = 0; u < nWords; u++)
    {
        __SPI_SEND_DATA(pSPI, *paTxdata++ );

        // auf Daten warten
        while ( __SPI_GET_FLAG_STATUS( pSPI, SPI_FLAG_RXNE ) == RESET )
        {
            /* do nothing */
        }

        if (paRxdata)
        {
            *paRxdata++ = __SPI_RECEIVE_DATA( pSPI );
        }
        else
        {
            __SPI_RECEIVE_DATA( pSPI );
        }
    }


    if (pDevice->eIdlePol == SPICSIDLEPOL_HIGH)
    {
        __GPIO_SET_BITS(pDevice->pCSPort, pDevice->uCSPin);
    }
    else
    {
        __GPIO_RESET_BITS(pDevice->pCSPort, pDevice->uCSPin);
    }

    return SPIMGRRES_OK;
}


EnSPIMgrRes_t spimgr_send8(uint8_t device, uint8_t txdata, uint8_t* pRxdata)
{
    SPI_TypeDef* pSPI;
    SPIMGR_Device_t* pDevice;

    pDevice = &f_aDevices[device];

    if ( (device >= SPIMGR_MAXDEVICES) || (!pDevice->bInit) )
    {
        return SPIMGRRES_INVALIDDEVICE;
    }

    pSPI = f_aSPI[pDevice->eSPIPort].pSPI;

    if ( f_aSPI[pDevice->eSPIPort].uCurConfig != pDevice->uSPIConfig )
    {
        changeConfig(pDevice->eSPIPort, pDevice->uSPIConfig);
    }

    if (pDevice->eIdlePol == SPICSIDLEPOL_HIGH)
    {
        __GPIO_RESET_BITS(pDevice->pCSPort, pDevice->uCSPin);
    }
    else
    {
        __GPIO_SET_BITS(pDevice->pCSPort, pDevice->uCSPin);
    }

    __SPI_SEND_DATA8BIT(pSPI, txdata);

    // auf Daten warten
    while ( __SPI_GET_FLAG(pSPI, SPI_FLAG_RXNE) == RESET )
    {
        // * do nothing *
    }

    if (pRxdata)
    {
        *pRxdata = __SPI_RECEIVE_DATA8BIT(pSPI);
    }
    else
    {
        __SPI_RECEIVEIGNORE_DATA8BIT(pSPI);
    }

    if (pDevice->eIdlePol == SPICSIDLEPOL_HIGH)
    {
        __GPIO_SET_BITS(pDevice->pCSPort, pDevice->uCSPin);
    }
    else
    {
        __GPIO_RESET_BITS(pDevice->pCSPort, pDevice->uCSPin);
    }

    return SPIMGRRES_OK;
}
#include "display.h"

EnSPIMgrRes_t spimgr_send8Mult(uint8_t uDeviceID,
                                            uint16_t nTxWords,
                                            const uint8_t* paTxdata,
                                            uint16_t nRxWords,
                                            uint16_t nRxSkipFirstWords,
                                            uint8_t* paRxdata)
{
    uint16_t u;
    SPI_TypeDef* pSPI;
    SPIMGR_Device_t* pDevice;

    pDevice = &f_aDevices[uDeviceID];

    if ( (uDeviceID >= SPIMGR_MAXDEVICES) || (!pDevice->bInit) )
    {
        return SPIMGRRES_INVALIDDEVICE;
    }


    pSPI = f_aSPI[pDevice->eSPIPort].pSPI;

    if ( f_aSPI[pDevice->eSPIPort].uCurConfig != pDevice->uSPIConfig )
    {
        changeConfig(pDevice->eSPIPort, pDevice->uSPIConfig);
    }


    if (pDevice->eIdlePol == SPICSIDLEPOL_HIGH)
    {
        __GPIO_RESET_BITS(pDevice->pCSPort, pDevice->uCSPin);
    }
    else
    {
        __GPIO_SET_BITS(pDevice->pCSPort, pDevice->uCSPin);
    }

    uint16_t nWords = (nTxWords >= nRxWords) ? nTxWords : nRxWords;

    for (u = 0; u < nWords; u++)
    {
        if (u < nTxWords)
        {
            __SPI_SEND_DATA8BIT(pSPI, *paTxdata++);
        }
        else
        {
            __SPI_SEND_DATA8BIT(pSPI, 0);
        }

        // auf Daten warten
        while ( __SPI_GET_FLAG_STATUS( pSPI, SPI_FLAG_RXNE ) == RESET )
        {
            /* do nothing */
        }

        if ( (paRxdata) && ((u >= nRxSkipFirstWords) && (u < nRxWords)) )
        {
            *paRxdata++ = __SPI_RECEIVE_DATA8BIT(pSPI);
        }
        else
        {
            __SPI_RECEIVEIGNORE_DATA8BIT(pSPI);
        }
    }


    if (pDevice->eIdlePol == SPICSIDLEPOL_HIGH)
    {
        __GPIO_SET_BITS(pDevice->pCSPort, pDevice->uCSPin);
    }
    else
    {
        __GPIO_RESET_BITS(pDevice->pCSPort, pDevice->uCSPin);
    }

    return SPIMGRRES_OK;
}


static void changeConfig(EnSPI_PORT_t eSPIPort, uint8_t uConfigID)
{
    __SPI_DISABLE( f_aSPI[eSPIPort].pSPI );
    __SPI_Init( f_aSPI[eSPIPort].pSPI, &f_aSPIConfigs[uConfigID] );
    __SPI_ENABLE( f_aSPI[eSPIPort].pSPI );

    f_aSPI[eSPIPort].uCurConfig = uConfigID;

    return;
}
