tud-pses/ucboard/fw_workspace/pses_ucboard/devices/carbasicfcts.h

/*
 * carbasicfcts.h
 *
 *  Created on: 16.09.2016
 *      Author: elenz
 */

#ifndef CARBASICFCTS_H_
#define CARBASICFCTS_H_

#include "stdtypes.h"

void car_init();

void car_do_systick();

void car_setSteering(int16_t val);


#endif /* CARBASICFCTS_H_ */
