tud-pses/ucboard/(commit log)

2016-08-18 Aktueller Stand von Andreas Jentsch in Repository eingecheckt
    [Microcontroller_Sensorik.kicad_pcb, Microcontroller_Sensorik.sch, Microcontroller_Sensorik_Teileliste.xlsx, Schalter_Fahrakku.kicad_pcb, Schalter_Fahrakku.sch, Schalter_Fahrakku_Teileliste.xlsx]
2016-08-18 -Anforderungen Tabelle hinzugefügt
    [Anforderungen uC-Platine.xlsx]
2016-08-21 -Opa Schaltung eingefügt
    [Microcontroller_Sensorik.sch]
2016-08-21 - 4-Weg Kreunzungen entfernt - 3V3 und 5V an allen Zusatzanschlüssen vorgesehen - Ferrit zur Entkopplung zwischen GND-GNDA und VDD-VDDA vorgesehen - Ansteuerung TEN 30-1212 überarbeitet
    [Microcontroller_Sensorik.sch, Microcontroller_Sensorik_Teileliste.xlsx]
2016-08-26 - Diverse Footprints hinzugefügt - Bauteile mit Footprints verknüpft - Fehler in Spannungsversorgung beseitigt - Teileliste aktualisiert
    [Microcontroller_Sensorik.sch, Microcontroller_Sensorik_Teileliste.xlsx]
2016-08-28 - Restliche Footprints hinzugefügt und verknüpft
    [Microcontroller_Sensorik.sch]
2016-08-28 - Neue anschlüsse in Schalterplatine eingefügt
    [Schalter_Fahrakku.kicad_pcb, Schalter_Fahrakku.sch]
2016-08-29 - RC-Glieder an ADC hinzugefügt - Wannenstecker mit Spannungsversorgung an Op-Amps hinzugefügt - 0R Widerstände an Op-Amp Ausgängen hinzugefügt
    [Microcontroller_Sensorik.sch, Microcontroller_Sensorik_Teileliste.xlsx, Schalter_Fahrakku.kicad_pcb]
2016-08-29 - Schaltplan uCSensorik finalisiert (1 pin an uC Frei geworden) - ERC wirft 8 Warnungen, keine Fehler
    [Microcontroller_Sensorik.kicad_pcb, Microcontroller_Sensorik.sch, Microcontroller_Sensorik_Teileliste.xlsx, Schalter_Fahrakku.kicad_pcb]
2016-08-30 - Layout Grob sortiert - Fehler an CAR-ID DIP behoben(Pin Zuordnung Fehlerhaft) - Fehler an GNDD behoben (GNDA und GNDD vertauscht an TEN30)
    [Microcontroller_Sensorik.kicad_pcb, Microcontroller_Sensorik.sch, Schalter_Fahrakku.kicad_pcb]
2016-08-30 - Groblayout angepasst - Routen begonnen
    [Microcontroller_Sensorik.kicad_pcb, Microcontroller_Sensorik.sch]
2016-08-31 - Layout fortgesetzt
    [Microcontroller_Sensorik.kicad_pcb]
2016-09-01 - RC-Glieder im Schaltplan hinzugefügt - LED4 Hinzugefügt
    [Microcontroller_Sensorik.kicad_pcb, Microcontroller_Sensorik.sch, Microcontroller_Sensorik_Teileliste.xlsx, Schalter_Fahrakku.kicad_pcb, Schalter_Fahrakku.sch]
2016-09-01 - 5V_Servo Zusätzlich zur verfügung gestellt - Footprints für Pinleisten mit Verrigelung Hinzugefügt
    [Microcontroller_Sensorik.kicad_pcb, Microcontroller_Sensorik.sch, Microcontroller_Sensorik_Teileliste.xlsx, Schalter_Fahrakku.kicad_pcb, Schalter_Fahrakku.sch]
2016-09-01 - Layout Schalterplatine ohne Routing
    [Schalter_Fahrakku.kicad_pcb, Schalter_Fahrakku.sch]
2016-09-01 - Routing fortgesetzt
    [Microcontroller_Sensorik.kicad_pcb]
2016-09-02 - BATT2_IN Doppelt belegt - LDO Regler ausgetauscht
    [Microcontroller_Sensorik.kicad_pcb, Microcontroller_Sensorik.sch, Microcontroller_Sensorik_Teileliste.xlsx]
2016-09-02 - Routing
    [Microcontroller_Sensorik.kicad_pcb]
2016-09-05 Datenblätter STM32 und DCDC-Wandler TEN 30 hinzugefügt
2016-09-05 Datei des Reference-Manual vom STM32 umbenannt
2016-09-05 Projektdatei für STM32CubeMX hinzugefügt
2016-09-05 - TIM20_CH1 und CH2 mit TIM1_CH3 und CH4 ersetzt - WAGO713_1403 (grade) mit WAGO_713-1423 (gewinkelt) ersetzt - Footprint TEN30 angepasst um Platz für Kühlkörper zu lassen - Routing Fortgesetzt
    [Microcontroller_Sensorik.kicad_pcb, Microcontroller_Sensorik.sch]
2016-09-05 - Layout Schalterplatine
    [Schalter_Fahrakku.kicad_pcb]
2016-09-06 Änderung an STM32-Konfiguration: - PC2 und PC3 auf TIM1_CH3 und TIM1_CH4 - Eingänge je nach Funktion auf Pull-up oder Pull-down gestellt.
2016-09-06 Workspace-Verzeichnis für "System Workbench for STM32" (eclipse) erstellt
2016-09-06 Code aus stm32cubemx erstellt und in System Workbench importiert
2016-09-06 - "Index unused headers" deaktiviert, damit kein Fehler bei SysTick_IRQn angezeigt wird
2016-09-06 - Email umgesetzt - Sperrflächen eingefügt
    [Microcontroller_Sensorik.kicad_pcb, Microcontroller_Sensorik.sch]
2016-09-06 - Sperrflächen verschoben
    [Microcontroller_Sensorik.kicad_pcb, Microcontroller_Sensorik.sch, Schalter_Fahrakku.kicad_pcb]
2016-09-06 -Sperrflächen nochmal verschoben
    [Microcontroller_Sensorik.kicad_pcb]
2016-09-06 - Genauere Definition der Bauteil-Pins (Eingang, Ausgang, Bidirektional, Spannungseingang, Spannungsausgang) - Power-Flags neu gesetzt.
    [Microcontroller_Sensorik.sch]
2016-09-06 STM-Konfiguration geändert und neue Dateien für System Workbench generiert: - PF2, PF6, PF9, PF10 mit Pull-ups - PD15: ExtInt
2016-09-06 - Versorgungsspannung verbunden - Lötjumper für MPU_INT vorgesehen
    [Microcontroller_Sensorik.kicad_pcb, Microcontroller_Sensorik.sch, Schalter_Fahrakku.kicad_pcb]
2016-09-07 - Op-Amps an VDDA angeschlossen - Lötjumper zwischen PPC_-V und GNDA sowie PPC_-V und GND vorgesehen
    [Microcontroller_Sensorik.sch]
2016-09-07 - ERC fehler behoben
    [Microcontroller_Sensorik.kicad_pcb, Microcontroller_Sensorik.sch]
2016-09-07 - Lötstoppmaske angepasst - Durchkontaktierung für Masseverbindung hinzugefügt
    [Microcontroller_Sensorik.kicad_pcb, Microcontroller_Sensorik.sch]
2016-09-07 - GNDA und GNDPWR durchkontaktiert
    [Microcontroller_Sensorik.kicad_pcb]
2016-09-07 - Footprint TEN30 korrigiert
    [Microcontroller_Sensorik.kicad_pcb]
2016-09-07 - TSR1 korrigiert
    [Microcontroller_Sensorik.kicad_pcb]
2016-09-07 - Alle Elemente verbunden
    [Microcontroller_Sensorik.kicad_pcb]
2016-09-07 - Beschriftung zusätzliche spannungsversorgungen
    [Microcontroller_Sensorik.kicad_pcb]
2016-09-07 - MPU-9250 Footprint überarbeitet - DRC Fehler auf 0 reduziert
    [Microcontroller_Sensorik.kicad_pcb, Microcontroller_Sensorik.sch]
2016-09-07 - Masseflächen stärker verbunden
    [Microcontroller_Sensorik.kicad_pcb]
2016-09-07 - Schalterplatine finalisiert - Beiden Platinen TOP/BOTTOM markierungen hinzugefügt
    [Microcontroller_Sensorik.kicad_pcb, Schalter_Fahrakku.kicad_pcb]
2016-09-09 Beschriftungstext auf Unterseite gespiegelt
    [Schalter_Fahrakku.kicad_pcb]
2016-09-09 - Vias hinzugefügt - Ecke bei AGND-Fläche "abgeschnitten"
    [Microcontroller_Sensorik.kicad_pcb]
2016-09-09 - Pinzuordnung bei Winkelstecker geändert - Platinenbezeichnung in Kupfer eingebettet
    [Schalter_Fahrakku.kicad_pcb]
2016-09-09 Stub auf Unterseite entfernt
    [Schalter_Fahrakku.kicad_pcb]
2016-09-09 - Steckerbelegungen als Bestückungsdruck - Platinenbezeichnung in Kupfer geschrieben
    [Microcontroller_Sensorik.kicad_pcb]
2016-09-09 Bauteilbezeichnungen ergänzt
    [Microcontroller_Sensorik.sch]
2016-09-09 Pull-down bei BOOT0 hinzugefügt
    [Microcontroller_Sensorik.kicad_pcb, Microcontroller_Sensorik.sch]
2016-09-09 Steckerbelegungen auf Bestückungsdruck vervollständigt
    [Microcontroller_Sensorik.kicad_pcb]
2016-09-09 Beschriftungsdruck optimiert
    [Microcontroller_Sensorik.kicad_pcb]
2016-09-09 Datenblatt Wago-Stecker und DIP-Schalter hinzugefügt
2016-09-09 "Schalter_Fahrakku" in "drvbatswitch" umbenannt
    [drvbatswitch.kicad_pcb, drvbatswitch.sch, drvbatswitch_Teileliste.xlsx]
2016-09-09 Microcontroller_Sensorik in ucboard umbenannt
    [ucboard.kicad_pcb, ucboard.sch, ucboard_Teileliste.xlsx]
2016-09-09 ucboard-rescue.lib gelöscht und Referenz aus Projekt gelöscht. (Hatte nur eine Rescue-Version des MPU9250 enthalten, der im Schaltplan nicht verwendet wurde.)
2016-09-13 - Teileliste header angepasst
    [Microcontroller_Sensorik_Teileliste.xlsx]
2016-09-13 - Teilelisten aktualisiert - Exceldokument "Bestellisten.xlsx" in Verzeichnis doc aufgesetzt
    [Bestellisten.xlsx, drvbatswitch_Teileliste.xlsx, ucboard_Teileliste.xlsx]
2016-09-13 - Bestellisten angefangen
    [drvbatswitch_Teileliste.xlsx, ucboard_Teileliste.xlsx]
2016-09-14 - Bestellisten bis auf Spulen/Ferrite zur Entkopplung vervollständigt - Oberer Widerstand im Spannungsteiler an 7,2V von 16k auf 14k Reduziert (7,5V -> 3,3V)
    [ucboard.sch, ucboard_Teileliste.xlsx]
2016-09-16 spimgr hinzugefügt und für stm32f3x angepasst
2016-09-16 Eigene Low-Level-Macros in stm32_llm ausgelagert.
2016-09-16 (Leere) Dateien für Treiber Sensoren/Aktoren hinzugefügt.
2016-09-17 i2cmgr hinzugefügt und für stm32f3xx angepasst.
2016-09-18 stmcommon und devices zu Include-Pfaden hinzugefügt
2016-09-18 stm32f3xx_hal_i2c.h in Headerdatei included, damit alle Verwender diese automatisch auch includen (und damit die Definitionen der Konstanten für die Einstellungen haben)
2016-09-23 - Funktion atoi hinzugefügt - wait_us und wait_ms entfernt. Damit wird auch Stopwatch.h nicht mehr eingebunden, und es muss nicht stm32f3xx.h vor common_fcts.h included werden.
2016-09-23 Taster und LEDs definiert
2016-09-23 Test für Taster und LEDs in systick
2016-09-24 Initroutinen Comm und Display in main.c
2016-09-26 - Wert von R3 von 0R auf n.B. geändert
    [ucboard.kicad_pcb, ucboard.sch, ucboard_Teileliste.xlsx]
2016-09-27 - USART in Betrieb (USART2 getestet) - Bugs in Kommunikationsstack beseitigt
    [comm.c, comm_cmdtable.c, comm_public.h, main.c, sid.c, stm32_llm.h, systick.c]
2016-09-27 Funktionalität zum Schalten des 12V-Ausgangs hinzugefügt
2016-09-28 Fehler beim Zugriff auf nichtinitialisierte (bzw. zu 0 initialisierte Pointer behoben.(Warum dieser Fall überhaupt auftritt, müsste noch geklärt werden...)
    [comm.c]
2016-09-28 Ansteuerung Lenkung und Fahrmotor
2016-09-29 - i2cmgr in Betrieb genommen (Noch nicht hundertprozentig bugfrei... : Wenn alle I2C-Ports verwaltet werden, funktioniert US-Ping nicht. Die Daten können aber abgefragt werden.) - US angesprochen (no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
    [display.c, display.h, i2cmgr.c, i2cmgr_privatedefs.h, led.c, led.h]
2016-09-30 gemeinsames Abfragen aller US-Sensoren
2016-09-30 Für mögliche Fehler der USART3 die Interruptflags zurücksetzen, damit sich uC nicht aufhängt, wenn RS232 im Betrieb an- und ausgeschaltet (bzw. an- und abgesteckt) wird.
2016-09-30 - [wip] DAQ - Bugfix bei Display
    [carbasicfcts.c, comm.c, comm_cmdtable.c, comm_public.h, daq.c, daq.h]
2016-10-02 Failed-Mark nach Senden der entsprechenden Fehlermeldung wieder löschen. (Ansonsten werden ewig Fehlermeldungen geschickt.)
    [display.c]
2016-10-02 DAQ: ALL und ANY implementiert
2016-10-02 DAQ: Encoding und CRC hinzugefügt
2016-10-02 Bug in Display-Stream beseitigt (Rückgabewert *pbMsgComplete wurde nicht in allen Pfaden gesetzt.)
    [display.c]
2016-10-02 Analoge Bugs aus Display auch in DAQ beseitigt
    [daq.c]
2016-10-02 IMU aufgeräumt und Abfrage aller Werte (noch keine Magnetometerwerte!)
2016-10-03 Arbeit an Dokumentation der Kommunikation
2016-10-04 Einheit US-Messwerte in 0.1mm geändert
2016-10-04 Werte von DTICS16 und DTICS8 gesättigt
2016-10-04 Kanäle der Batteriespannungsmessungen umbenannt
2016-10-04 250 ms-Pause vor MPU-Init. (MPU braucht wohl eine gewisse Zeit, nach Einschalten der Spannungsversorgung einsatzbereit zu sein.)
2016-10-04 Auswertung Hall-Sensor über Interrupt.
2016-10-05 Samplingtime AD-Wandlung Batteriespannungsmessung von minimal auf maximal gestellt. Abtastzeit der Spannungsmessung auf eine Sekunde reduziert.
2016-10-07 Hall-Sensor auf PE15 umgestellt. (Entsprechender Pull-up zwischen Steckerpins eingelötet, C24 ausgelötet.)
2016-10-07 Änderungen bei Hall-Auswertung: - Zähler (mod 256) der Impulse, gerade = aktueller Wert 0, ungerade = aktueller Wert 1 - Zeit für komplette Umdrehung wird jeden Impuls ausgegeben.
2016-10-07 Anpassen Schaltplan an aktuelle Bestückung: - R22: 56k anstelle 14k - C24: n.B. anstelle 470n - R68: 10k Pull-up für Hallsensor hinzugefügt
    [ucboard.sch]
2016-10-08 - spimgr um Funktionen für 8bit-Frames erweitert. - imu-Kommunikation auf 8bit-Frames umgestellt
2016-10-11 - Automatische Auswahl der aktiven UART-Schnittstelle - SOT_TX ist \03 - Optionales Einfügen von zusätzlichem \n nach SOT_TX über Schalter - Fehler beseitigt, der zum doppelten Beenden eines RespStre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
2016-10-11 Abtastrate US-Sensoren erhöht (auf ca. 45 ms)
2016-10-11 - Verkleinerung des DAQ-Buffers - Setzen des "letzten Datensatzes" der Gruppenkanäle bei Starten der Datenerfassung auf aktuellen Tic-Wert - 1, so dass keine alten Daten verschickt werden.
2016-10-16 Wert bei Fahrtenreglerkalibrierung angepasst, damit der eine Satz für alle Fahrzeuge funktioniert.
2016-10-16 Bug beseitigt, der zur endlosen Ausgaben leerer Antworten geführt hat, wenn ein RespStream direkt "MsgComplete" gemeldet hat.
    [comm.c]
2016-10-16 - Ausgabe von Gruppeninfos aller aktiven Gruppen mit ?DAQ GRPS, Ausgabe von speziellen Gruppen mit ?DAQ GRP nb - Korrekte Behandlung von Specialchannels bei Generierung der Gruppeninfo
2016-10-16 Bug bei Ansteuerung Fahrtenregler beseitigt, der dazu geführt hat, dass trotz fehlerhaften Kontrollwert der erste Wert übernommen wurde.
    [carbasicfcts.c]
2016-10-16 Funktionen zum Löschen, Deaktivieren und Aktivieren von Gruppen hinzugefügt
2016-10-16 Neudefinition einer Gruppe nur dann, wenn diese inaktiv ist oder die Datenerfassung angehalten ist.
2016-10-16 - Sonderkanäle _TIC, _TIC16 und _TIC8 in _TICS, _TICS16 und _TICS8 umbenannt - Sonderkanäle _CNT, _CNT16 und _CNT8 hinzugefügt
2016-10-16 CKonfiguration wird neu an US-Sensoren geschickt, wenn der Wert 0 als Messwert zurück kommt. (Irgendwie scheint sich der Sensor damit immer auf die Startwerte zurückzusetzen.)
2016-10-16 Filter IMU eingestellt
2016-10-17 Fehlende Anpassung zu "Sonderkanäle _TIC, _TIC16 und _TIC8 in _TICS, _TICS16 und _TICS8 umbenannt"
2016-10-17 - Gruppenweise DAQ-Puffer eingeführt: Es wird nur noch jeweils die aktuelle Abtastung einer Gruppe übertragen. - Sonderkanäle _DLY, _DLY16 und _DLY8 hinzugefügt
2016-10-17 Abprüfen, dass maximale Anzahl an Gruppenkanälen nicht überschritten wird
2016-10-17 Erhöhen der Anzahl an String-Splits und Argumenten
2016-10-17 Funktionialität zum messen der maximalen SysTick-Zeit (auskommentiert)
2016-10-17 - Mit Beschreibung der Hardware begonnen - Beschreibung Kommunikation an aktuellen Stand der Implementierung angepasst
2016-10-18 _DLY8 in _DLY umbenannt, (altes) _DLY und _DLY16 entfernt. _DLY wird bei 255 gesättigt.
2016-10-18 Baudrate UART2 (USB) auf 921600 gestellt
2016-10-20 LED_A_ON() bei Datenempfang über RS232-UART enfernt
2016-10-20 Bug beseitigt, der bei Mittelung der Daten bei mehr als einem Kanal aufgetreten ist
    [daq.c]
2016-10-21 - Beschreibung Einrichtung Entwicklungsumgebung - Änderung der Strukturierung der Dokumentation
2016-10-21 Aktuellen Stand der Dokumentation als PDF in Hauptverzeichnis
2016-10-24 Befehl !STEER und ?STEER geben jetzt die Stellwerte ([-1000, 1000]) und nicht die daraus berechneten "PWM-Werte" ([-500, 500]) zurück.
2016-10-25 pdf-Datei der Dokumentation aktualisiert
2016-10-25 PDF mit aktueller Version des Schaltplans hinzugefügt.
2016-10-25 Richtungsangabe y-Achse IMU in Dokumentation korrigiert
2016-10-31 ucterm hinzugefügt: Einfaches Terminalprogramm in C# (Windows) zum Testen des ucboards
2016-10-31 Bug beseitigt, der zu fehlerhaften Übertragungen geführt hat (Vermischen von Nachrichten)
    [comm.c]
2016-10-31 - Anzeigen der Daten über einen Timer realisiert, um Einfrieren bei großen Datenmengen zu vermeiden - Kleinere Änderungen am Format
2016-11-01 Korrektur im Kommunikationsstack (Fehler könnte in sehr unwahrscheinlichen Fällen zu Fehlern bei der Datenübertragung führen)
2016-11-01 Befehl US hinzugefügt: Ein- und Ausschalten sowie Parametrieren der US-Sensoren
2016-11-01 Funktionalität des Befehls US beschrieben.
2016-11-03 Bug in cmd_us korrigiert
    [us.c]
2016-11-03 Befehl IMU zurm Einstellen und Abfragen der Sensorkonfiguration hinzugefügt
2016-11-03 Fehler bei UART-Kommunikation komplett ignorieren (sollte die Robustheit erhöhen, muss noch ausgetestet werden)
2016-11-03 STEER: Behandlung der doppelten Übertragung des Wertes hinzugefügt
2016-11-03 Dokumentation zu Befehl IMU hinzugefügt
2016-11-03 Dokumentation zur doppelten Übertragung des STEER-Wertes schwarz geschrieben
2016-11-07 GFILT: Alle Einstellungen des Sensor unterstützt ([-2, 7])
2016-11-07 Erläuterungen zu Filtereinstellungen ergänzt
2016-11-07 Klasse zur Ansteruerung des ucboards aus Matlab aus hinzugefügt, mit Beispielanwendung
2016-11-26 Datenblatt zu integriertem Magnetsensor hinzugefügt
2016-11-26 [wip] Inbetriebnahme Magnetometer
    [wip] Inbetriebnahme Magnetometer
    Andere Achsenorientierung Magnetometer gegenüber IMU berücksichtigt
    Magnetometer in Betrieb genommen. !MAG OPT USEASA und ?MAG ASA hinzugefügt
    Magnetometer: Overflow-Bit in ST2 berücksichtigt und Kanalbeschreibung vervollständigt
2016-11-26 Matlab-Skript zur Inbetriebnahme Magnetometer
2016-11-26 Beschreibung Magnetometer
2017-11-03 - Methoden-Benennung an C#-Standard angepasst - Maximal in Anzeige gehaltene Textmenge deutlich reduziert - Anzeige der fehlerhaften Nachrichten (d.h. ohne zuordnenbares Startzeichen) hinzugefügt
2017-11-07 - accounting for that the EOT-marker length is currently 2, i.e. EOT + \n (and not just 1)
2017-11-09 - Bug fixed: - Check if ORE is set and reset it if that is the case. (ORE is active if either RXNEIE or EIE is set. This caused infinity calls to the irq handler if one ORE event occurs.) - All unuse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
    [comm.c, comm_cmdtable.c, main.c]
2017-12-13 - i2cmgr: Reset any error flag before exiting isr. - debug-command added
    [comm_cmdtable.c, i2cmgr.c]
2017-12-13 current version of ucboard.pdf
2018-02-14 - UART3 deaktiviert
2018-02-14 i2cmgr: StateMachines revisited and debugged
2018-02-14 Feststellen, welche US-Device nicht initialisiert werden konnten und diese nicht weiter abfragen
2018-02-16 function i2cmgr_removeDevice added
2018-02-16 functionality added to ping us devices and to change the i2c address of a us device
2018-05-15 In Kicad geänderte Bauteile "gerettet".
    [ucboard.sch]
2018-05-15 Spezifikation D1-D6, L2+L3 nachgetragen
    [ucboard.sch]
2018-05-15 In Kicad geänderte Symbole "gerettet".
    [drvbatswitch.sch]
2018-05-15 Spezifikation D1 nachgetragen.
    [drvbatswitch.sch]
2018-05-18 - R47, R48 -> n.B. (Programmierung über USB wird nicht verwendet) - C13, C19 -> n.B. (Vermeiden des Einkoppelns von Störungen bei stark gestörten Versorgungsspannungen auf Masse)
    [ucboard.sch]
2018-05-20 Änderung der beim Öffnen eingeblendeten Layer
    [ucboard.kicad_pcb]
2018-07-13 Beschreibung der LED- und Taster-Funktionalität
2018-07-13 Maximale Anzahl der Parameter/Optionen eines Befehls von 20 auf 22 erhöht.
2018-07-13 Implementierung der LED- und Taster-Funktionalität
2018-07-22 Bestückungsdruck korrigiert: R20 <=> R66
    [ucboard.kicad_pcb]
2019-02-15 - tabs replaced by four spaces - trailing whitespaces removed
    [atomicsection.h, carbasicfcts.c, carid.c, carui.c, comm.c, comm_cmdtable.c]
2019-02-15 bugfix for i2cmgr (mostly in getNextMsg) from quadrokopter project applied
    [i2cmgr.c, i2cmgr_privatedefs.h]
