tud-pses/ucboard/(notices)

Notices in the files:
fw_workspace/pses_ucboard/Src/main.c:
(C) COPYRIGHT STMicroelectronics *****END OF FILE
